akeshet/New-Machine-Drawings/matlab simulations/Slower Design -- Wujie/Readme.txt

The main file with slower simulation is Revised_New_zeeman_design.m
