akeshet/New-Machine-Drawings/matlab simulations/magnetic trap design/README.txt

New magnetic trap design for Bec2 is in New_magtrap_design.m.
