akeshet/New-Machine-Drawings/matlab simulations/magnetic trap design/html/feschbach_coils_01.png

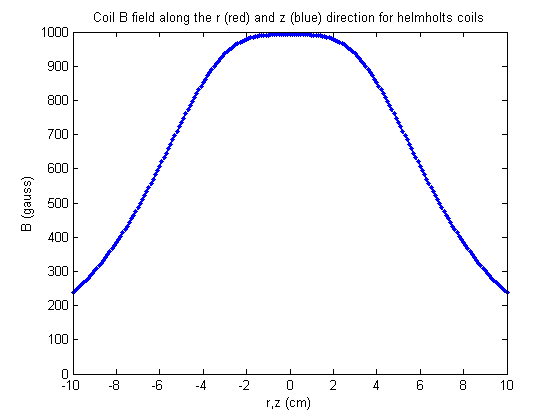
matlab simulations/magnetic trap design/html/feschbach_coils_01.png
