akeshet/New-Machine-Drawings/matlab simulations/magnetic trap design/Magtrap.jpg

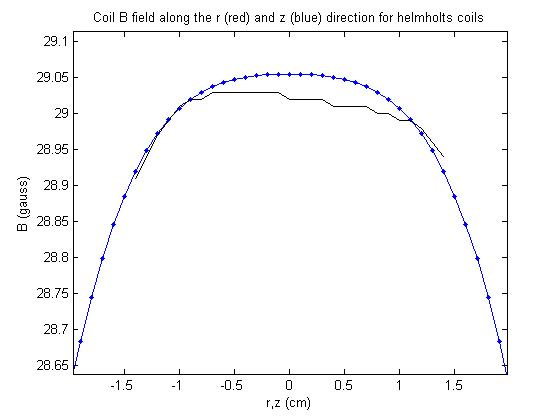
matlab simulations/magnetic trap design/Magtrap.jpg
