akeshet/New-Machine-Drawings/Oven Part Quote Request/custom cup.JPG

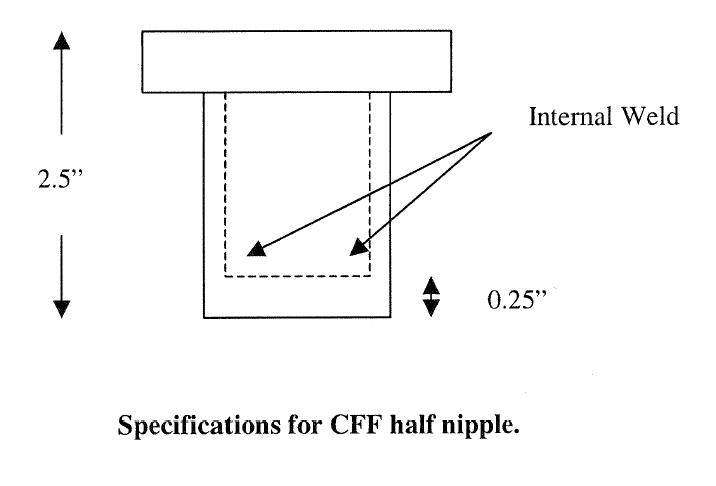
Oven Part Quote Request/custom cup.JPG
