akeshet/New-Machine-Drawings/Oven Part Quote Request/custom flange.JPG

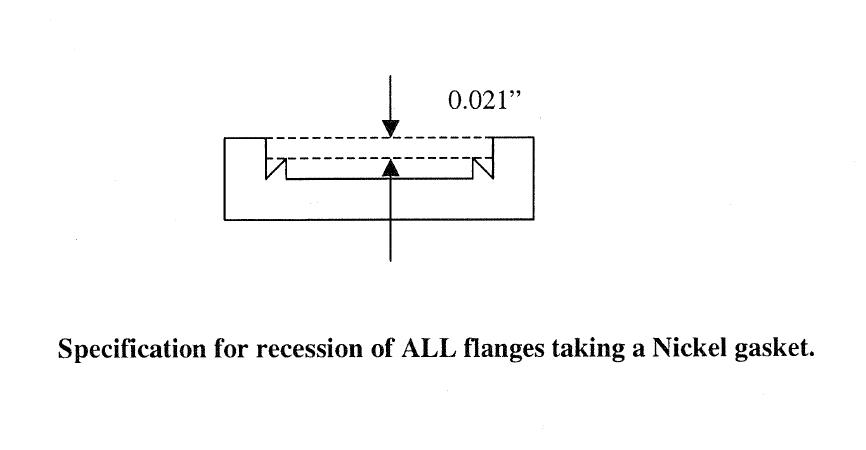
Oven Part Quote Request/custom flange.JPG
