akeshet/New-Machine-Drawings/required vacuum parts inventory.xlsx

Oven Required Inventory
Quantity | Part | Quantity found
2 | 2.75 half-nipple custom knive
1 | 2.75 tee custom knife
2 | 2.75 doublesided blank custom knife (to be machined)
2 | 2.75 standard length nipple
2 | UHV 24p gauges
1 | custom 4.5 to 2.75 6way cross
1 | 2.75 to 4.5 reducer conical
1 | 2.75 to 4.5 reducer conical custom knife
2 | 4.5 elbow
2 | 4.5 to 6 zerolength reducer
2 | 75L/s ion pumps
2 | 4.5 tee
2 | 2.75 to 4.5 zerolength reducer
1 | 4.5 double miniflange feedthrough
1 | gate valve
1 | 2.75 sixway cube
2 | 4.5 uncoated windows
1 | magnetic rotary feedthrough
1 | minlength 2.75 nipple
2 | 2.75 difftube holding double sided flanges
2 | custom difftube assys
2 | 2.75 uncoated windows
1 | all metal 45 degree angle valve 2.75in
1 | right-angle 2.75 valve
1 | 2.75 tubro pump
1 | 4.5 to miniflange slower vacuum tube
Main chamber required inventory
1 | miniflange bellows
1 | UHV 24p gauge
1 | minlength nipple
1 | turbopump
1 | inline angle valve all metal
1 | varian starcell pump
1 | mdc 8 to 6 reducer
1 | 8 to 2.75 zerlength
1 | 2.75 standard or minlength nipple for TiSub standoff?
1 | TiSub pump cartridge
