akeshet/New-Machine-Drawings/Na table enclosure/Na enclosure materials.xlsx

Line # | Part # | Quantity | Internal reference | Description | Cut to Length (inches) | Additional machining operations
1 | 1515 | 2 | Upper long | Extrusion | 122.06 | 7040 sides A and C, both ends. 7257 side B at 6, 18, 30, 42, and 54 inches from left end and right end (10 places total)
2 | 1515 | 4 | Upper short | Extrusion | 60.19 | 7040 sides A and C, both ends.
3 | 1515 | 4 | Corner post | Extrusion | 52
4 | 1515 | 2 | Midpost | Extrusion | 50.5 | 7040 sides A and C, one end only.
5 | 1515 | 4 | Lower long | Extrusion | 60.28 | 7040 sides A and C, both ends.
6 | 1010 | 8 | support bar | Extrusion | 57.88
7 | 1010 | 32 | Door vert | Extrusion | 46.5 | 7061 both ends. 7051 Access holes, style C, in S, both ends
8 | 1010 | 16 | Door wide | Extrusion | 13.5 | 7061 both ends
9 | 1010 | 16 | Door narrow | Extrusion | 12.38 | 7061 both ends
10 | 2610 | 8 | Panel wide | Panel |  | 7155 Cut to size 14 x 45 inches
11 | 2610 | 8 | Panel narrow | Panel |  | 7155 Cut to size 12.88 x 45 inches
12 | 3383 | 64 |  | Single tab end fastener
13 | 3098 | 24 |  | Double anchor fastener
14 | 2059 | 8 |  | Door hanger
15 | 2067 | 8 |  | Door glide
16 | 2103 | 16 |  | Inter-series hinge
17 | 2066 | 16 |  | Within-series hinge
18 | 2079 | 24 |  | Offset door handle
19 | 4515 | 16 |  | Interseries joining plate
20 | 3321 | 32 |  | 10 series nut
21 | 3320 | 32 |  | 15 series nut
22 | 2116 | 170 feet |  | Rubber panel gasket
