akeshet/New-Machine-Drawings/8020 enclosure rev2/enclosure rev2 parts list.xlsx

Line # | Part # | Quantity | Internal reference | Description | Length (inches) | Additional machining operations
1 | 1515 | 2 | Upper long | Extrusion | 97.875 | 7010 to length. 7040 sides A and C, both ends. 7257 side A at 6" and 32" from Left End and 6" and 32" from Right End
2 | 1515 | 5 | Upper short | Extrusion | 60.875 | 7010 to length. 7040 sides A and C, both ends. 7257 side A at 6" and 24" from Left End and 6" and 24" from Right End
3 | 2899 | 20 |  | Wiring duct
4 | 2555 | 10 |  | 45 degree support
5 | 1515 | 4 | custom support | Extrusion | 20 | 7010 to length. 7080 Miter cut and counterbore both ends, A=20. Custom cut applied to both ends, see attached drawing B.
6 | 1515 | 4 | corner post | Extrusion | 60 | 7010 to length.
7 | 1515 | 2 | midpost | Extrusion | 58.5 | 7010 to length. 7040 sides A and C, one end only.
8 | 1010 | 8 | guidebar | Extrusion | 45.79 | 7010 to length
9 | 1010 | 32 | door vertical | Extrusion | 54.5 | 7010 to length. 7061 both ends. 7051 Access holes, style C, in S, both ends
10 | 1010 | 16 | door wide | Extrusion | 10.48 | 7010 to length. 7061 both ends.
11 | 1010 | 16 | door narrow | Extrusion | 9.36 | 7010 to length. 7061 both ends.
12 | 2610 | 8 | panel wide | Panel |  | 7155 Cut to size 8.98 x 53 inches | I made a size error
13 | 2610 | 8 | panel narrow | Panel |  | 7155 Cut to size 7.86 x 53 inches
14 | 1515 | 4 | lower long | Extrusion | 48.19 | 7010 cut to length. 7040 sides A and C, both ends.
Replacement order for panels
1 | 2610 | 8 | panel wide | Panel |  | 7155 Cut to size 10.98 x 53 inches
2 | 2610 | 8 | panel narrow | Panel |  | 7155 Cut to size 9.86 x 53 inches
