akeshet/New-Machine-Drawings/approximate sketches/bimba stage asm.SLDASM

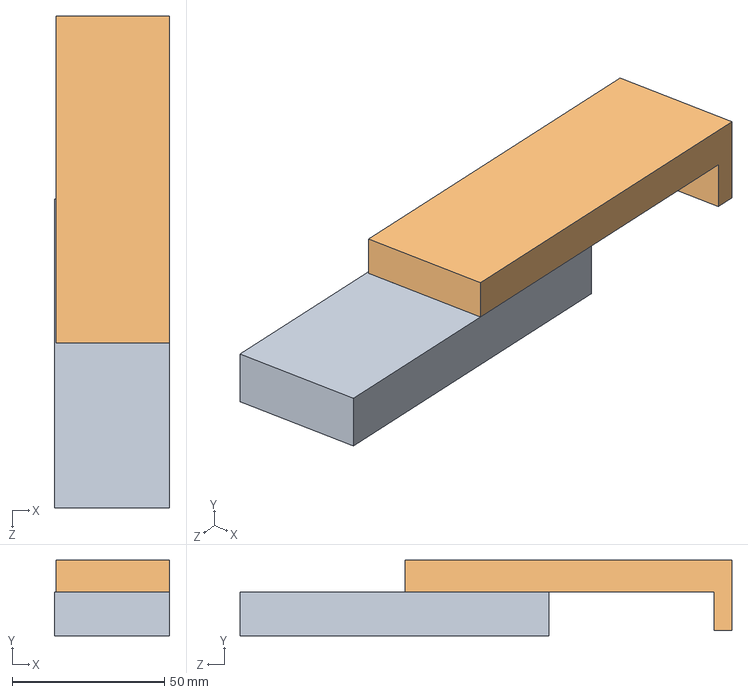
[picture p5: CAD file, 2011-03-22]
approximate sketches/bimba stage asm.SLDASM
37.8 x 24.9 x 161.7 mm
bimba base
bimba stage
