akeshet/New-Machine-Drawings/Fermi1/minilength_nipple.SLDASM

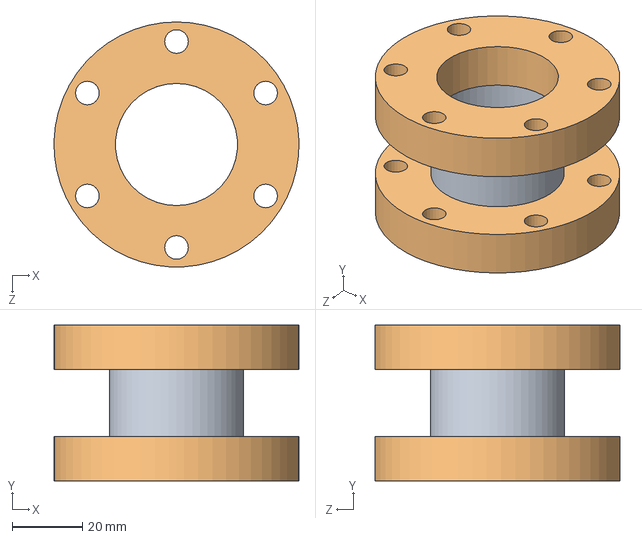
[picture p6: CAD file, 2011-03-22]
Fermi1/minilength_nipple.SLDASM
69.8 x 44.5 x 69.8 mm
minilength_nipple_tube
2.75in_CF_flange x 2
