akeshet/New-Machine-Drawings/studies/before angled pump body/main_chamber.SLDPRT

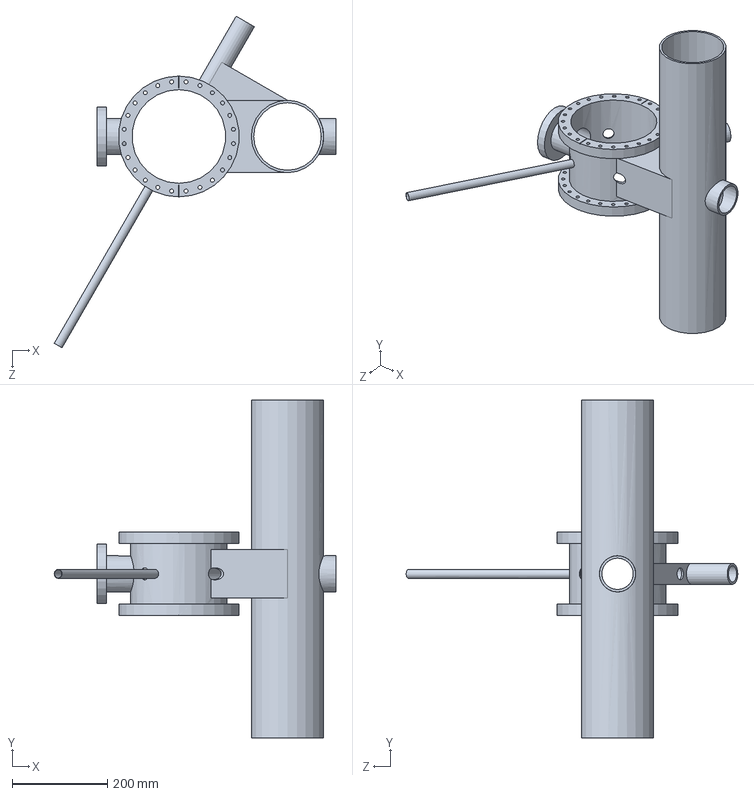
[picture p7: CAD file, 2011-03-22]
studies/before angled pump body/main_chamber.SLDPRT
592.4 x 711.2 x 697.8 mm
