akeshet/New-Machine-Drawings/studies/multiport_study/multiport_study.SLDASM

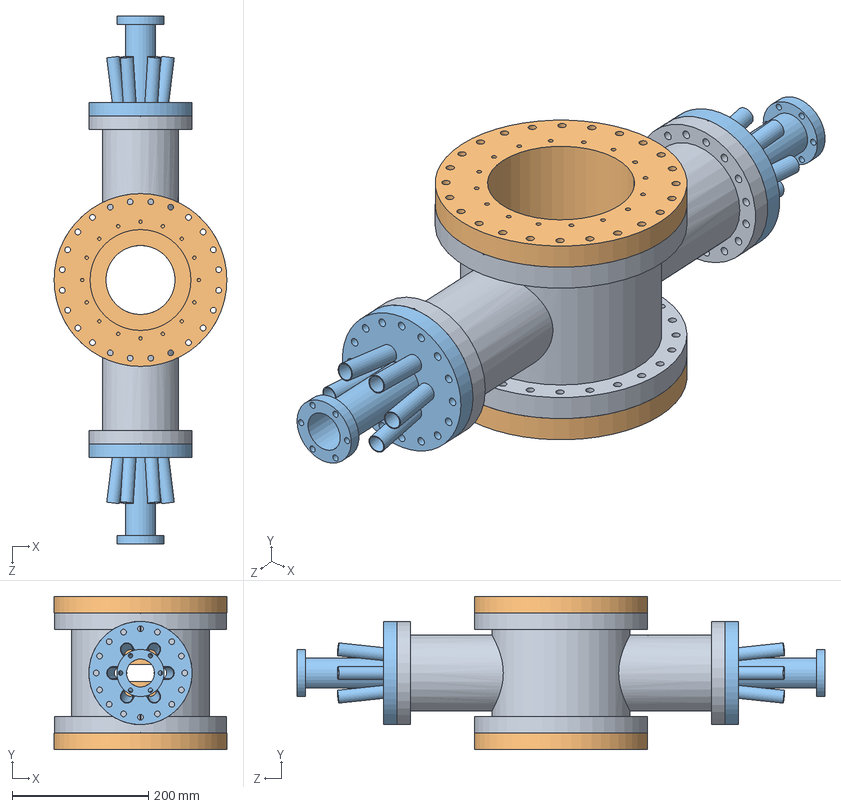
[picture p8: CAD file, 2011-03-22]
studies/multiport_study/multiport_study.SLDASM
254.0 x 225.6 x 776.2 mm
main_chamber
fermi1 bucket nofeedthrough x 2
custom multiport window x 2
