akeshet/New-Machine-Drawings/top imaging stack.SLDASM

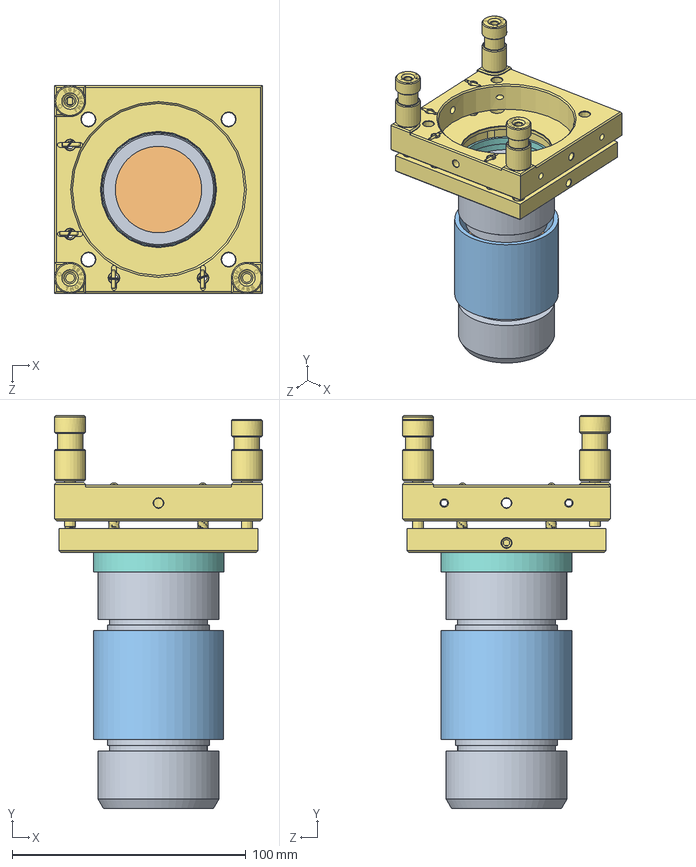
[picture p9: CAD file, 2012-07-12]
top imaging stack.SLDASM
89.0 x 168.2 x 89.0 mm
special optics lens footprint x 2
top imaging dichroic
top imaging custom length tube
thorlabs sm2a6 customized for top lens assy
sm2 retaining ring
thorlabs ae0505d08f piezo x 3
KC2
sm2l03
