akeshet/New-Machine-Drawings/8020 enclosure rev2/enclosure rev2.SLDASM

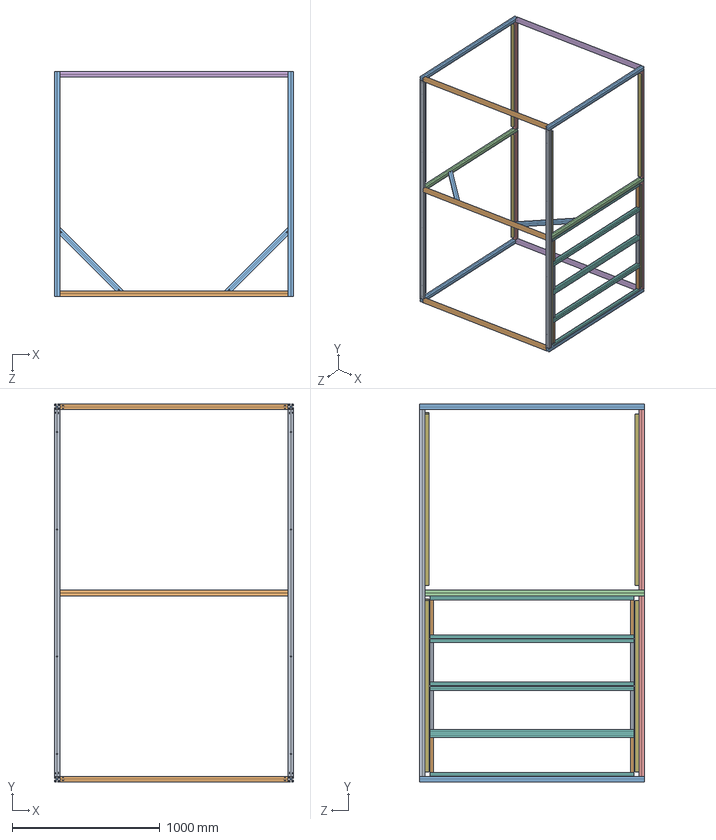
[picture p10: CAD file, 2012-07-12]
8020 enclosure rev2/enclosure rev2.SLDASM
1622.4 x 2562.2 x 1524.0 mm
upper long x 2
upper short x 3
corner post x 4
mid post x 2
lower long x 4
lower short x 2
guidebar x 8
door vertical x 8
door wide x 4
door narrow x 4
45 degree support beam x 2
