akeshet/New-Machine-Drawings/Na table enclosure/Na wide door.SLDASM

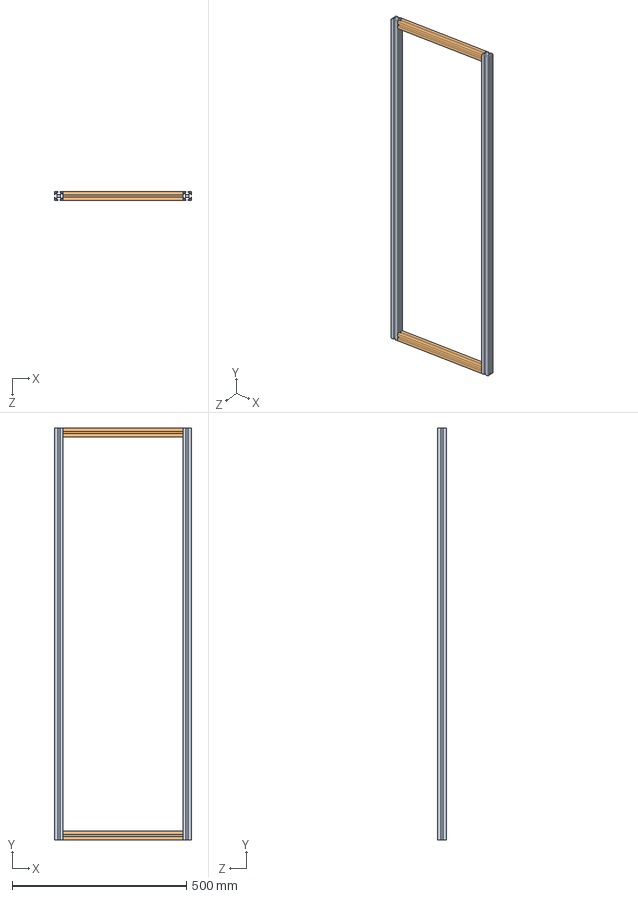
[picture p11: CAD file, 2011-12-12]
Na table enclosure/Na wide door.SLDASM
393.7 x 1181.1 x 25.4 mm
Na door vert x 2
Na wide door horiz x 2
