akeshet/New-Machine-Drawings/studies/multiport_study/main_chamber.SLDPRT

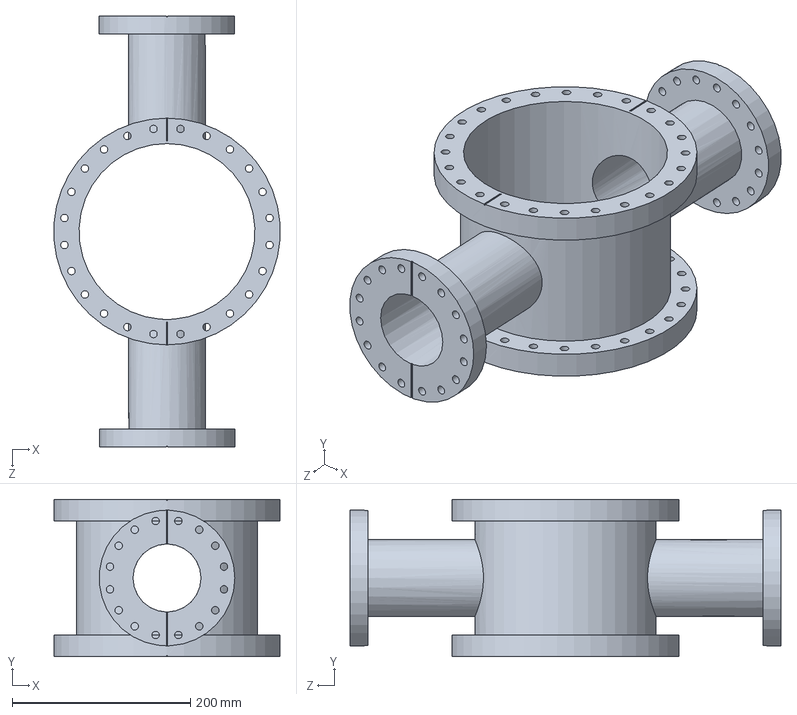
[picture p12: CAD file, 2011-03-22]
studies/multiport_study/main_chamber.SLDPRT
253.3 x 176.3 x 482.6 mm
