akeshet/New-Machine-Drawings/swagelok/return manifold staggered.SLDASM

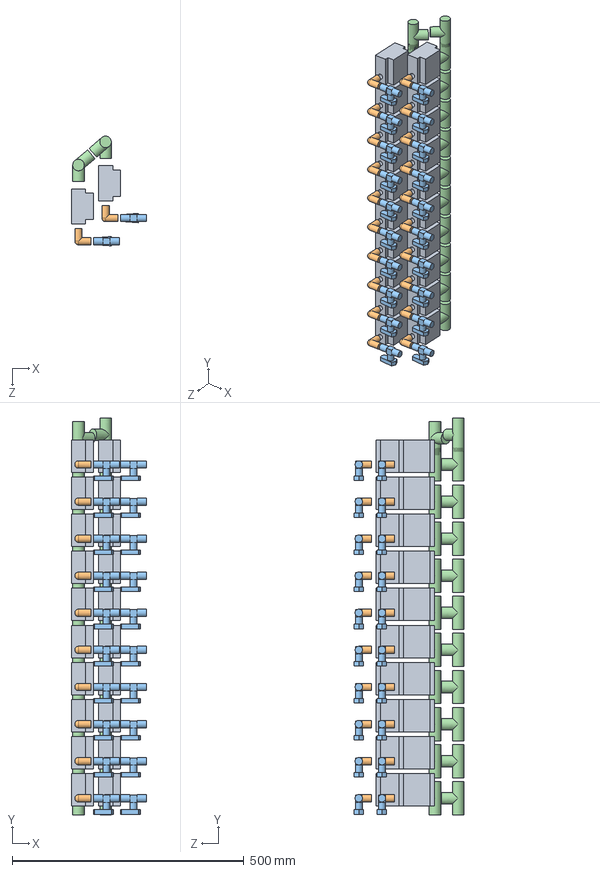
[picture p13: CAD file, 2012-07-12]
swagelok/return manifold staggered.SLDASM
162.6 x 856.3 x 237.1 mm
proteus flow meter x 20
swagelok 400-9 elbow x 20
swagelok 42S4 valve x 20
swagelok 810-3 union x 22
