akeshet/New-Machine-Drawings/studies/2 inch window, close coils/central_vacuum_system.SLDASM

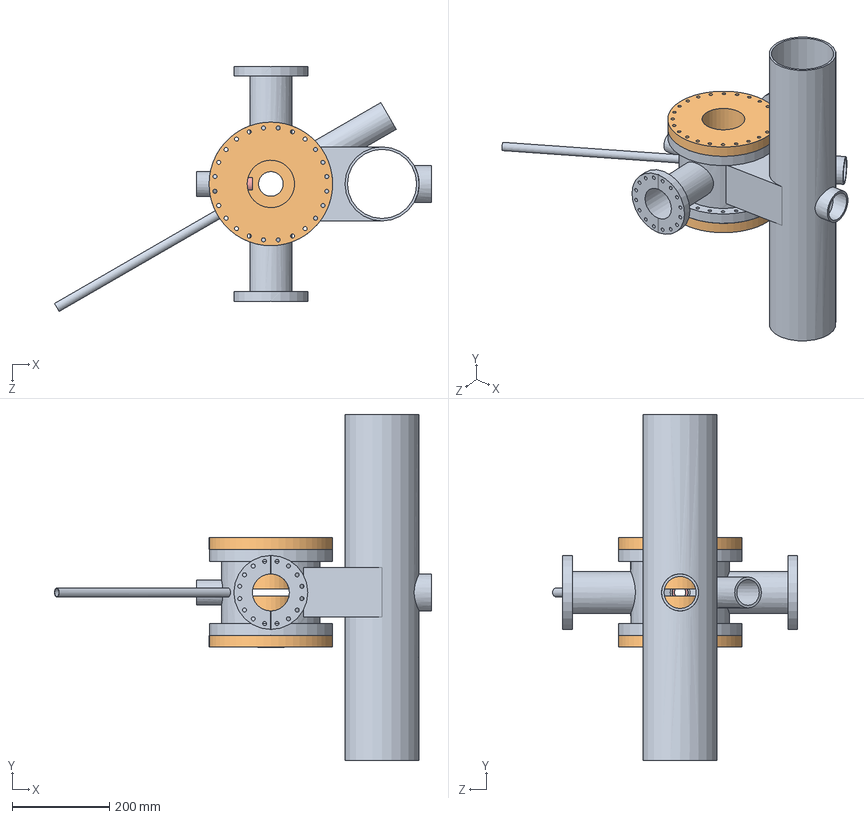
[picture p14: CAD file, 2011-03-22]
studies/2 inch window, close coils/central_vacuum_system.SLDASM
774.9 x 711.2 x 503.5 mm
main_chamber
Top Bucket x 2
2 inch lens tube
top coil
mititoyu objective M Plan NIR 5X
