akeshet/New-Machine-Drawings/swagelok/valved flow meter return subunit.SLDASM

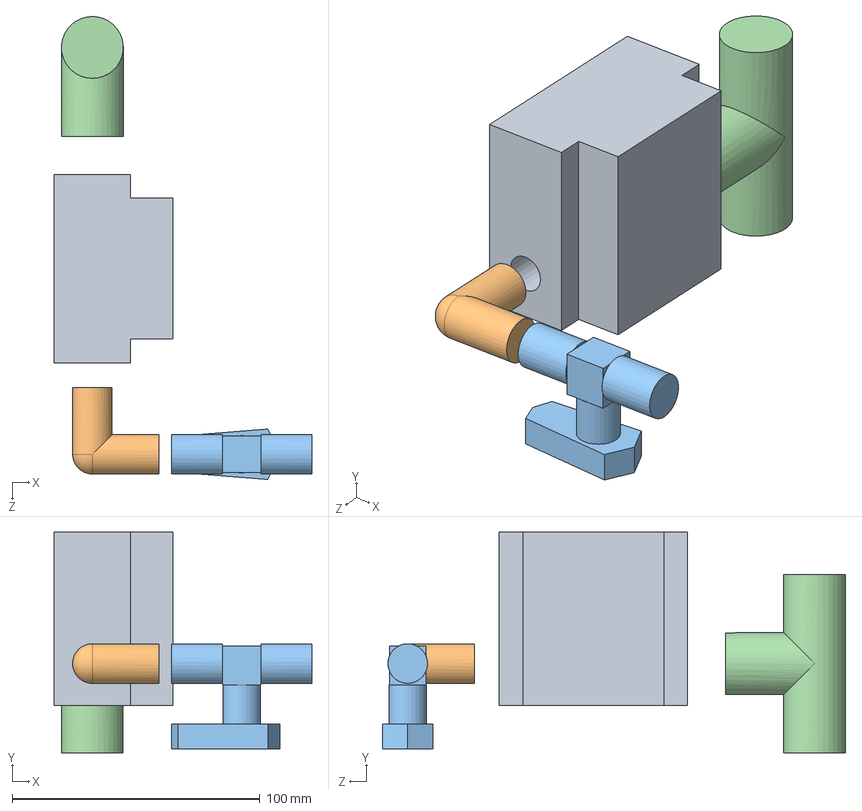
[picture p15: CAD file, 2012-07-12]
swagelok/valved flow meter return subunit.SLDASM
104.2 x 89.2 x 187.1 mm
proteus flow meter
swagelok 400-9 elbow
swagelok 42S4 valve
swagelok 810-3 union
