akeshet/New-Machine-Drawings/Na table enclosure/Na narrow door.SLDASM

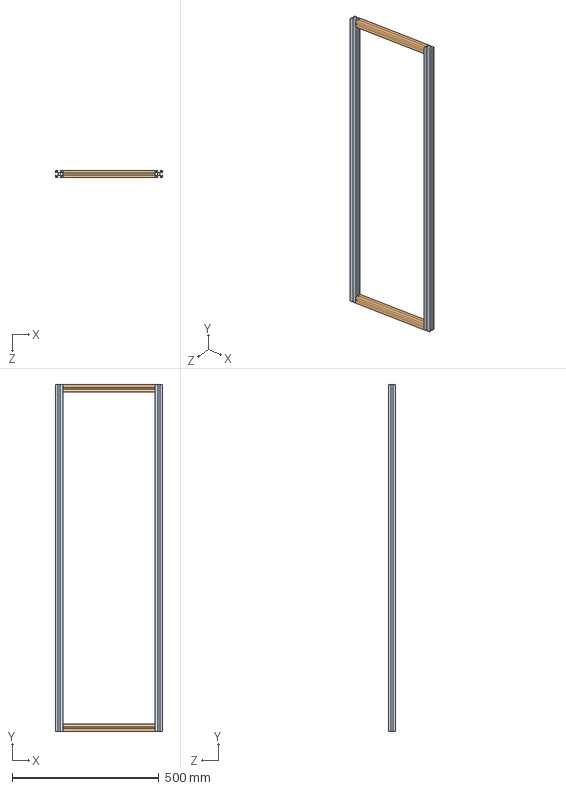
[picture p16: CAD file, 2011-12-12]
Na table enclosure/Na narrow door.SLDASM
365.3 x 1181.1 x 25.4 mm
Na door vert x 2
Na narrow door horiz x 2
