akeshet/New-Machine-Drawings/swagelok/manifold single valve reducing t subunit.SLDASM

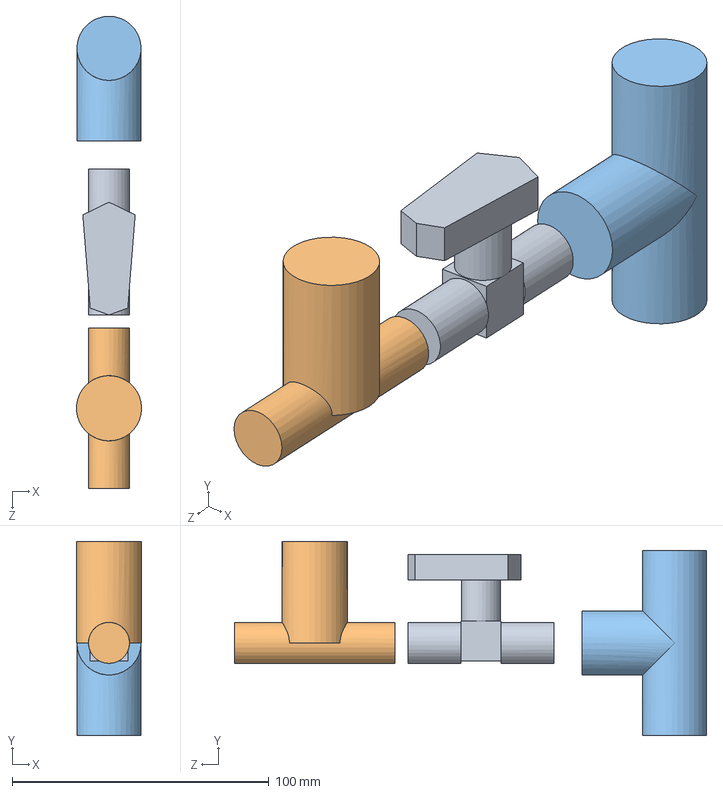
[picture p17: CAD file, 2012-07-12]
swagelok/manifold single valve reducing t subunit.SLDASM
25.4 x 75.6 x 184.0 mm
swagelok 42S4 valve
swagelok b-4tf-90 filter
swagelok 810-3 union
