akeshet/New-Machine-Drawings/8020 enclosure rev2/narrow door.SLDASM

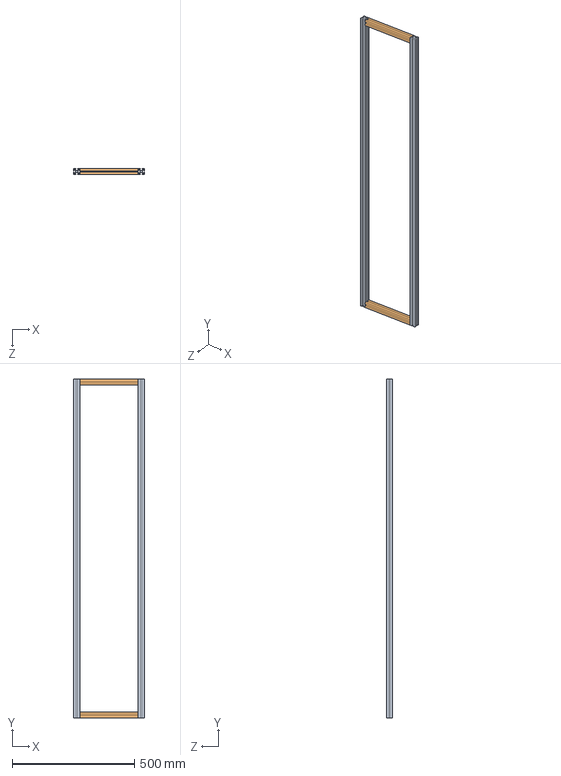
[picture p18: CAD file, 2012-07-12]
8020 enclosure rev2/narrow door.SLDASM
288.7 x 1384.3 x 25.4 mm
door vertical x 2
door narrow x 2
