akeshet/New-Machine-Drawings/swagelok/supply manifold.SLDASM

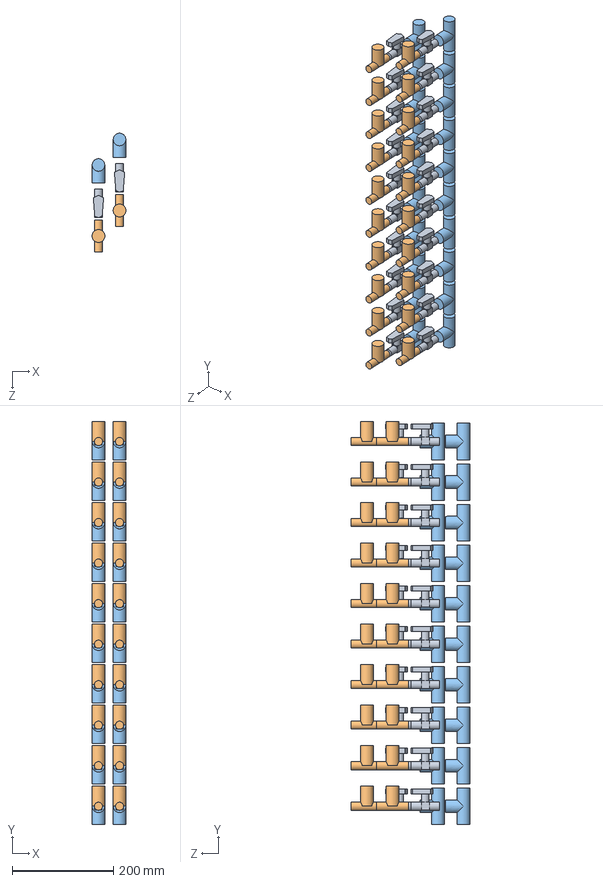
[picture p19: CAD file, 2012-07-12]
swagelok/supply manifold.SLDASM
67.0 x 795.6 x 234.4 mm
swagelok 42S4 valve x 20
swagelok b-4tf-90 filter x 20
swagelok 810-3 union x 20
