akeshet/New-Machine-Drawings/second dp tube stage.SLDASM

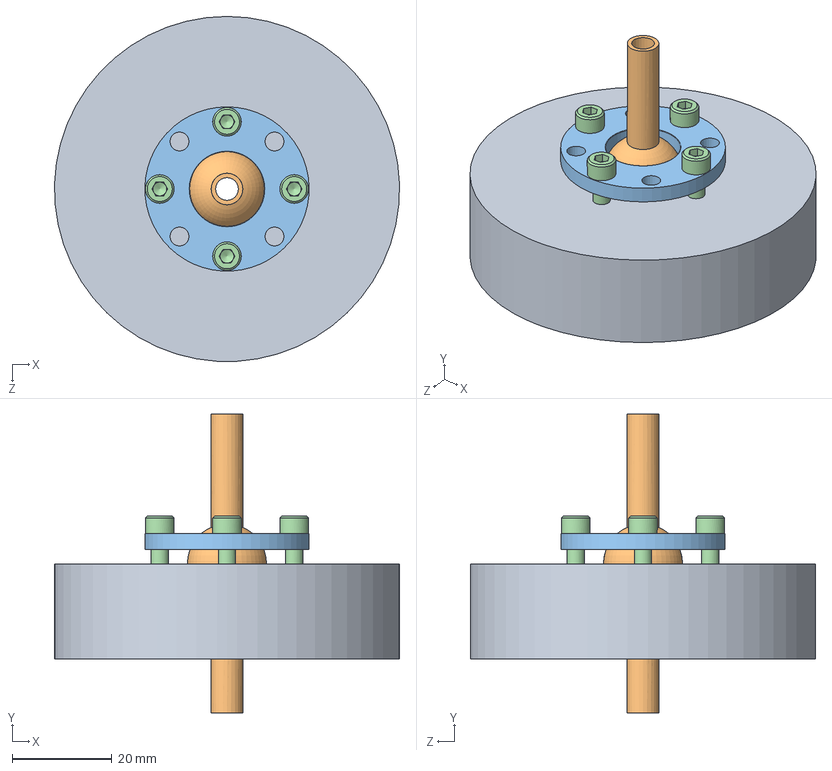
[picture p20: CAD file, 2012-07-12]
second dp tube stage.SLDASM
69.3 x 60.0 x 69.3 mm
movable dp tube holder
second dp tube
movable dp retainer
Socket Head Cap Screw_AI x 4
