akeshet/New-Machine-Drawings/8020 enclosure rev2/wide door.SLDASM

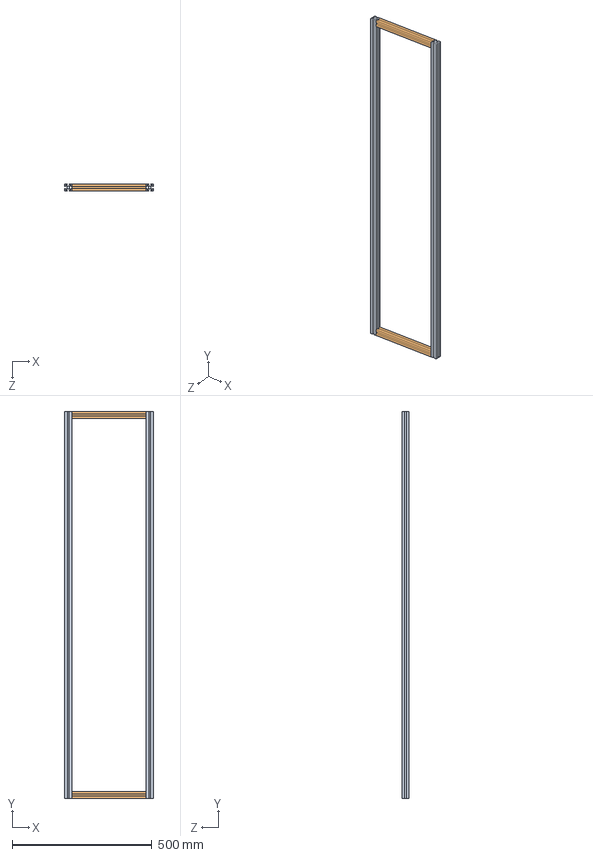
[picture p21: CAD file, 2012-07-12]
8020 enclosure rev2/wide door.SLDASM
317.1 x 1384.3 x 25.4 mm
door vertical x 2
door wide x 2
