akeshet/New-Machine-Drawings/shutter assembly.SLDASM

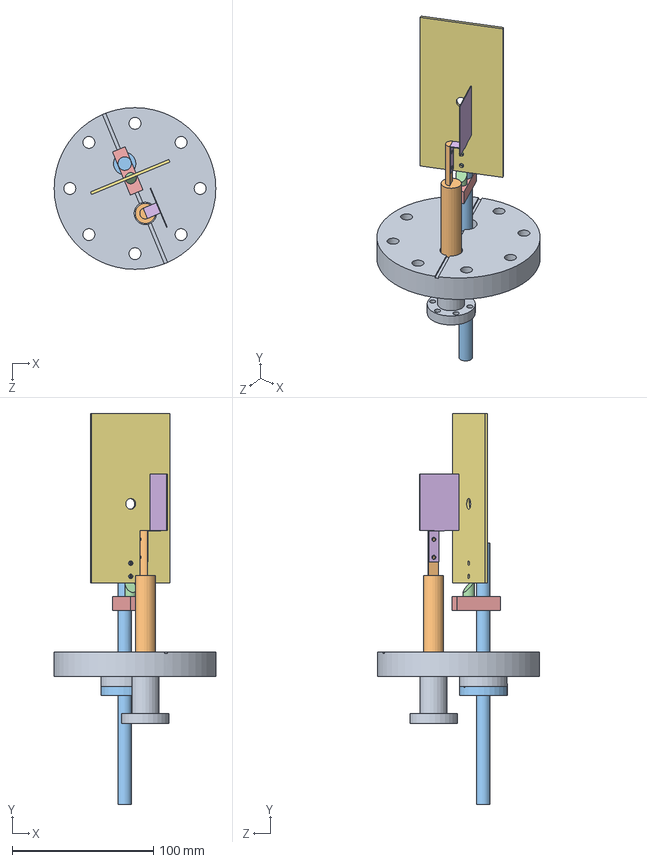
[picture p22: CAD file, 2012-07-12]
shutter assembly.SLDASM
114.3 x 276.4 x 114.3 mm
4.5 double mini feedthrough
shutter shaft
collimation rod
mdc flag holder
mdc rod clamp
Flag
Collimation Plate
