akeshet/New-Machine-Drawings/swagelok/20io water manifold.SLDASM

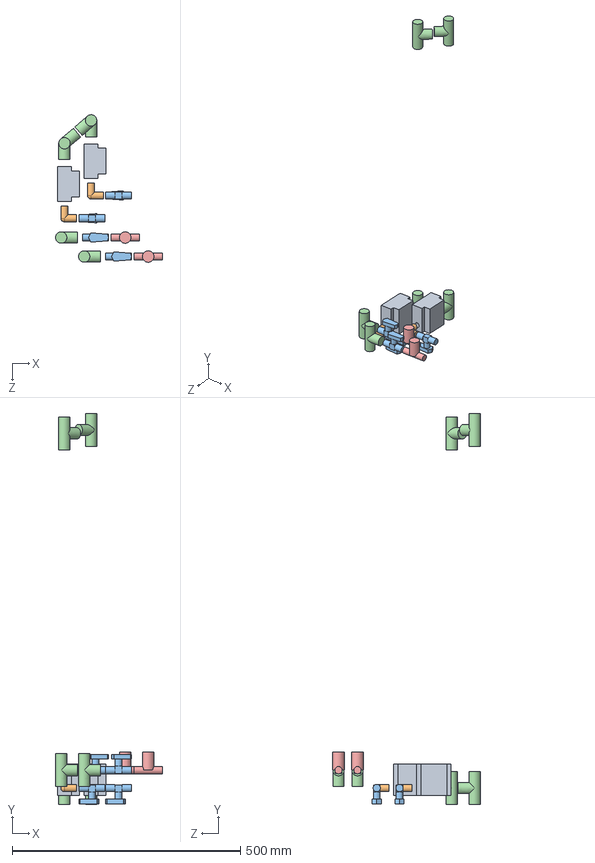
[picture p23: CAD file, 2011-08-22]
swagelok/20io water manifold.SLDASM
234.4 x 856.3 x 323.3 mm
proteus flow meter x 2
swagelok 400-9 elbow x 2
swagelok 42S4 valve x 4
swagelok 810-3 union x 6
swagelok b-4tf-90 filter x 2
