akeshet/New-Machine-Drawings/movable dp tube stage.SLDASM

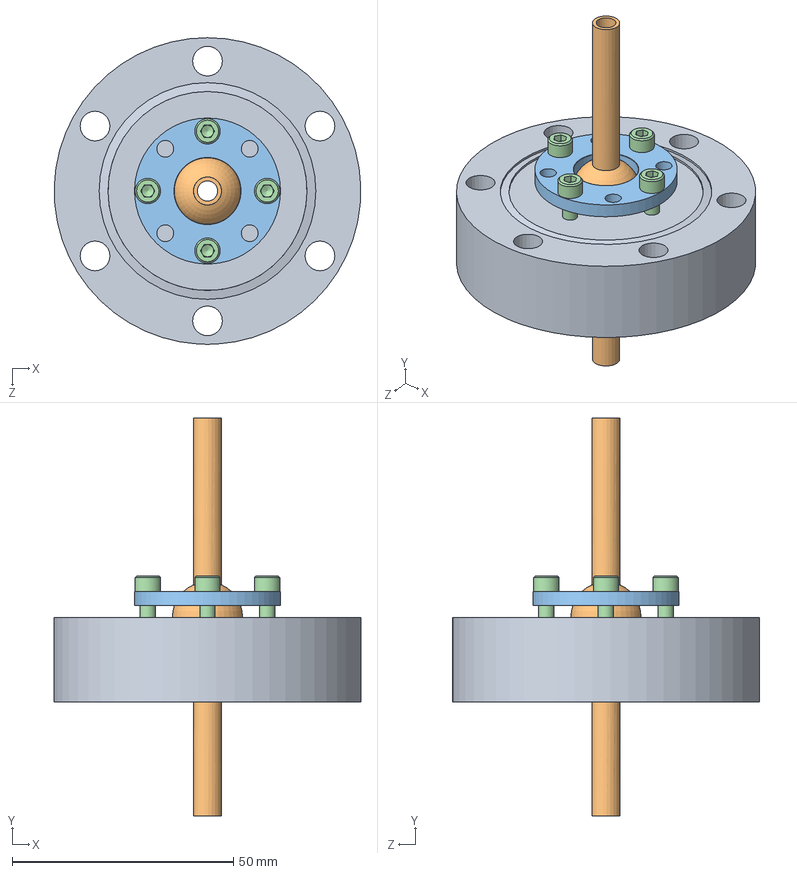
[picture p24: CAD file, 2012-07-12]
movable dp tube stage.SLDASM
69.3 x 90.0 x 69.3 mm
movable dp tube holder
movable dp tube
movable dp retainer
Socket Head Cap Screw_AI x 4
