akeshet/New-Machine-Drawings/Na table enclosure/Na enclosure.SLDASM

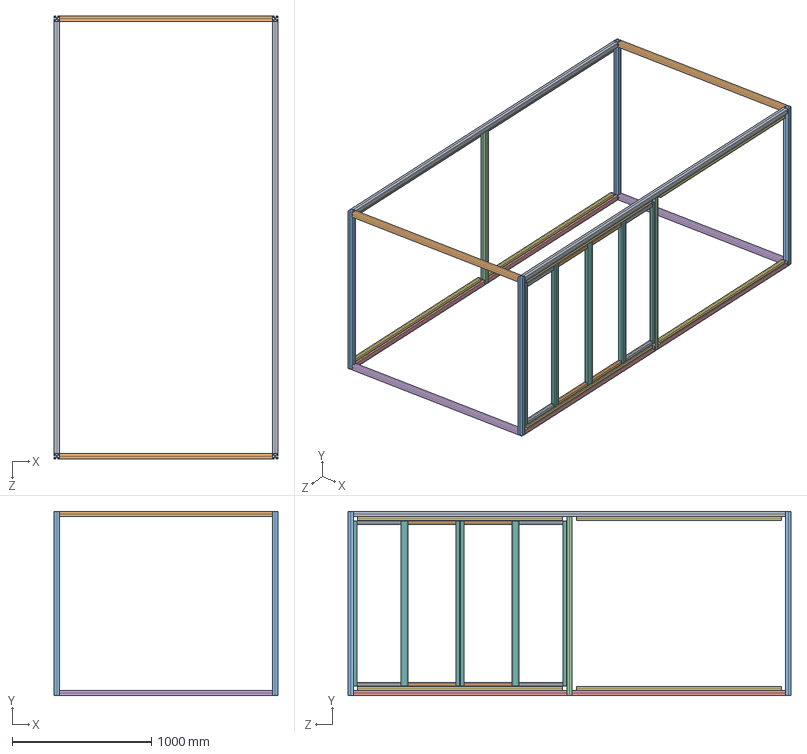
[picture p25: CAD file, 2011-12-12]
Na table enclosure/Na enclosure.SLDASM
1605.0 x 1320.8 x 3176.6 mm
Na upper long x 2
Na upper short x 2
Na corner post x 4
Na midpost x 2
Na lower side x 4
Na lower end x 2
Na support bar x 8
Na door vert x 8
Na narrow door horiz x 4
Na wide door horiz x 4
