akeshet/New-Machine-Drawings/studies/2 inch window, close coils/main_chamber.SLDPRT

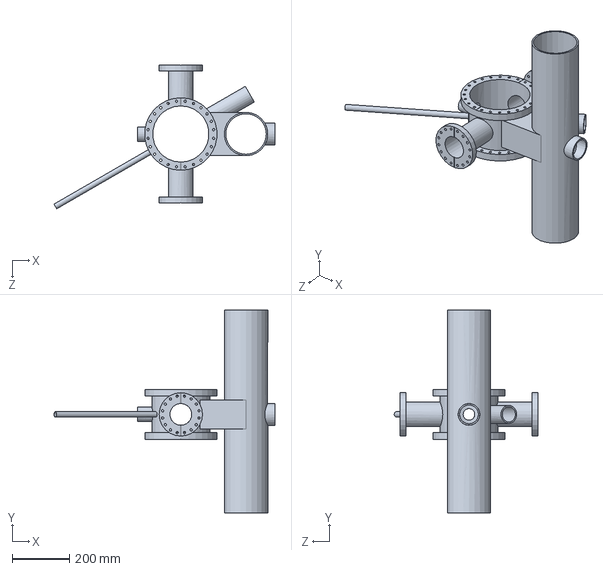
[picture p26: CAD file, 2011-03-22]
studies/2 inch window, close coils/main_chamber.SLDPRT
774.9 x 711.2 x 503.5 mm
