akeshet/New-Machine-Drawings/studies/before angled pump body/central_vacuum_system.SLDASM

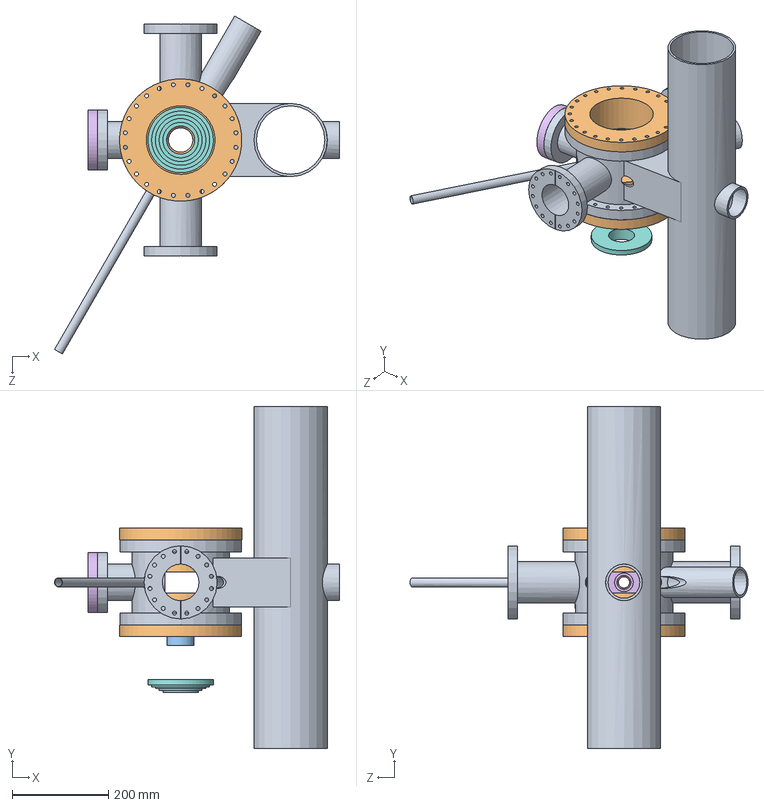
[picture p27: CAD file, 2011-03-22]
studies/before angled pump body/central_vacuum_system.SLDASM
592.4 x 711.2 x 702.5 mm
main_chamber
Top Bucket x 2
2 inch lens tube
top coil
mititoyu objective M Plan NIR 5X
side bucket
coil
top coil alternate design 1 x 2
