akeshet/New-Machine-Drawings/swagelok/return manifold.SLDASM

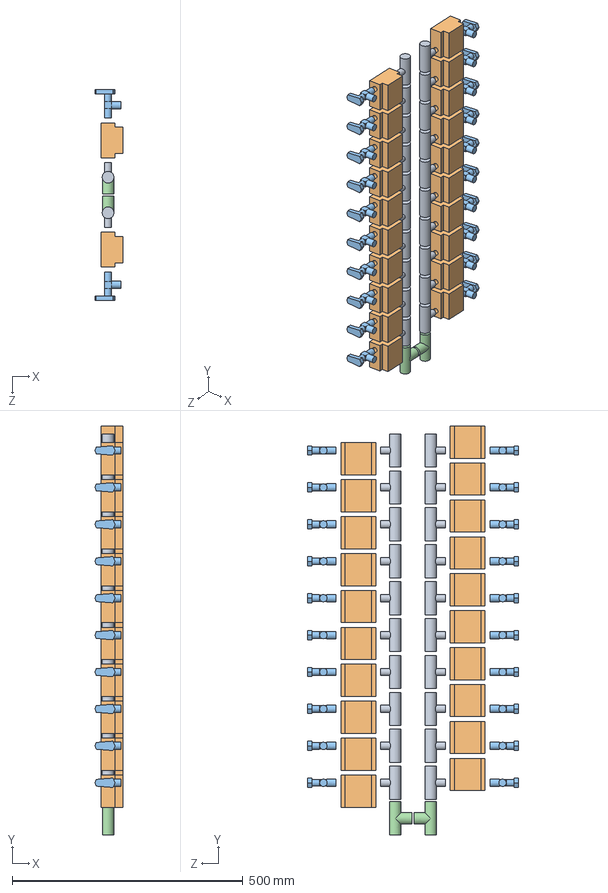
[picture p28: CAD file, 2011-05-13]
swagelok/return manifold.SLDASM
60.9 x 886.3 x 457.3 mm
swagelok 810-3-8-3 reducing union t x 20
proteus flow meter x 20
swagelok 42S4-a valve x 20
swagelok 810-3 union x 2
