akeshet/New-Machine-Drawings/studies/before angled pump body/top bucket assem.SLDASM

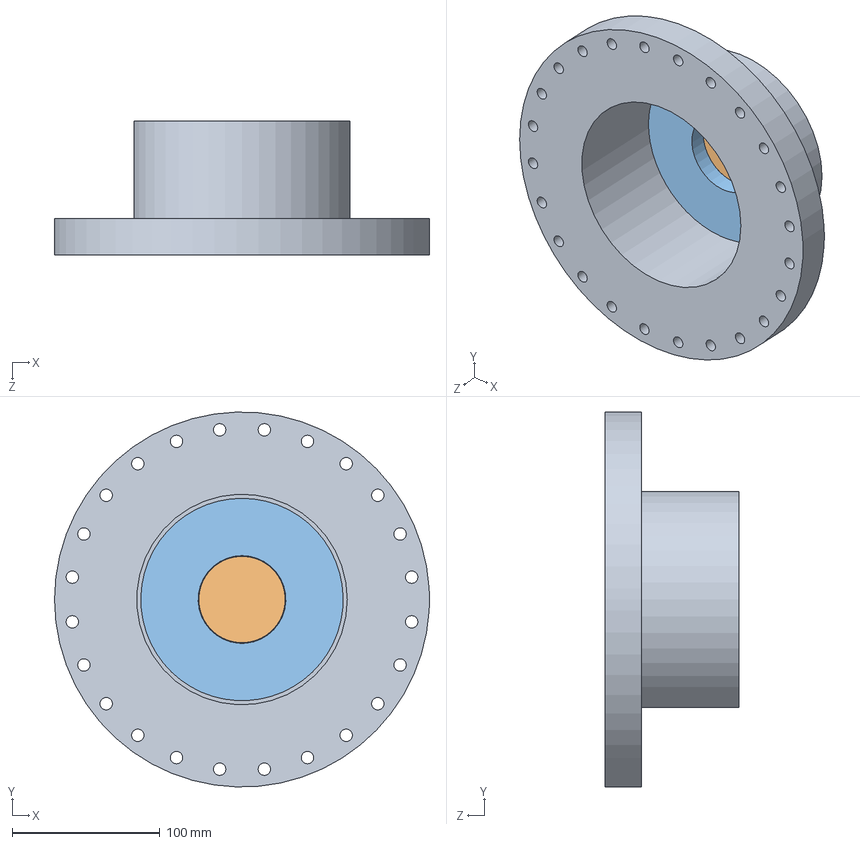
[picture p29: CAD file, 2011-03-22]
studies/before angled pump body/top bucket assem.SLDASM
254.0 x 253.9 x 90.6 mm
Top Bucket
top window
top coil
