akeshet/New-Machine-Drawings/swagelok/manifold dual valve breakout subunit.SLDASM

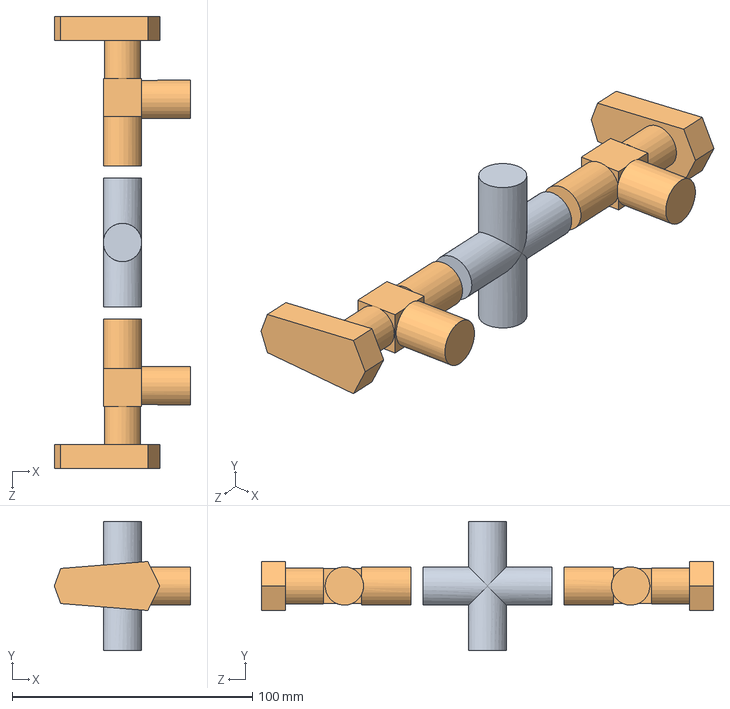
[picture p30: CAD file, 2011-05-13]
swagelok/manifold dual valve breakout subunit.SLDASM
56.8 x 53.8 x 188.1 mm
swagelok 400-4 union cross
swagelok 42S4-a valve x 2
