akeshet/New-Machine-Drawings/swagelok/20 output union cross valved manifold.SLDASM

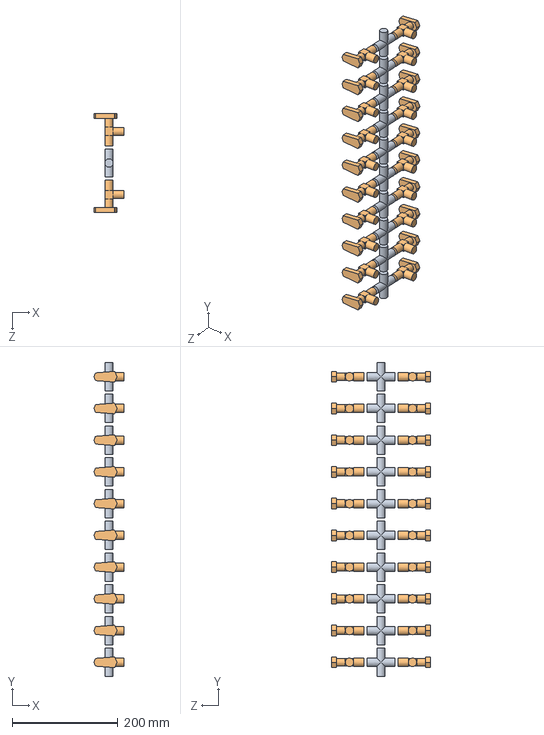
[picture p31: CAD file, 2011-05-13]
swagelok/20 output union cross valved manifold.SLDASM
56.8 x 593.8 x 188.1 mm
swagelok 400-4 union cross x 10
swagelok 42S4-a valve x 20
