akeshet/New-Machine-Drawings/Fermi1/2.75in_tee.SLDASM

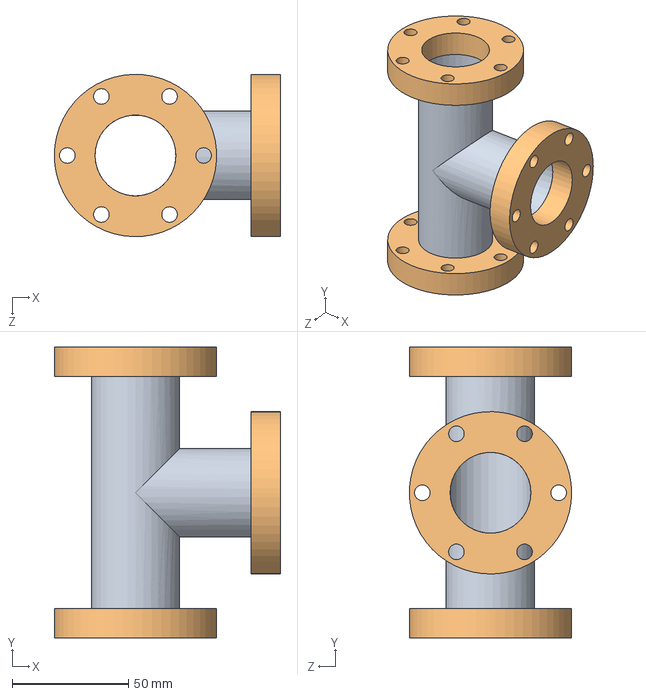
[picture p32: CAD file, 2011-03-22]
Fermi1/2.75in_tee.SLDASM
97.4 x 125.2 x 69.8 mm
2.75in_tee_tube
2.75in_CF_flange x 3
