akeshet/New-Machine-Drawings/Fermi1/gatevalve.SLDASM

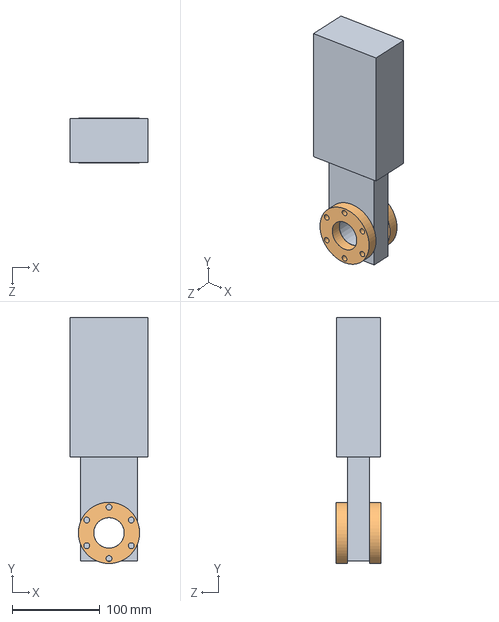
[picture p33: CAD file, 2011-03-22]
Fermi1/gatevalve.SLDASM
88.9 x 280.5 x 50.8 mm
gatevalve_body
2.75in_CF_flange x 2
