akeshet/New-Machine-Drawings/Fermi1/2.75-4.5in_reducer.SLDASM

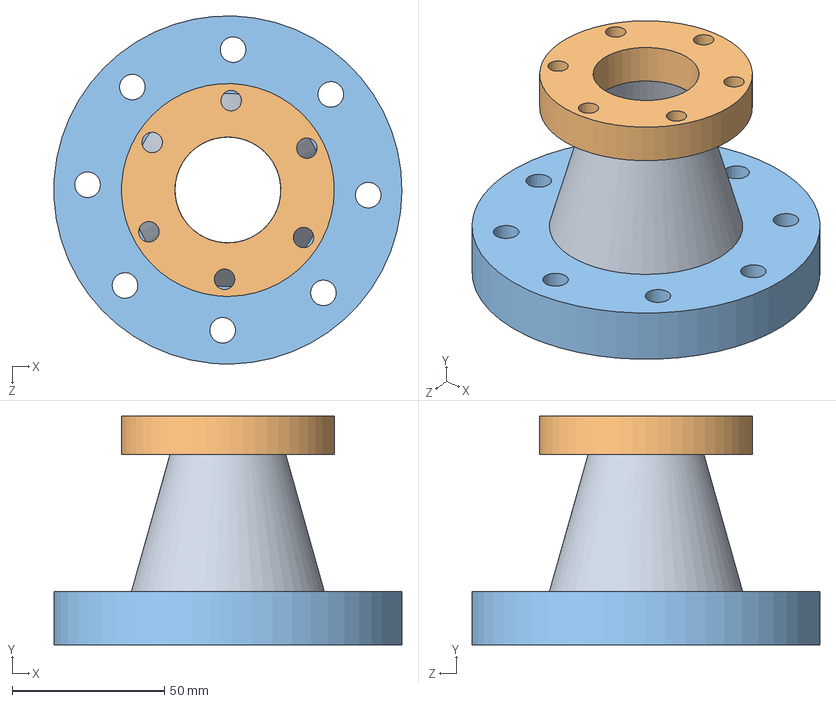
[picture p34: CAD file, 2011-03-22]
Fermi1/2.75-4.5in_reducer.SLDASM
114.2 x 75.2 x 114.2 mm
2.75-4.5in_reducer_tube
2.75in_CF_flange
4.5in_CF_flange
