akeshet/New-Machine-Drawings/main_chamber.SLDPRT

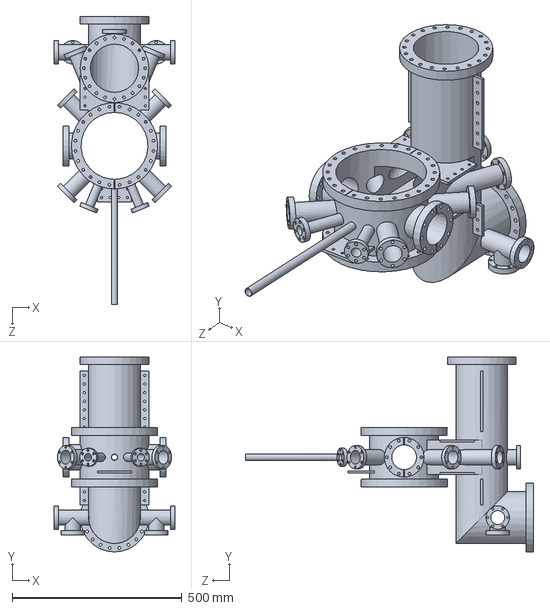
[picture p35: CAD file, 2011-08-22]
main_chamber.SLDPRT
355.6 x 574.2 x 848.4 mm
