akeshet/New-Machine-Drawings/Fermi1/2.75in_sixway.SLDASM

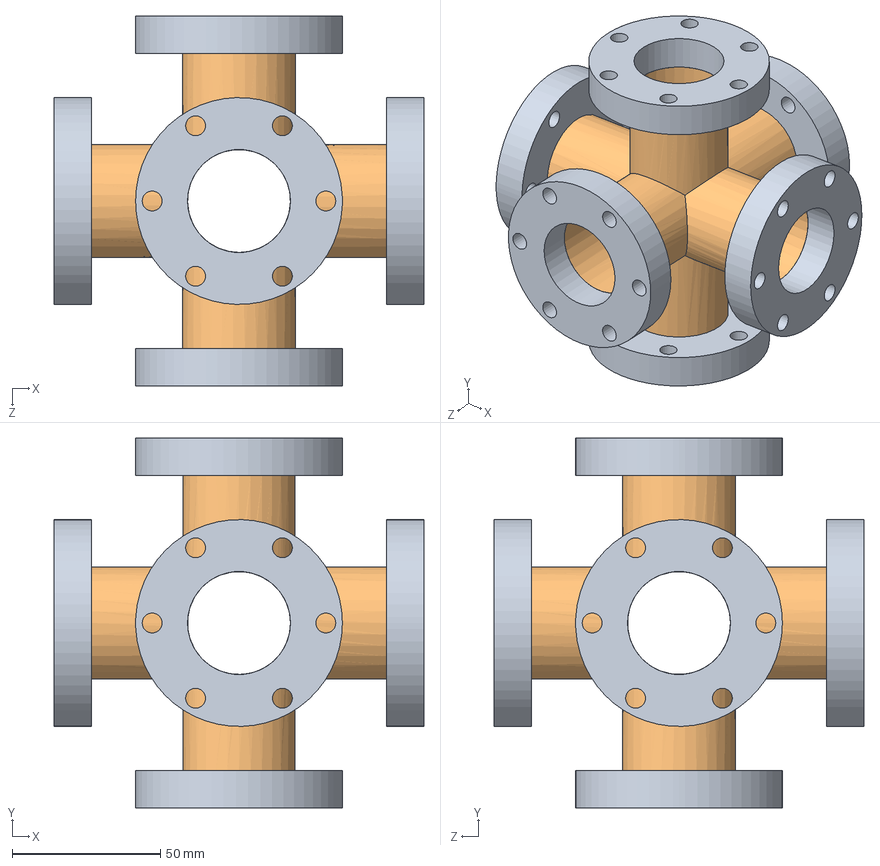
[picture p36: CAD file, 2011-03-22]
Fermi1/2.75in_sixway.SLDASM
125.0 x 125.0 x 125.0 mm
2.75in_CF_flange x 6
2.75in_sixway_tube
