akeshet/New-Machine-Drawings/Fermi1/custom_sixway.SLDASM

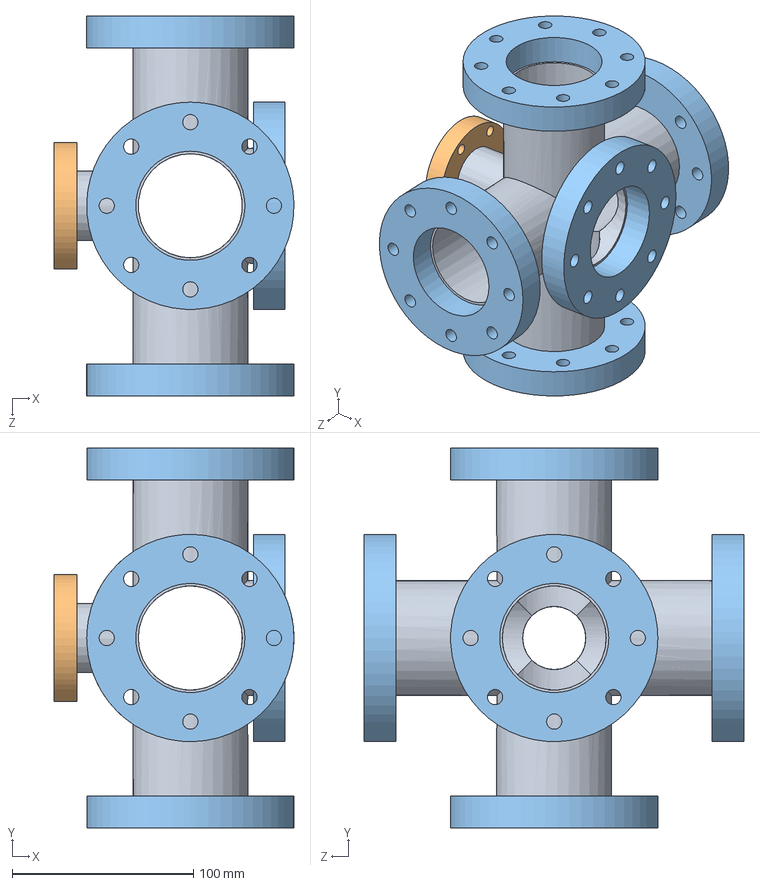
[picture p37: CAD file, 2011-03-22]
Fermi1/custom_sixway.SLDASM
132.3 x 209.3 x 209.6 mm
sixway_tube
2.75in_CF_flange
4.5in_CF_flange x 5
