akeshet/New-Machine-Drawings/Fermi1/main chamber_081908.SLDPRT

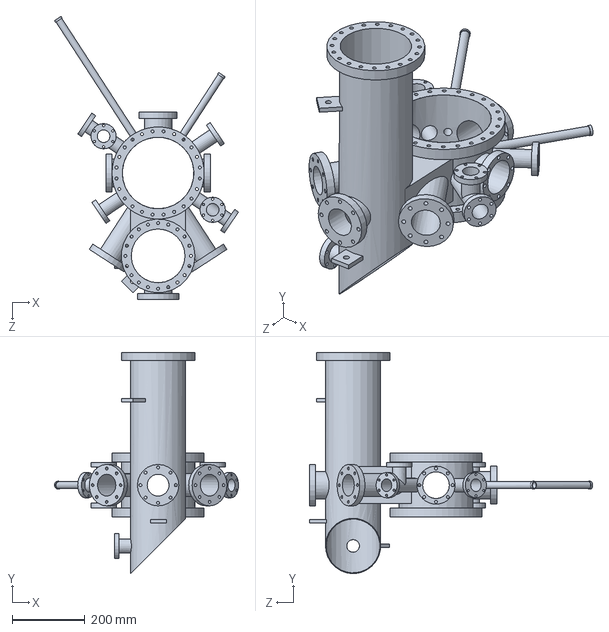
[picture p38: CAD file, 2011-03-22]
Fermi1/main chamber_081908.SLDPRT
507.4 x 609.4 x 781.2 mm
