akeshet/New-Machine-Drawings/Fermi1/trapping chamber whole.SLDASM

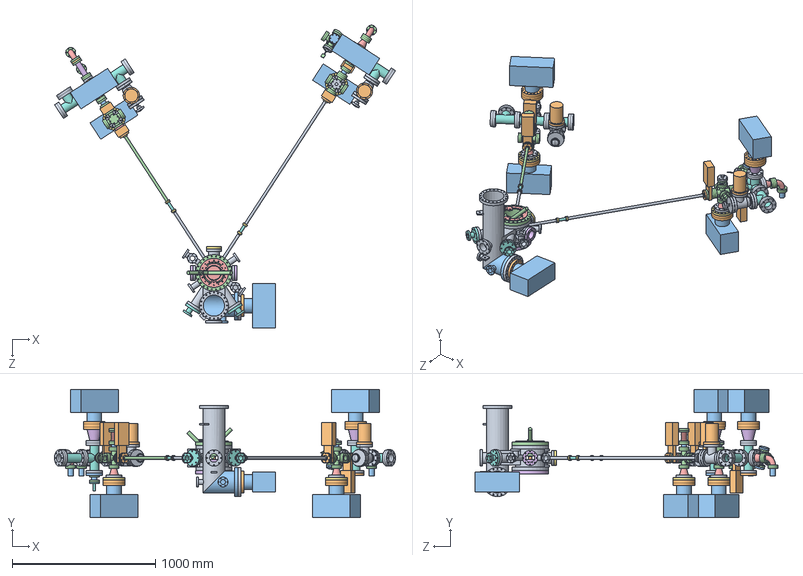
[picture p39: CAD file, 2011-03-22]
Fermi1/trapping chamber whole.SLDASM
2377.6 x 894.0 x 2110.6 mm
main chamber_081908
mot
ion pump tube
laser beam x 2
coil x 2
small bucket_2.3 x 2
small bucket
offset adapter x 2
6-8in_zerolenth_reducer
6in_CF_flange x 11
ion pump x 5
Large Bucket x 2
bucketwindow x 2
Large Bucket_no feedthrough
mini_flange x 10
bellow_tube x 2
slower_tube_long
min-2.75in_zerolenth_reducer x 2
2.75in_halfnipple_tube x 3
2.75in_CF_flange x 62
2.75in_elbow_tube x 2
2.75in_tee_tube
nozzle1
sixway_tube x 2
4.5in_CF_flange x 28
gatevalve_body x 4
minilength_nipple_tube x 5
2.75in_sixway_tube x 3
2.75-4.5in_reducer_tube x 3
4.5-6in_reducer_tube x 2
4.5-6in_zerolenth_reducer x 2
4.5in_tee_tube x 3
2.5in_gatevalve x 2
4.5in_turbopump x 2
2.75-4.5in_zerolenth_reducer x 3
oven_shutter x 2
fixed differential pumping tube
cold cup
coldcupmount
coldcupmountplate
nozzle flange
nozzle copper tube
nozzle face plate
adjustable differential pumping tube
2.75in_bellow_tube
cold cup face plate
honeycomb
2.75in_CF_feedthrough
ion_gauge x 2
4.5in_CF_flange_blank
2.75in_CF_flange_blank x 2
slower_tube_short
coilmountplate
lug
