akeshet/New-Machine-Drawings/Fermi1/oven_siglespecies.SLDASM

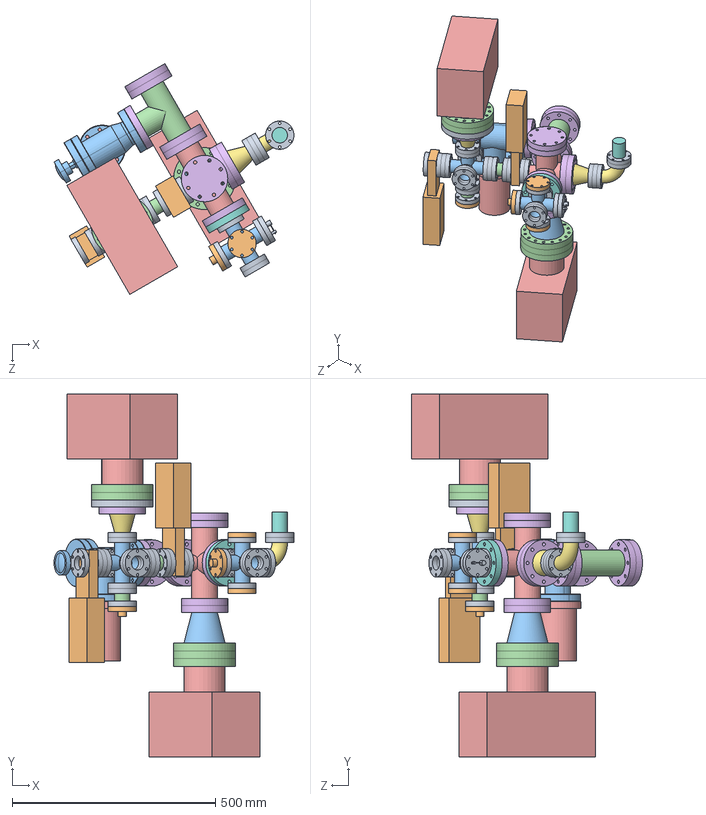
[picture p40: CAD file, 2011-03-22]
Fermi1/oven_siglespecies.SLDASM
590.8 x 894.0 x 568.5 mm
2.75in_CF_flange x 32
gatevalve_body x 2
2.75in_sixway_tube x 2
minilength_nipple_tube x 2
sixway_tube
4.5in_CF_flange x 12
2.75-4.5in_reducer_tube x 2
2.75-4.5in_zerolenth_reducer
4.5-6in_zerolenth_reducer
ion_gauge x 2
4.5-6in_reducer_tube
6in_CF_flange x 5
ion pump x 2
4.5in_CF_flange_blank
2.75in_elbow_tube
2.75in_halfnipple_tube
oven_shutter
2.75in_CF_flange_blank x 2
2.5in_gatevalve
4.5in_tee_tube
4.5in_turbopump
