akeshet/New-Machine-Drawings/Fermi1/2.75in_elbow.SLDASM

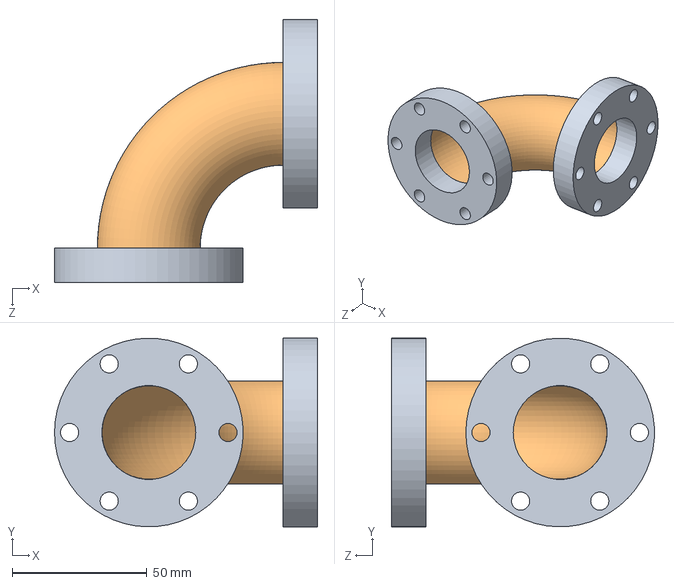
[picture p41: CAD file, 2011-03-22]
Fermi1/2.75in_elbow.SLDASM
97.4 x 69.8 x 97.4 mm
2.75in_CF_flange x 2
2.75in_elbow_tube
