akeshet/New-Machine-Drawings/Fermi1/oven_doublespecies.SLDASM

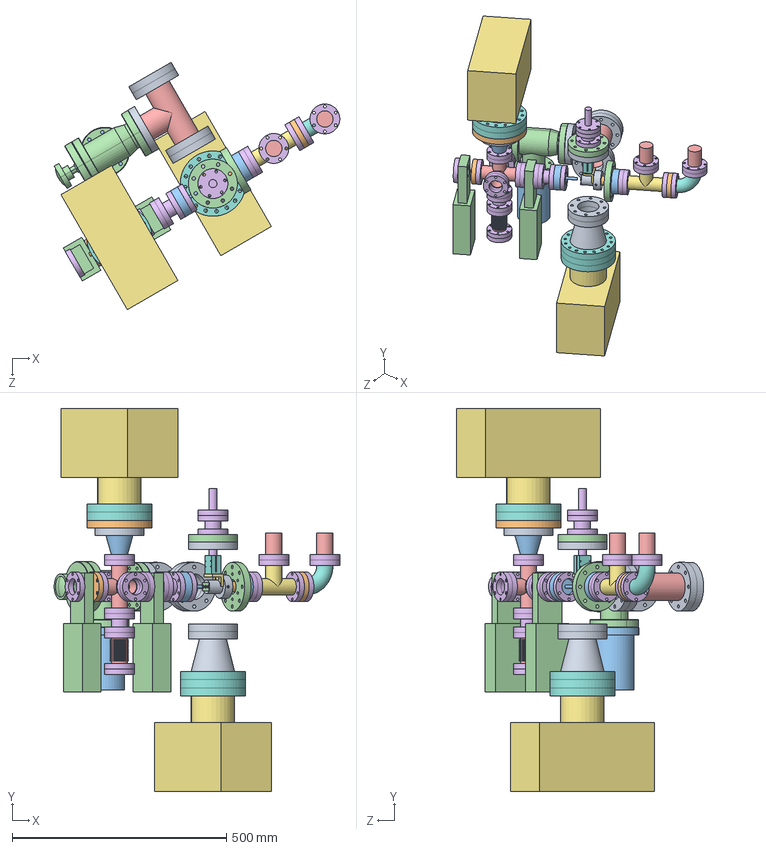
[picture p42: CAD file, 2011-03-22]
Fermi1/oven_doublespecies.SLDASM
666.8 x 894.0 x 577.3 mm
nozzle face plate
nozzle copper tube
nozzle flange
2.75-4.5in_zerolenth_reducer x 2
2.75in_halfnipple_tube x 2
2.75in_CF_flange x 29
2.75in_tee_tube
2.75in_elbow_tube
4.5in_CF_flange x 9
nozzle1
2.75-4.5in_reducer_tube
gatevalve_body x 2
2.75in_sixway_tube
minilength_nipple_tube x 3
ion pump x 2
6in_CF_flange x 5
4.5-6in_reducer_tube
4.5-6in_zerolenth_reducer
4.5in_turbopump
2.5in_gatevalve
4.5in_tee_tube
oven_shutter
coldcupmountplate
coldcupmount
cold cup
fixed differential pumping tube
adjustable differential pumping tube
cold cup face plate
2.75in_bellow_tube
2.75in_CF_feedthrough
honeycomb
