akeshet/New-Machine-Drawings/Fermi1/large bucket.SLDASM

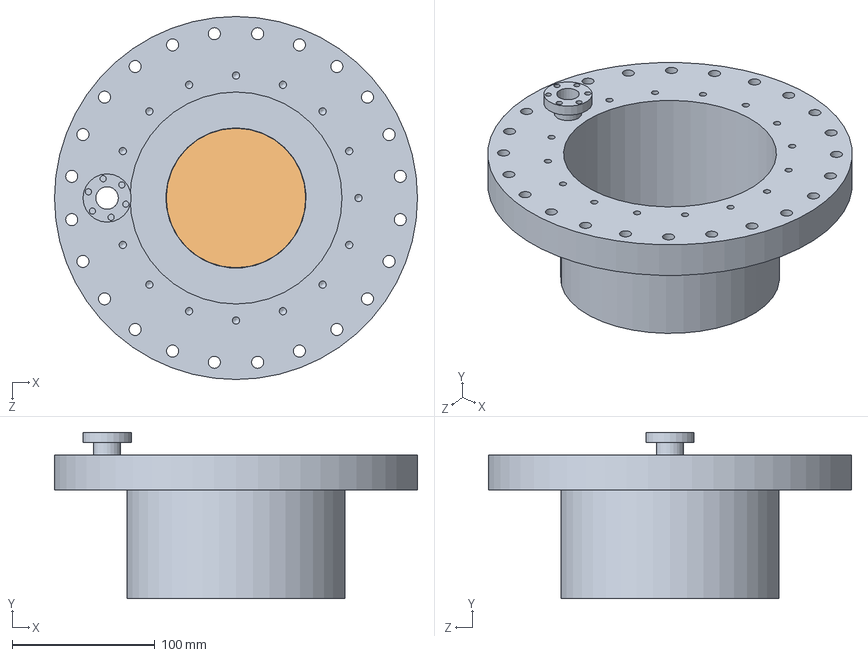
[picture p43: CAD file, 2011-03-22]
Fermi1/large bucket.SLDASM
254.0 x 116.5 x 254.0 mm
Large Bucket
bucketwindow
