akeshet/New-Machine-Drawings/canopy design.SLDASM

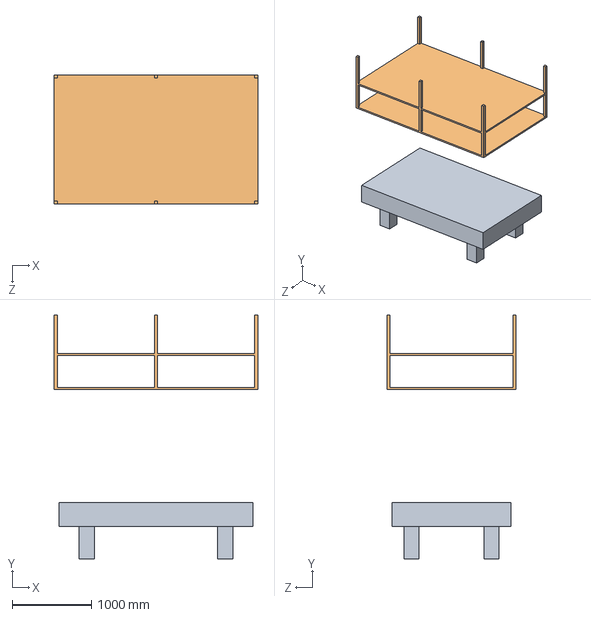
[picture p44: CAD file, 2011-06-23]
canopy design.SLDASM
2565.4 x 3073.4 x 1625.6 mm
table
canopy
