akeshet/New-Machine-Drawings/Fermi1/4.5-6in_reducer.SLDASM

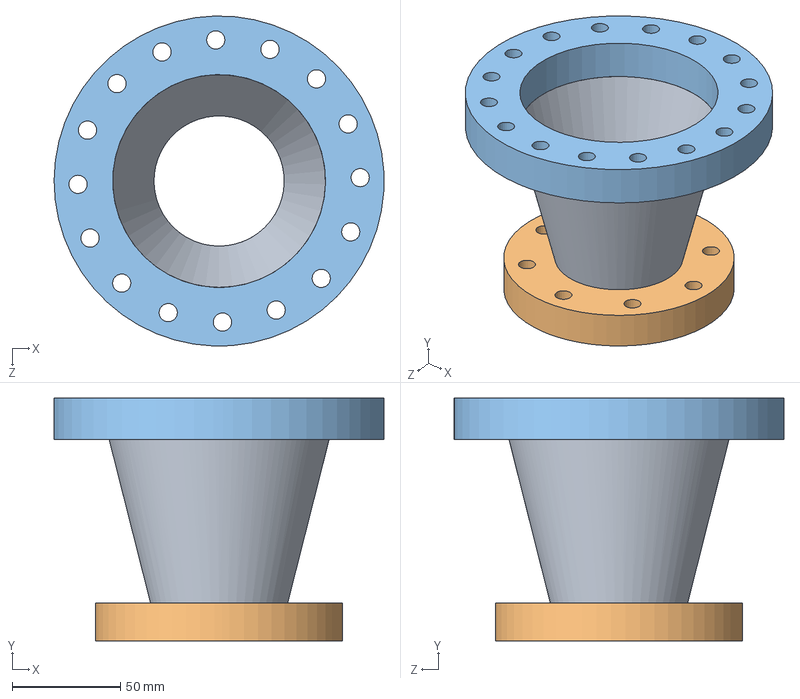
[picture p45: CAD file, 2011-03-22]
Fermi1/4.5-6in_reducer.SLDASM
152.3 x 112.0 x 152.4 mm
4.5-6in_reducer_tube
4.5in_CF_flange
6in_CF_flange
