akeshet/New-Machine-Drawings/slower A current manifold board.SLDASM

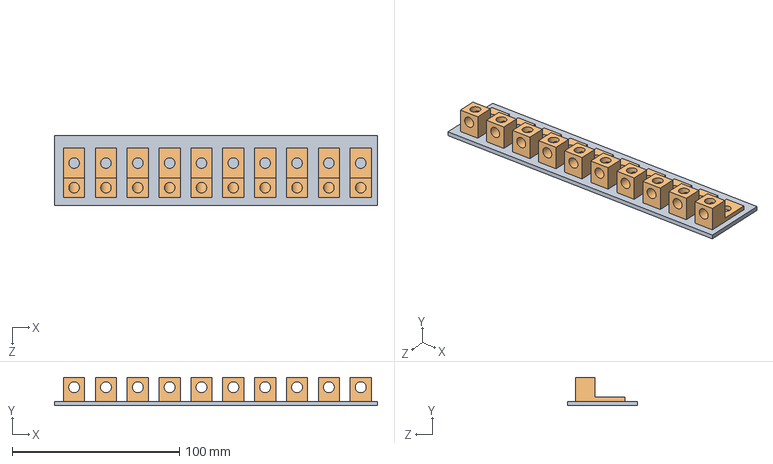
[picture p46: CAD file, 2011-03-22]
slower A current manifold board.SLDASM
193.2 x 16.8 x 41.7 mm
slower A current manifold board
lug 6920K22 x 10
