akeshet/New-Machine-Drawings/Fermi1/4.5in_tee.SLDASM

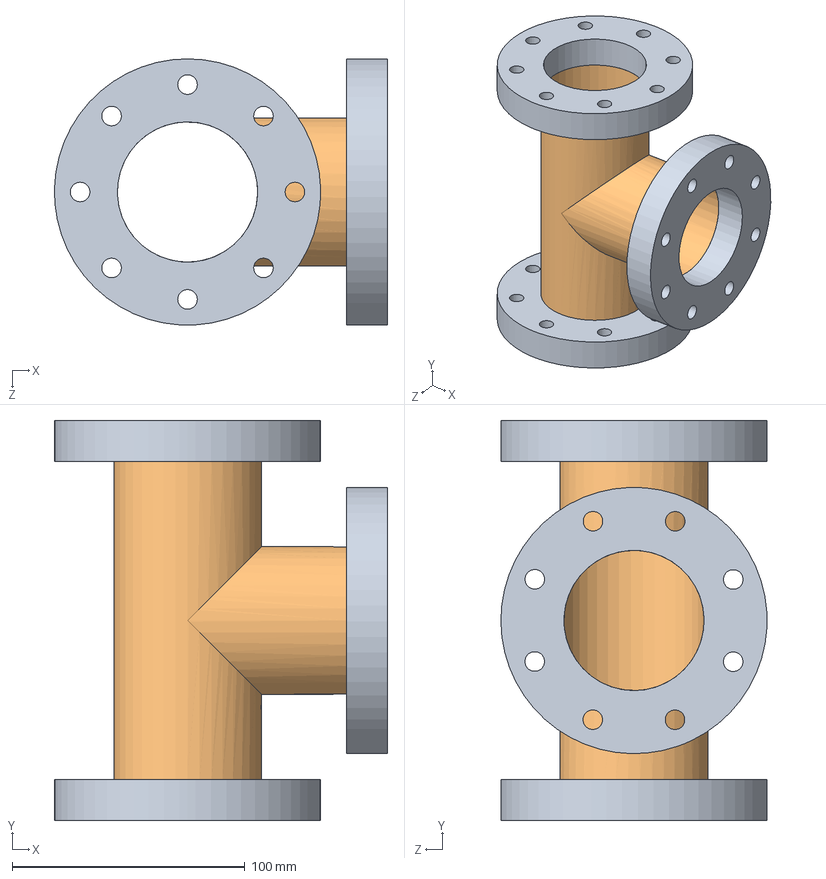
[picture p47: CAD file, 2011-03-22]
Fermi1/4.5in_tee.SLDASM
143.0 x 171.7 x 114.3 mm
4.5in_CF_flange x 3
4.5in_tee_tube
