akeshet/New-Machine-Drawings/Fermi1/2.75in_CF_bellow.SLDASM

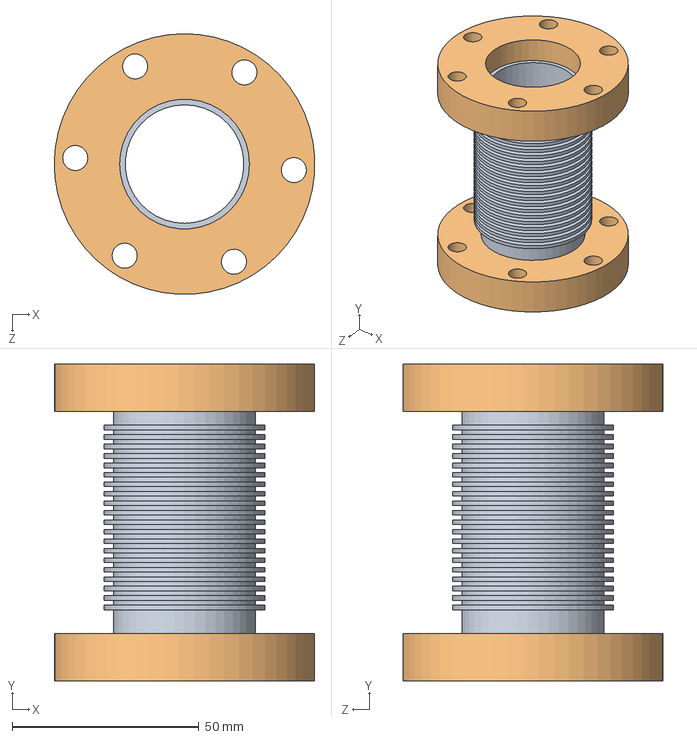
[picture p48: CAD file, 2011-03-22]
Fermi1/2.75in_CF_bellow.SLDASM
69.8 x 85.0 x 69.8 mm
2.75in_bellow_tube
2.75in_CF_flange x 2
