akeshet/New-Machine-Drawings/Fermi1/2.75in_halfnipple.SLDASM

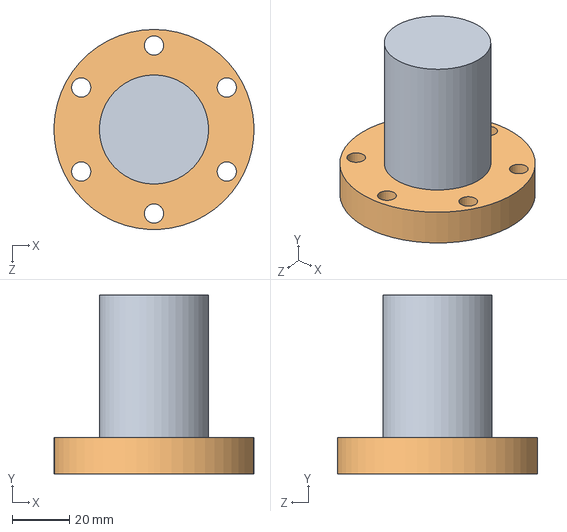
[picture p49: CAD file, 2011-03-22]
Fermi1/2.75in_halfnipple.SLDASM
69.8 x 62.5 x 69.8 mm
2.75in_halfnipple_tube
2.75in_CF_flange
