akeshet/New-Machine-Drawings/improved half miniflange assembled.SLDASM

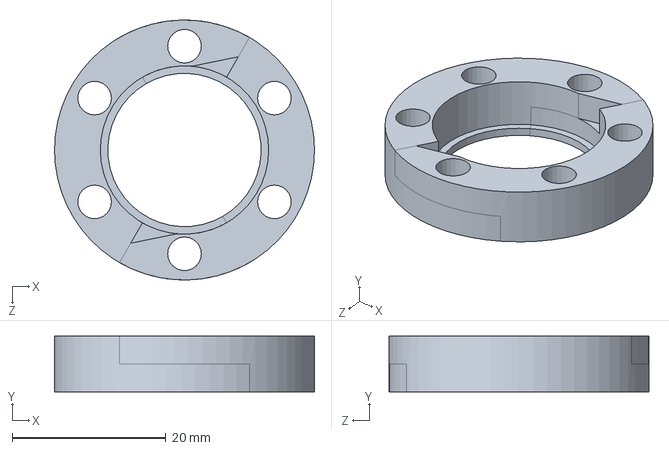
[picture p50: CAD file, 2011-03-22]
improved half miniflange assembled.SLDASM
33.8 x 7.24 x 33.8 mm
improved half miniflange ring x 2
