akeshet/New-Machine-Drawings/alternate half flange interlocking design.SLDASM

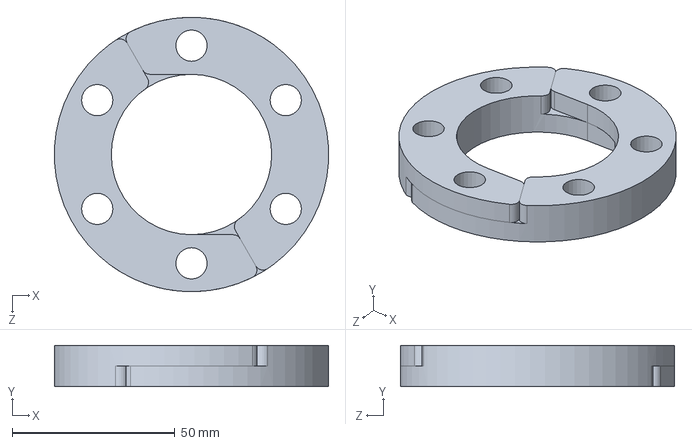
[picture p51: CAD file, 2011-03-22]
alternate half flange interlocking design.SLDASM
84.1 x 12.7 x 84.2 mm
alternate half flange design x 2
