akeshet/New-Machine-Drawings/magtrap current manifold assem.SLDASM

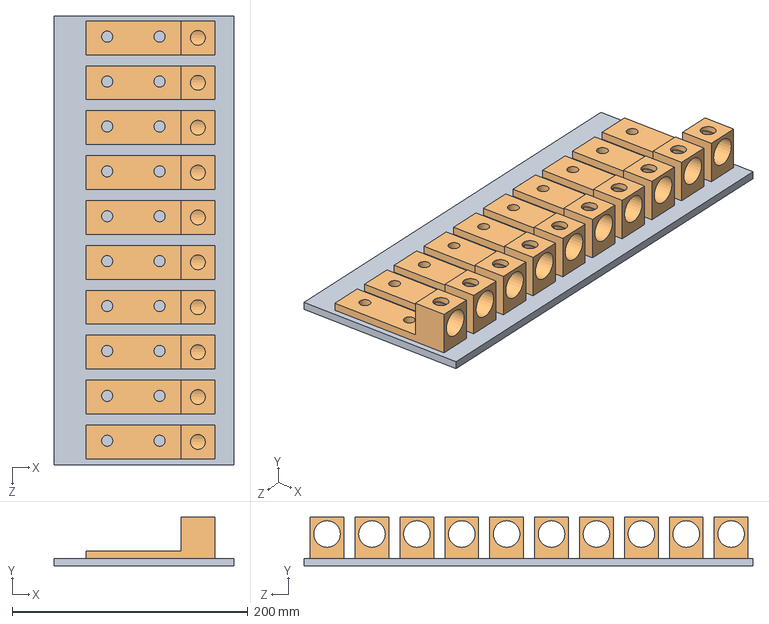
[picture p52: CAD file, 2011-03-22]
magtrap current manifold assem.SLDASM
152.4 x 41.4 x 381.0 mm
magtrap current manifold board
lug 6920K28 x 10
