akeshet/New-Machine-Drawings/slower B and C current manifold.SLDASM

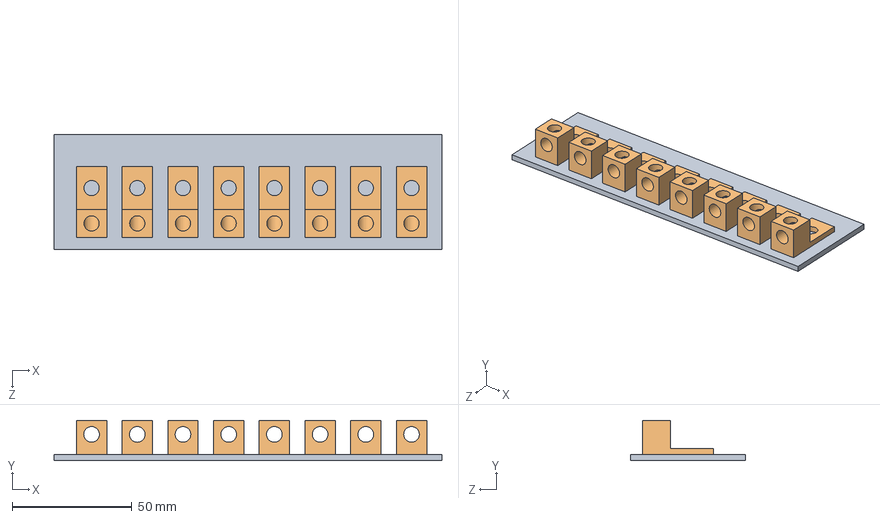
[picture p53: CAD file, 2011-03-22]
slower B and C current manifold.SLDASM
161.7 x 16.8 x 47.7 mm
slower B current manifold board
lug 6920K22 x 8
