akeshet/New-Machine-Drawings/1x5 magtrap current manifold assem.SLDASM

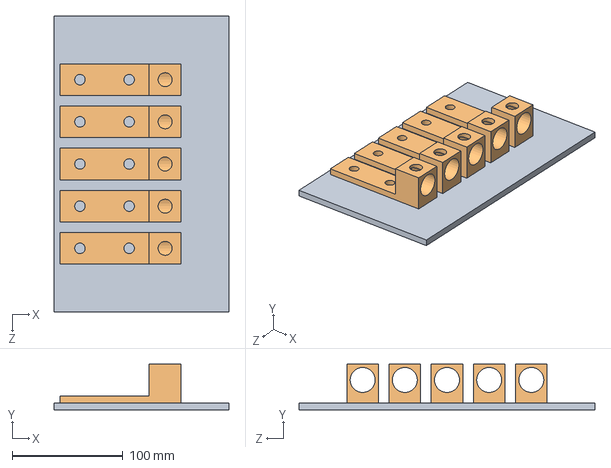
[picture p54: CAD file, 2011-03-22]
1x5 magtrap current manifold assem.SLDASM
157.7 x 41.4 x 267.5 mm
1x5 magtrap current manifold board
lug 6920K28 x 5
