akeshet/New-Machine-Drawings/bifold door.SLDASM

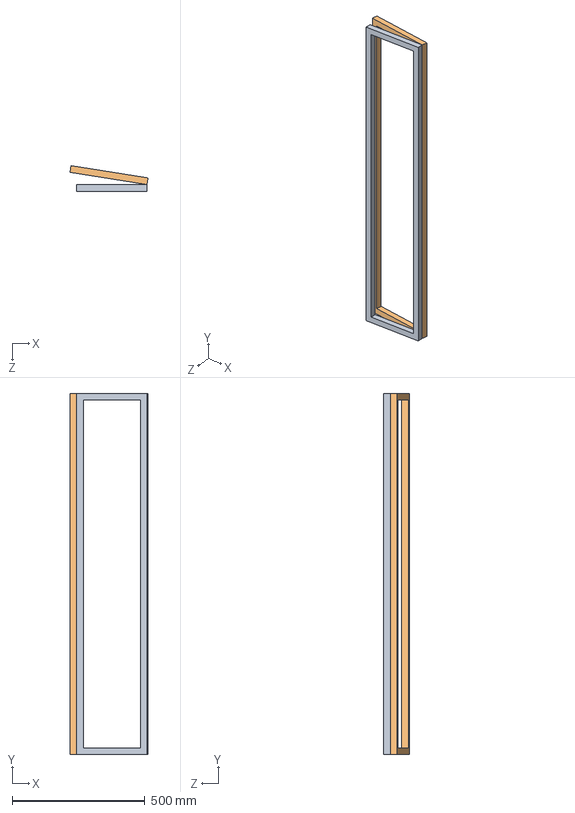
[picture p55: CAD file, 2011-03-22]
bifold door.SLDASM
294.1 x 1358.9 x 96.7 mm
bifold narrow door
bifold wide door
