akeshet/New-Machine-Drawings/slower C current manifold.SLDASM

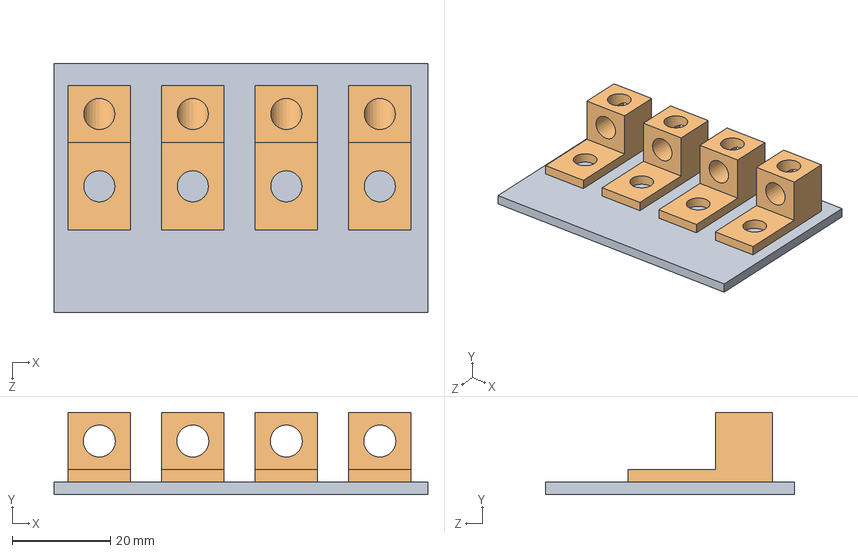
[picture p56: CAD file, 2011-03-22]
slower C current manifold.SLDASM
76.2 x 16.8 x 50.8 mm
slower C current manifold
lug 6920K22 x 4
