akeshet/New-Machine-Drawings/6 holder plate.SLDPRT

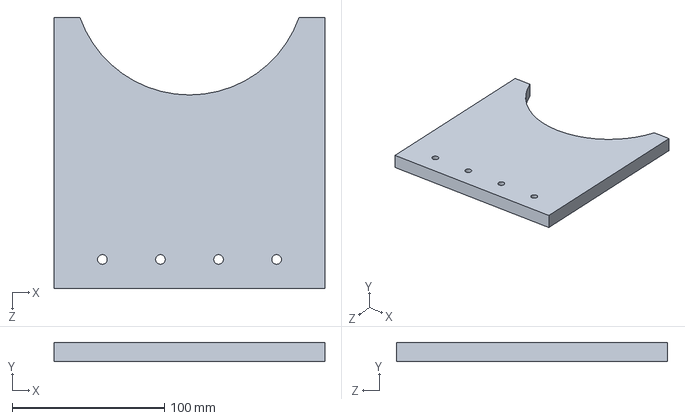
[picture p57: CAD file, 2012-07-12]
6 holder plate.SLDPRT
177.8 x 12.7 x 177.8 mm
