akeshet/New-Machine-Drawings/8020 enclosure rev2/mid post.SLDPRT

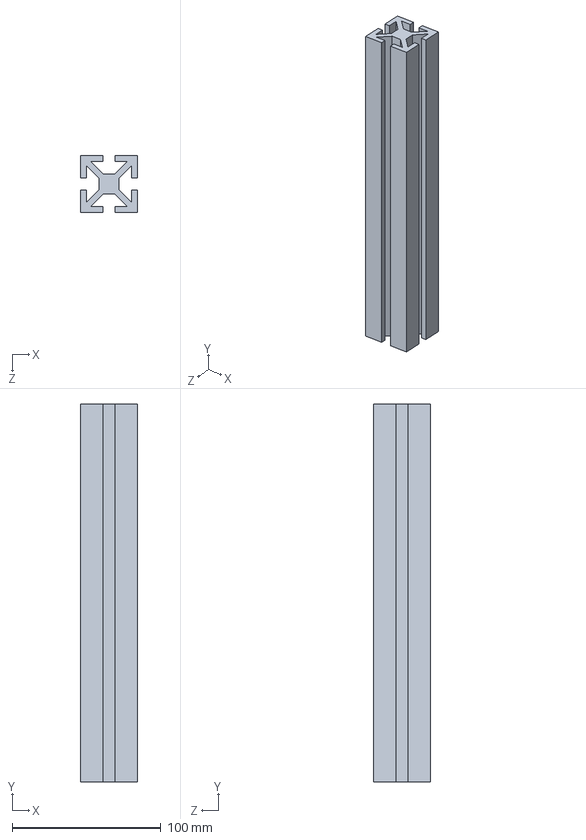
[picture p58: CAD file, 2012-07-12]
8020 enclosure rev2/mid post.SLDPRT
38.1 x 254.0 x 38.1 mm
