akeshet/New-Machine-Drawings/cartoon drawings/coil cartoon.SLDPRT

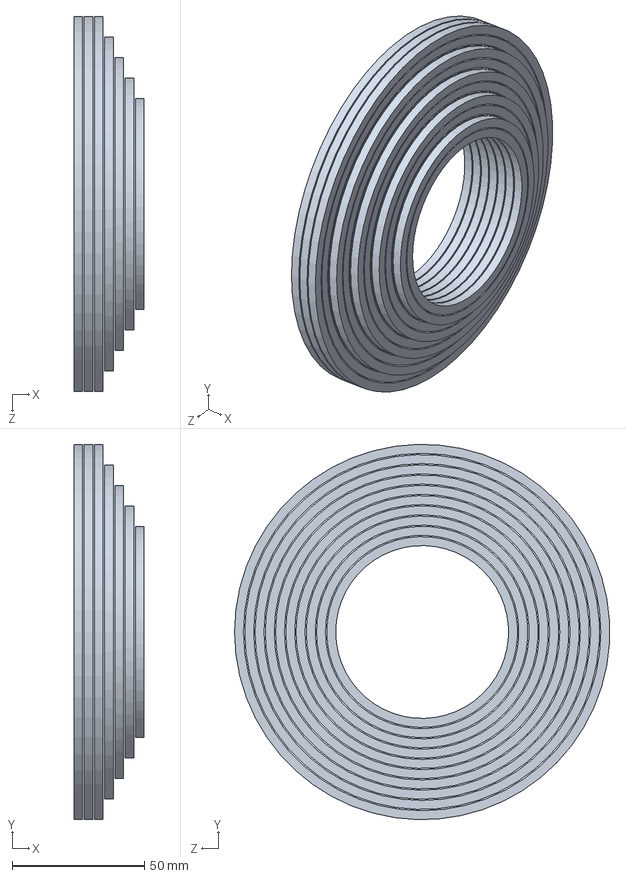
[picture p59: CAD file, 2012-07-12]
cartoon drawings/coil cartoon.SLDPRT
26.7 x 142.0 x 141.9 mm
