akeshet/New-Machine-Drawings/drawings/top breadboard alternate design noholes.DXF

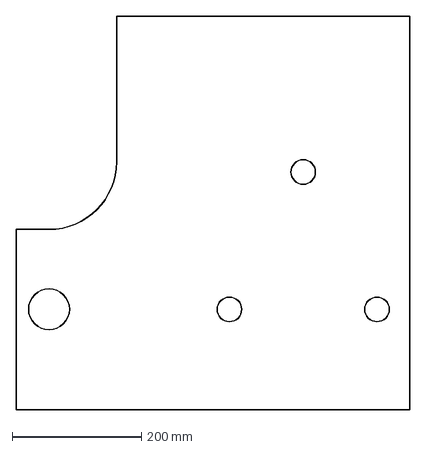
[picture p60: CAD file, 2011-11-02]
drawings/top breadboard alternate design noholes.DXF
609.6 x 609.6 mm
