akeshet/New-Machine-Drawings/electronics boxes/airmaster.SLDPRT

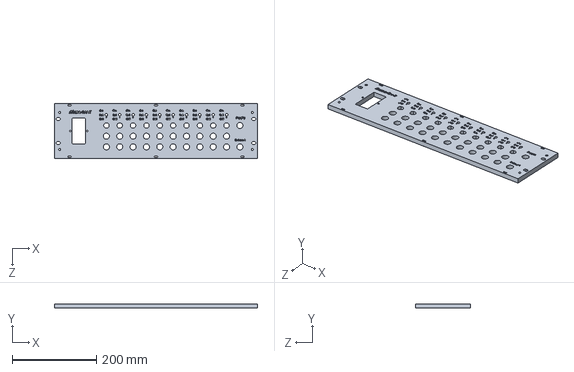
[picture p61: CAD file, 2011-06-06]
electronics boxes/airmaster.SLDPRT
482.6 x 10.0 x 130.0 mm
