akeshet/New-Machine-Drawings/jigs/coil potting jig.SLDPRT

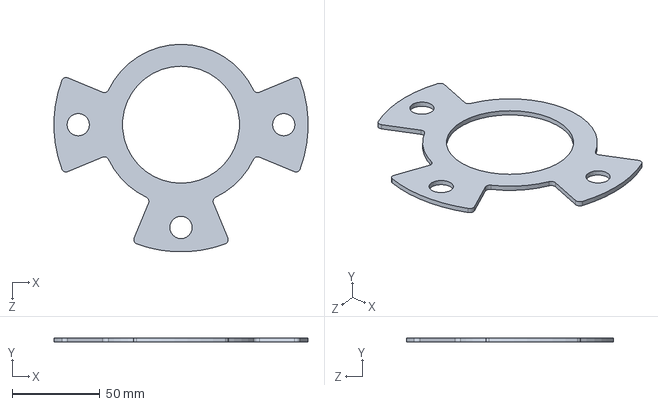
[picture p62: CAD file, 2011-03-22]
jigs/coil potting jig.SLDPRT
144.4 x 2.54 x 117.9 mm
