akeshet/New-Machine-Drawings/misc/window tube inquiry.SLDPRT

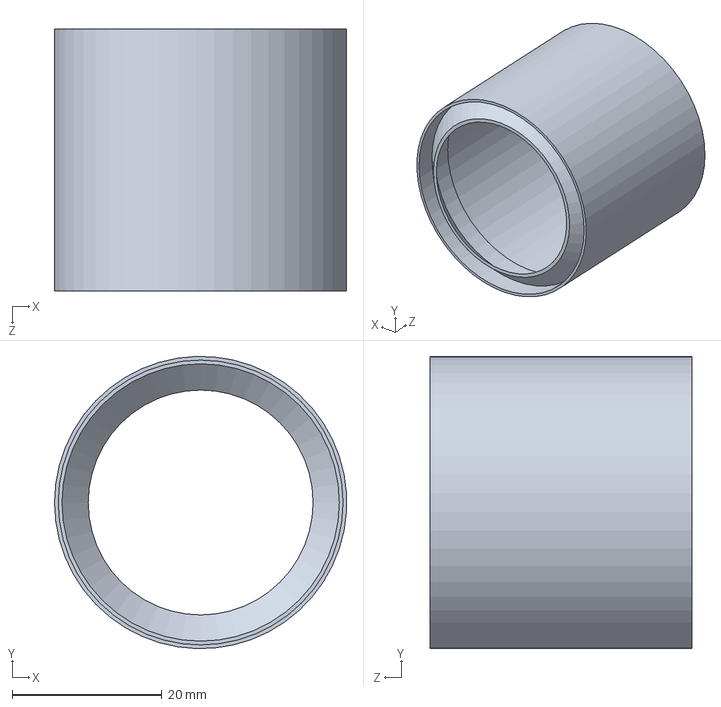
[picture p63: CAD file, 2011-03-22]
misc/window tube inquiry.SLDPRT
39.0 x 39.0 x 35.0 mm
