akeshet/New-Machine-Drawings/oven and slower/increasing field slower coil peyman design.SLDPRT

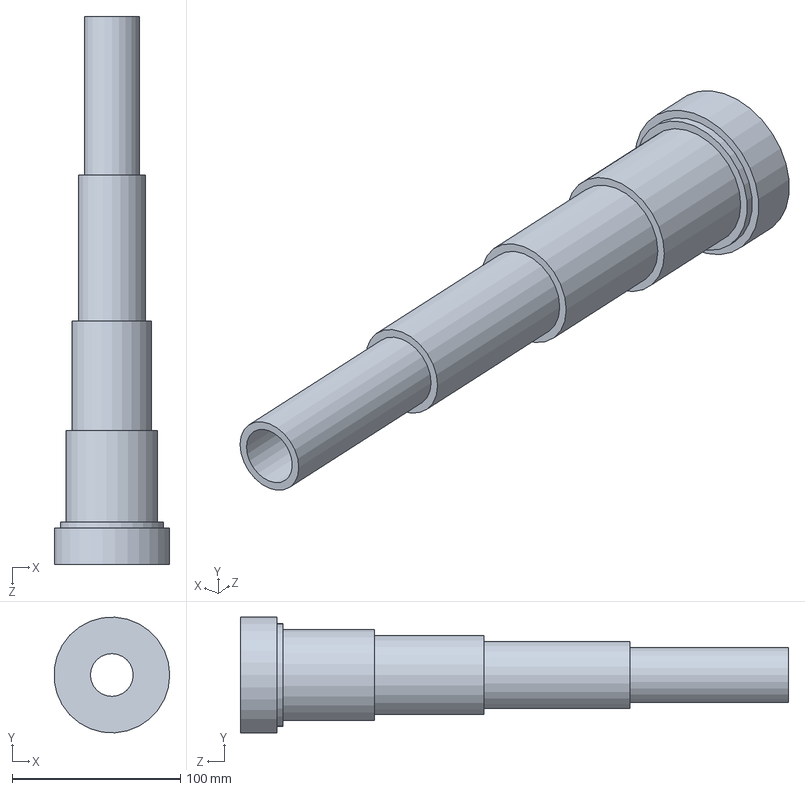
[picture p64: CAD file, 2011-08-22]
oven and slower/increasing field slower coil peyman design.SLDPRT
68.6 x 68.7 x 325.5 mm
