akeshet/New-Machine-Drawings/pumps/45S-4V_KG_SW0001.SLDPRT

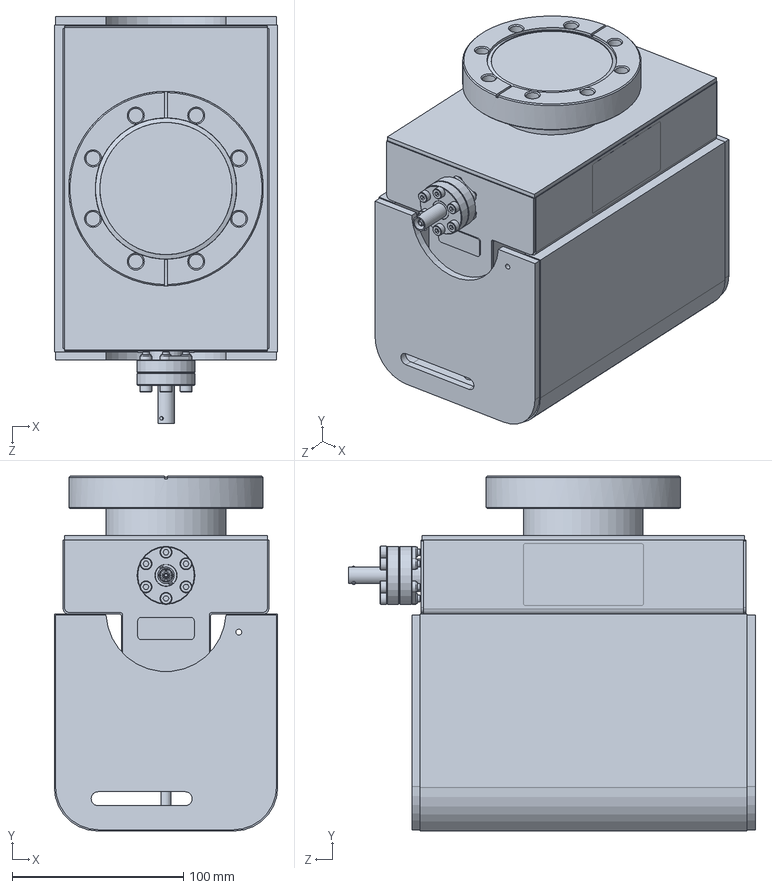
[picture p65: CAD file, 2011-08-22]
pumps/45S-4V_KG_SW0001.SLDPRT
130.4 x 207.2 x 237.6 mm
