akeshet/New-Machine-Drawings/studies/2 inch window, close coils/oven and slower/slower compensation coil peyman design.SLDPRT

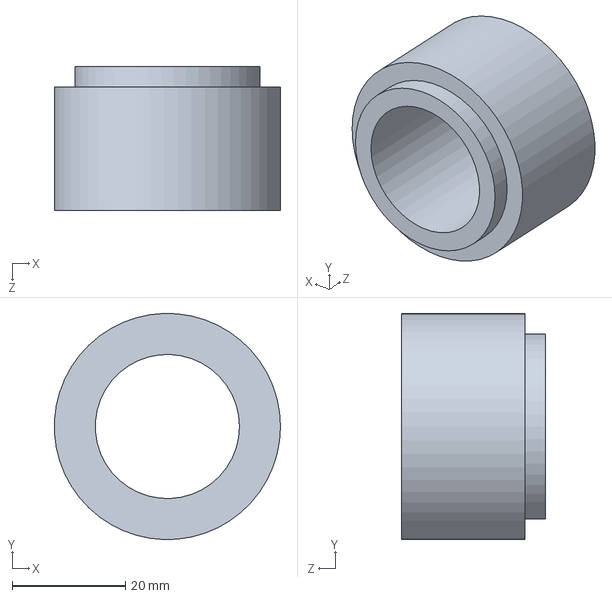
[picture p66: CAD file, 2011-03-22]
studies/2 inch window, close coils/oven and slower/slower compensation coil peyman design.SLDPRT
39.8 x 39.8 x 25.3 mm
