akeshet/New-Machine-Drawings/studies/2 inch window, close coils/templates/flange_feature.SLDPRT

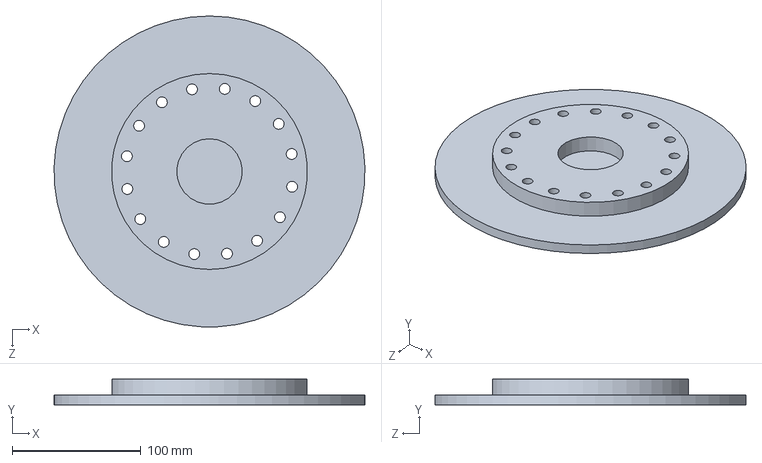
[picture p67: CAD file, 2011-03-22]
studies/2 inch window, close coils/templates/flange_feature.SLDPRT
241.2 x 20.0 x 241.3 mm
