akeshet/New-Machine-Drawings/studies/multiport_study/custom multiport window.SLDPRT

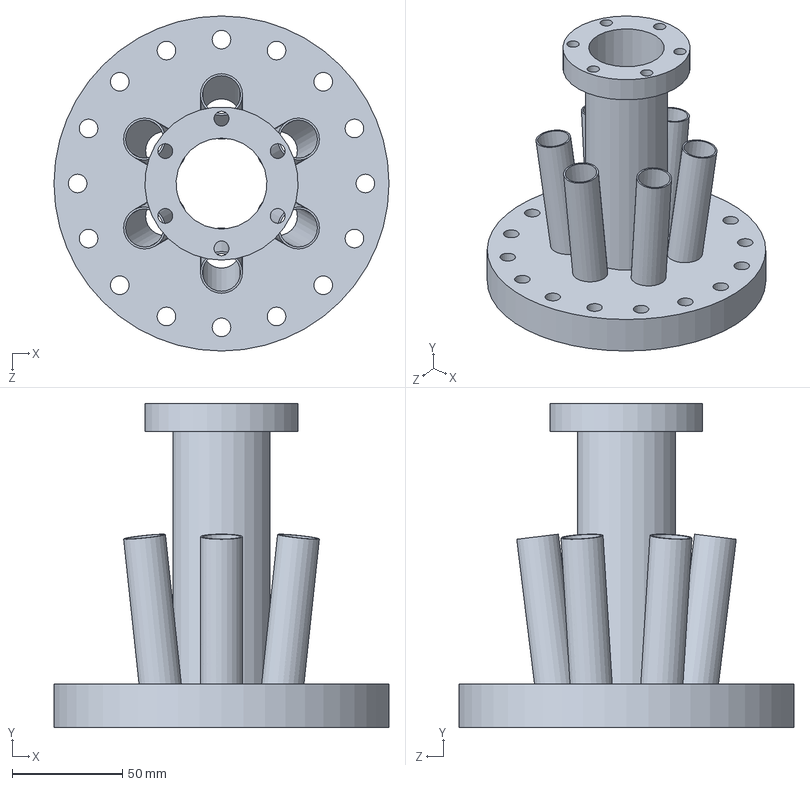
[picture p68: CAD file, 2011-03-22]
studies/multiport_study/custom multiport window.SLDPRT
151.6 x 146.8 x 151.6 mm
