akeshet/New-Machine-Drawings/swagelok/swagelok 42S4 valve.SLDPRT

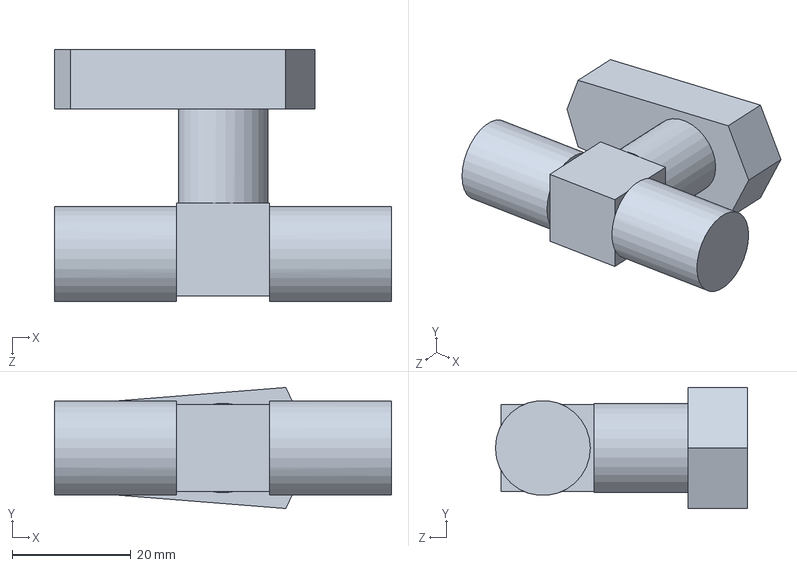
[picture p69: CAD file, 2012-07-12]
swagelok/swagelok 42S4 valve.SLDPRT
56.8 x 20.4 x 42.5 mm
