akeshet/New-Machine-Drawings/8020 enclosure rev2/lower long.SLDPRT

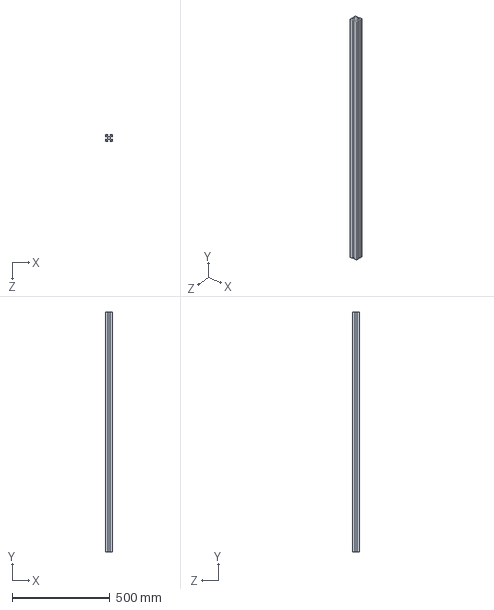
[picture p70: CAD file, 2012-07-12]
8020 enclosure rev2/lower long.SLDPRT
38.1 x 1225.6 x 38.1 mm
