akeshet/New-Machine-Drawings/approximate sketches/bimba stage.SLDPRT

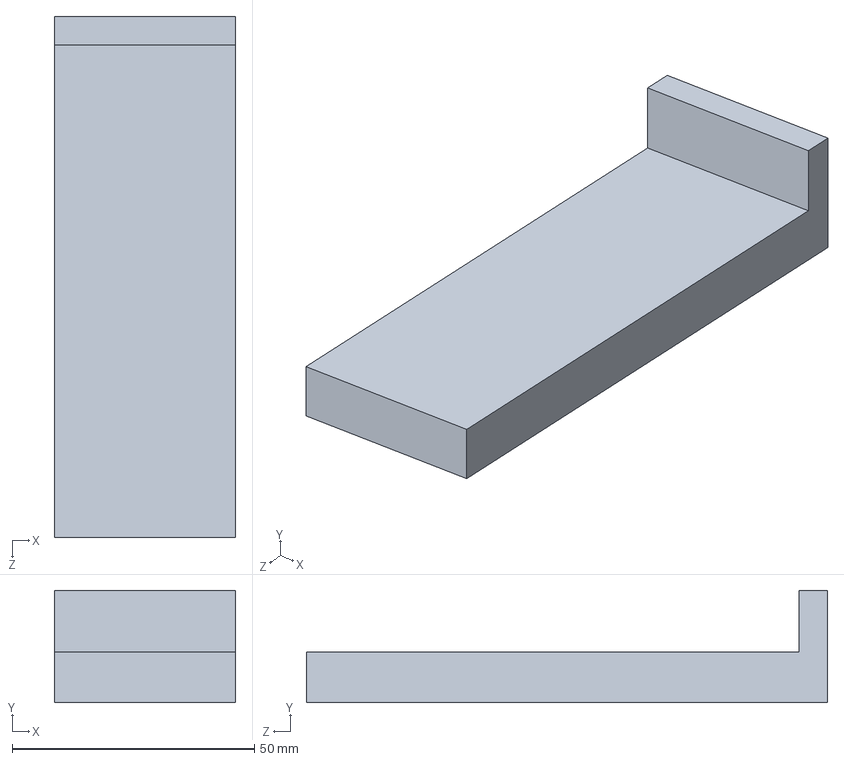
[picture p71: CAD file, 2011-03-22]
approximate sketches/bimba stage.SLDPRT
37.3 x 23.1 x 107.4 mm
