akeshet/New-Machine-Drawings/electronics boxes/relaymaster 499 front panel.SLDPRT

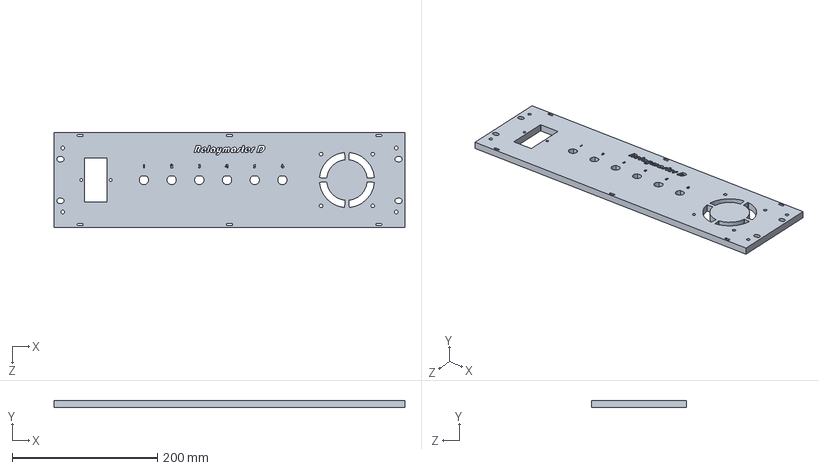
[picture p72: CAD file, 2011-06-06]
electronics boxes/relaymaster 499 front panel.SLDPRT
482.6 x 10.0 x 130.0 mm
