akeshet/New-Machine-Drawings/Fermi1/offset adapter.SLDPRT

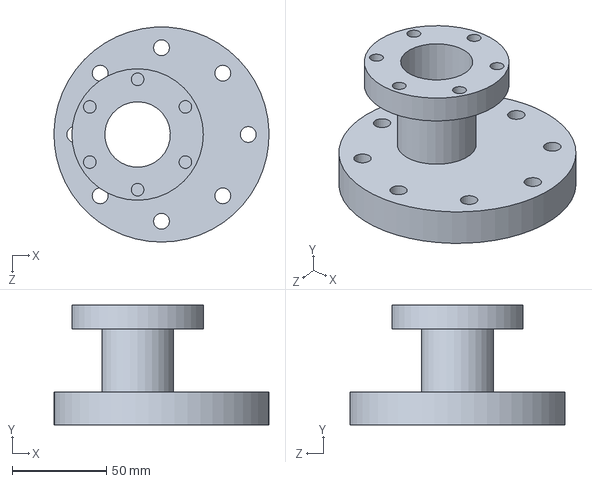
[picture p73: CAD file, 2011-03-22]
Fermi1/offset adapter.SLDPRT
114.2 x 63.5 x 114.3 mm
