akeshet/New-Machine-Drawings/Na table enclosure/Na support bar.SLDPRT

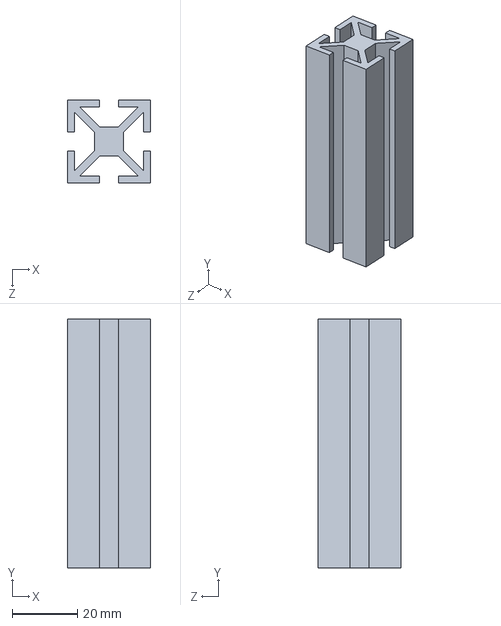
[picture p74: CAD file, 2011-12-12]
Na table enclosure/Na support bar.SLDPRT
25.4 x 76.2 x 25.4 mm
