akeshet/New-Machine-Drawings/pumps/75S-4V-KG_SW0001.SLDPRT

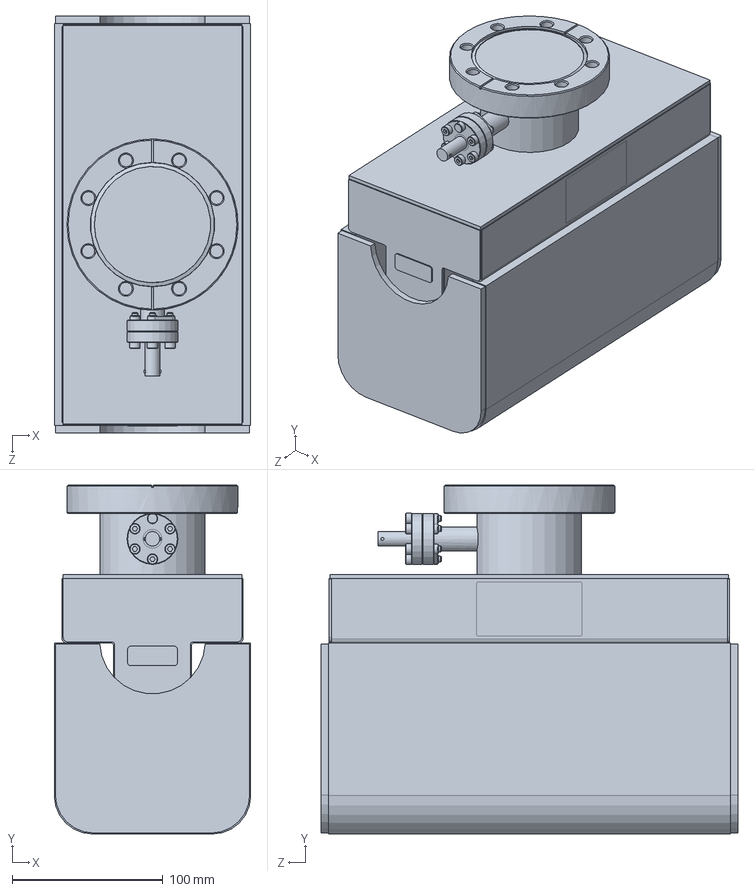
[picture p75: CAD file, 2011-03-22]
pumps/75S-4V-KG_SW0001.SLDPRT
130.4 x 231.7 x 276.8 mm
