akeshet/New-Machine-Drawings/sm2 retaining ring.SLDPRT

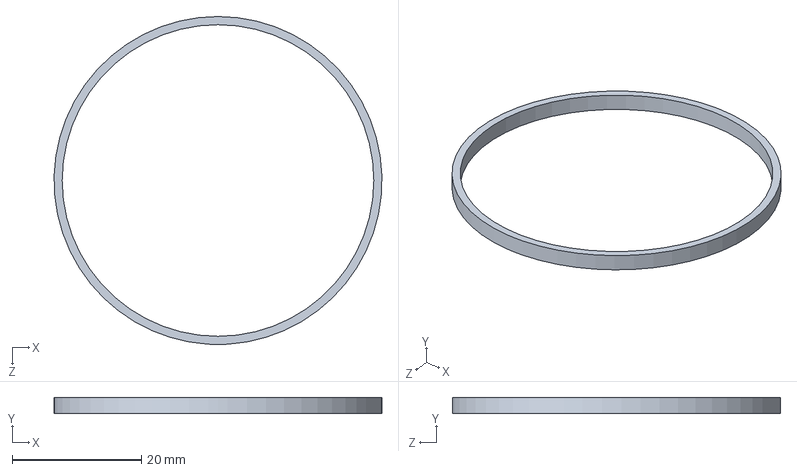
[picture p76: CAD file, 2012-07-12]
sm2 retaining ring.SLDPRT
50.8 x 2.54 x 50.8 mm
