akeshet/New-Machine-Drawings/studies/2 inch window, close coils/2 inch lens tube.SLDPRT

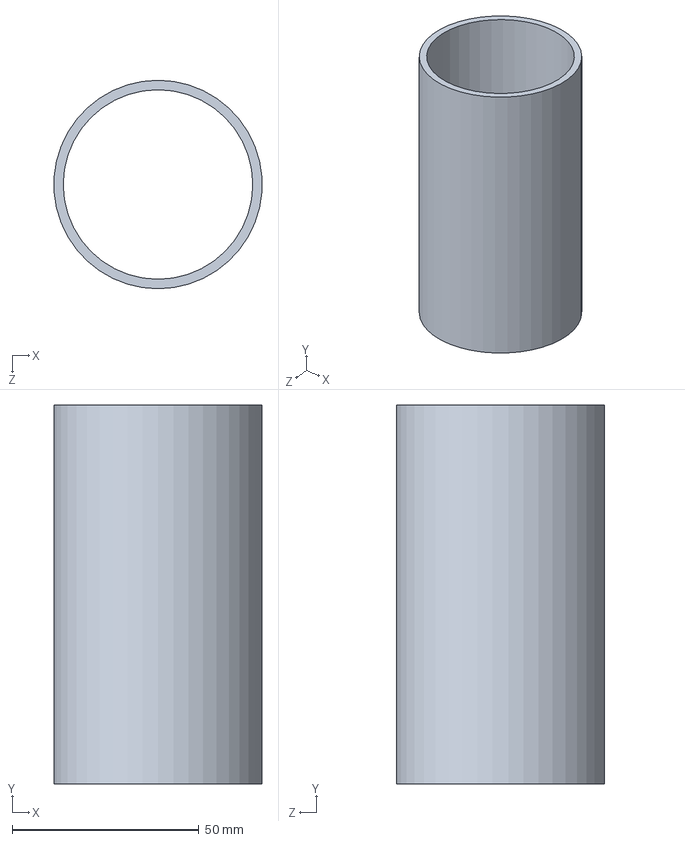
[picture p77: CAD file, 2011-03-22]
studies/2 inch window, close coils/2 inch lens tube.SLDPRT
55.7 x 101.6 x 55.9 mm
