akeshet/New-Machine-Drawings/studies/before angled pump body/oven and slower/decreasing field slower coil peyman design.SLDPRT

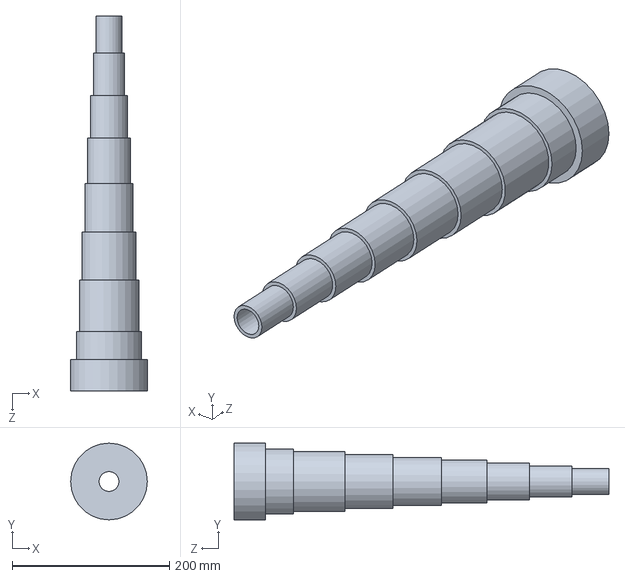
[picture p78: CAD file, 2011-03-22]
studies/before angled pump body/oven and slower/decreasing field slower coil peyman design.SLDPRT
97.7 x 97.7 x 477.4 mm
