akeshet/New-Machine-Drawings/studies/before angled pump body/Top Bucket.sldprt

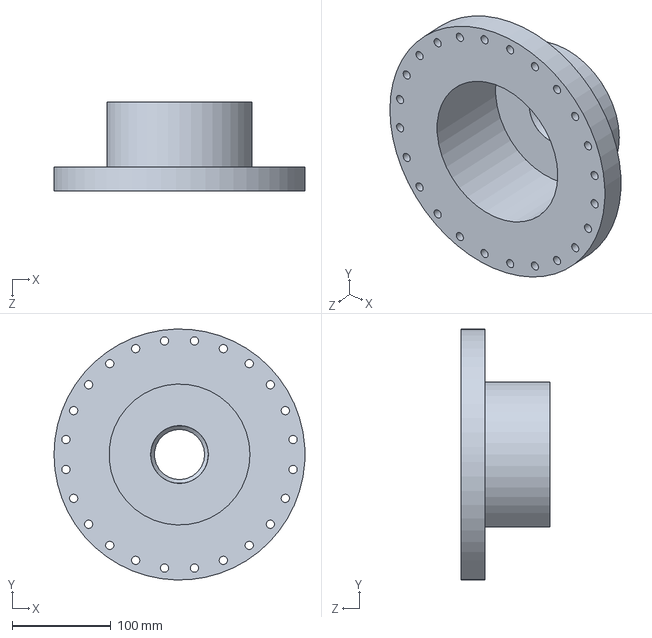
[picture p79: CAD file, 2011-03-22]
studies/before angled pump body/Top Bucket.sldprt
254.0 x 253.9 x 90.6 mm
