akeshet/New-Machine-Drawings/studies/multiport_study/fermi1 bucket nofeedthrough.SLDPRT

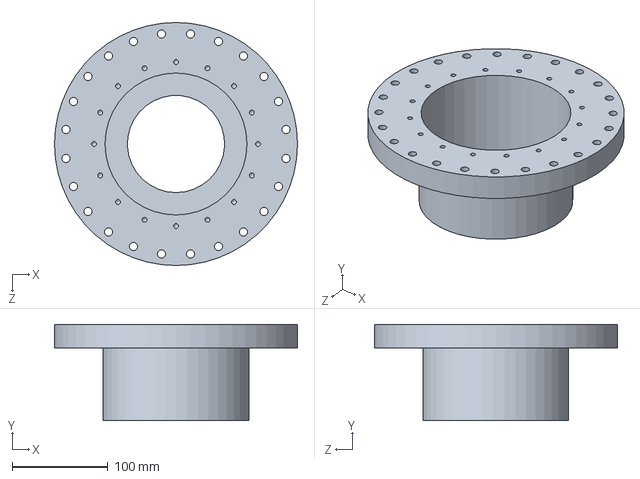
[picture p80: CAD file, 2011-03-22]
studies/multiport_study/fermi1 bucket nofeedthrough.SLDPRT
254.0 x 100.6 x 254.0 mm
