akeshet/New-Machine-Drawings/swagelok/proteus flow meter.SLDPRT

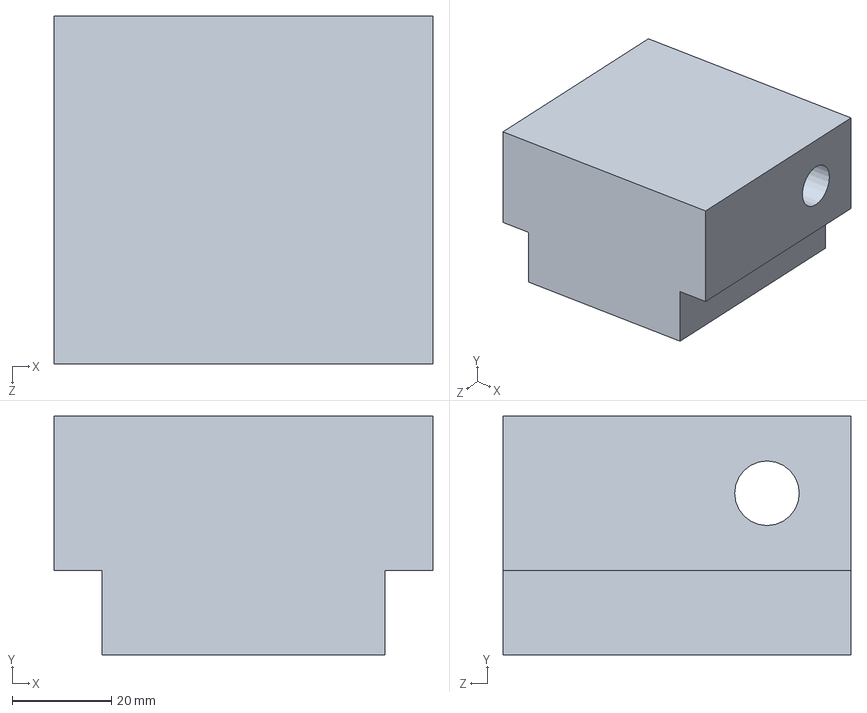
[picture p81: CAD file, 2012-07-12]
swagelok/proteus flow meter.SLDPRT
76.2 x 48.0 x 70.0 mm
