akeshet/New-Machine-Drawings/8020 enclosure rev2/45 degree support beam.SLDPRT

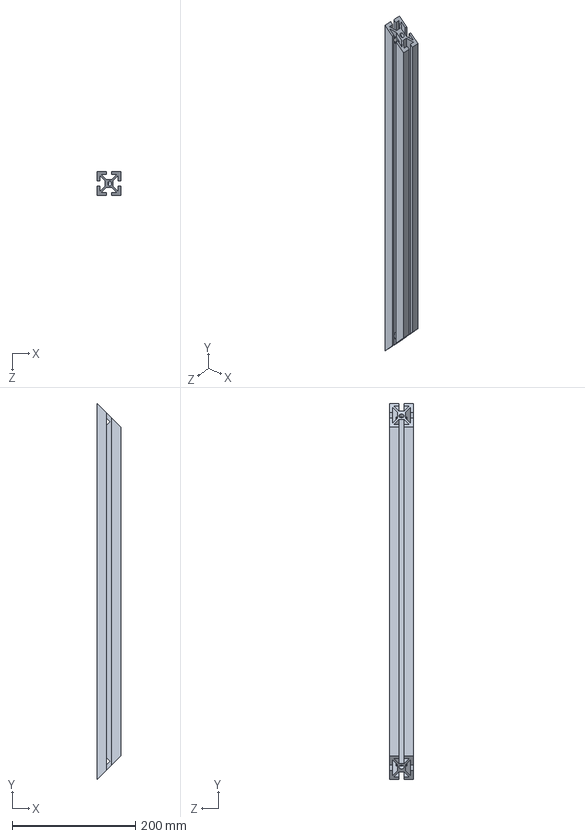
[picture p82: CAD file, 2012-07-12]
8020 enclosure rev2/45 degree support beam.SLDPRT
38.1 x 609.6 x 38.1 mm
