akeshet/New-Machine-Drawings/Fermi1/sixway_tube.SLDPRT

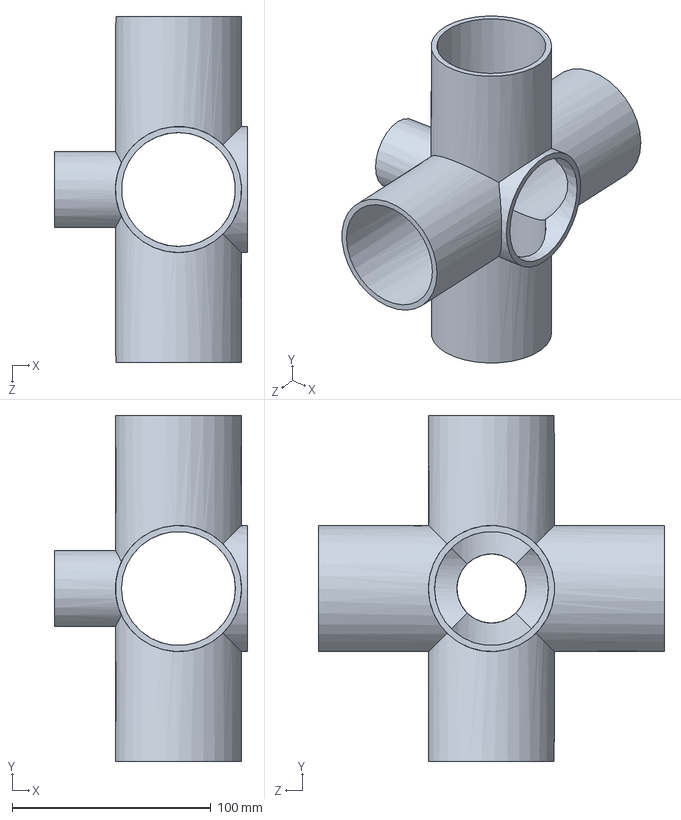
[picture p83: CAD file, 2011-03-22]
Fermi1/sixway_tube.SLDPRT
97.3 x 174.2 x 174.2 mm
