akeshet/New-Machine-Drawings/Na table enclosure/Na midpost.SLDPRT

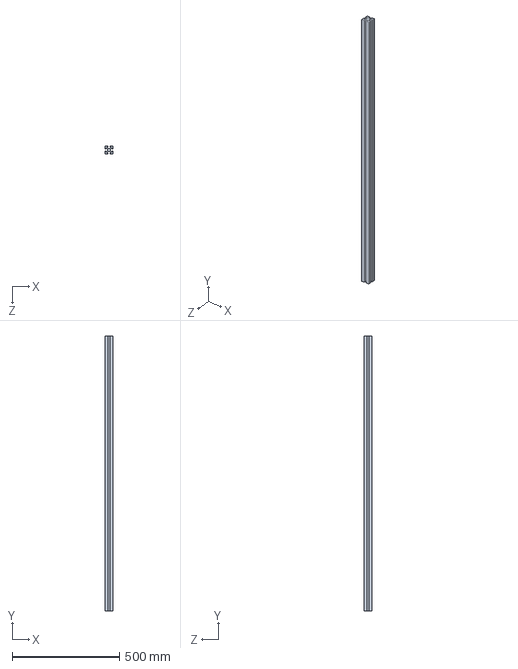
[picture p84: CAD file, 2011-12-12]
Na table enclosure/Na midpost.SLDPRT
38.1 x 1282.7 x 38.1 mm
