akeshet/New-Machine-Drawings/oven and slower/decreasing field slower coil peyman design.SLDPRT

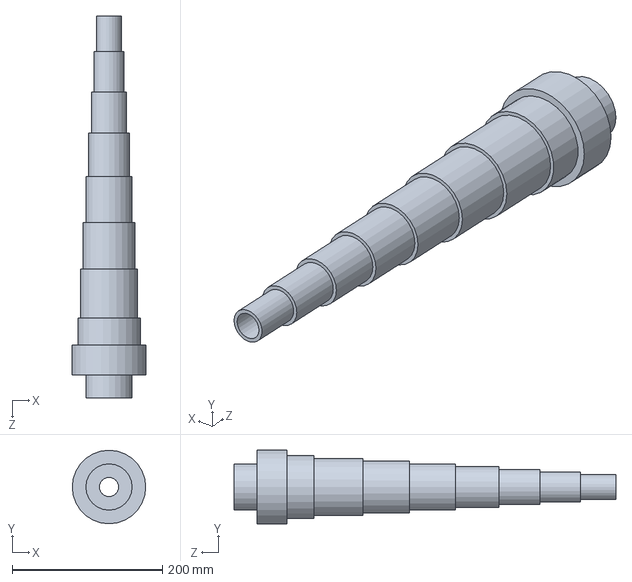
[picture p85: CAD file, 2011-08-22]
oven and slower/decreasing field slower coil peyman design.SLDPRT
97.7 x 97.7 x 507.9 mm
