akeshet/New-Machine-Drawings/swagelok/swagelok 810-3 union.SLDPRT

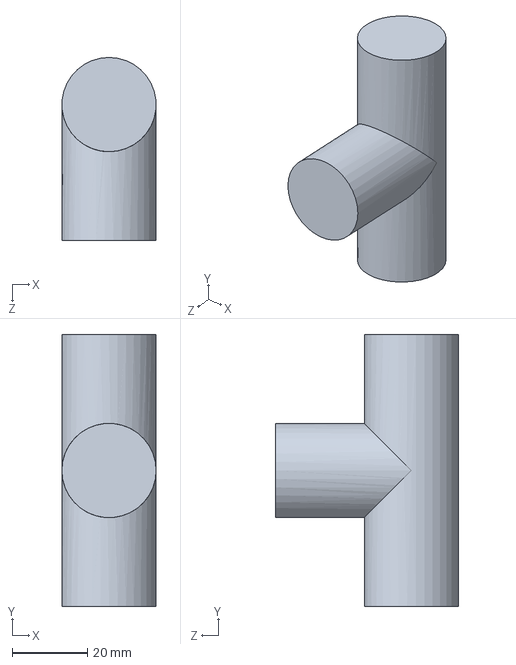
[picture p86: CAD file, 2012-07-12]
swagelok/swagelok 810-3 union.SLDPRT
25.0 x 72.1 x 48.6 mm
