akeshet/New-Machine-Drawings/approximate sketches/bimba base.SLDPRT

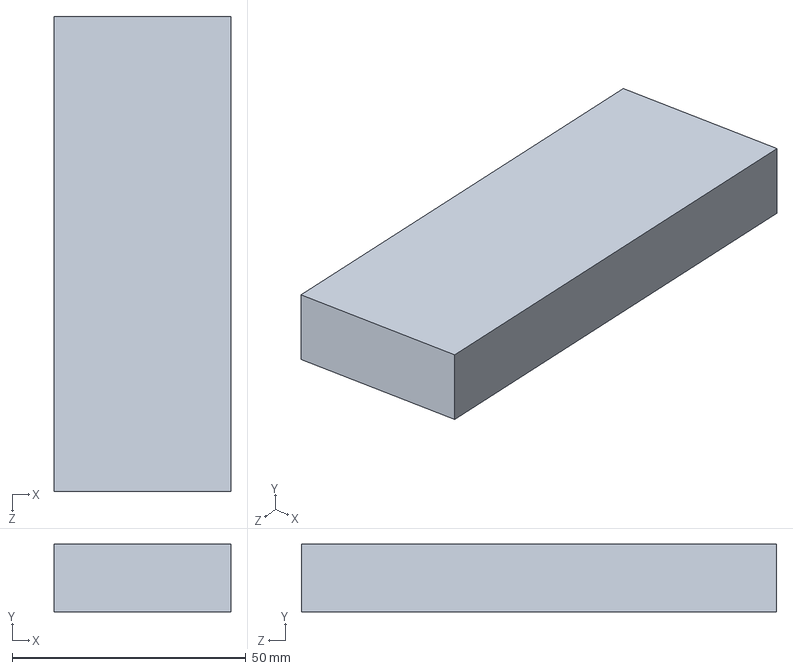
[picture p87: CAD file, 2011-03-22]
approximate sketches/bimba base.SLDPRT
37.8 x 14.5 x 101.6 mm
