akeshet/New-Machine-Drawings/Fermi1/slower_tube_short.SLDPRT

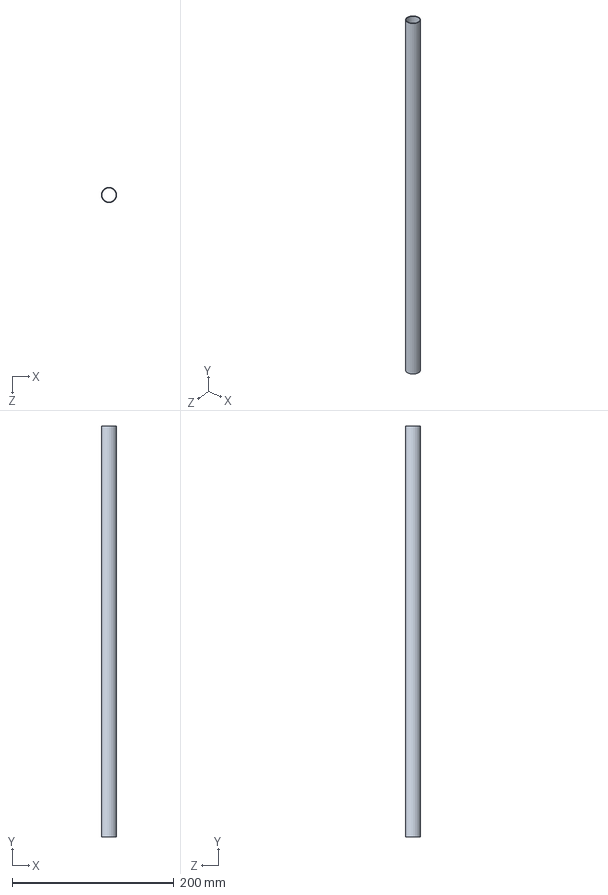
[picture p88: CAD file, 2011-03-22]
Fermi1/slower_tube_short.SLDPRT
19.1 x 508.0 x 19.1 mm
