akeshet/New-Machine-Drawings/studies/2 inch window, close coils/mititoyu objective M Plan NIR 5X.SLDPRT

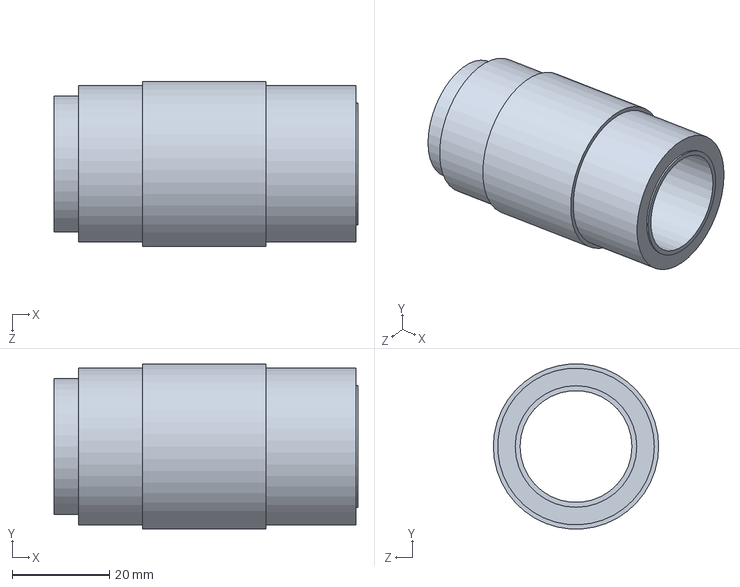
[picture p89: CAD file, 2011-03-22]
studies/2 inch window, close coils/mititoyu objective M Plan NIR 5X.SLDPRT
62.5 x 33.9 x 34.0 mm
