akeshet/New-Machine-Drawings/studies/before angled pump body/lens 378-847.SLDPRT

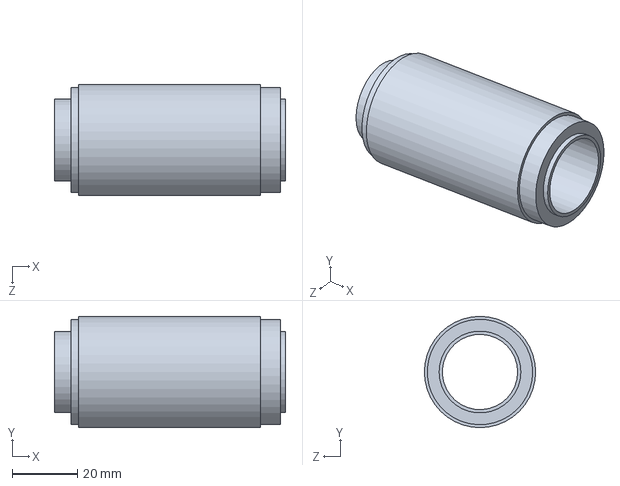
[picture p90: CAD file, 2011-03-22]
studies/before angled pump body/lens 378-847.SLDPRT
70.6 x 34.0 x 34.0 mm
