akeshet/New-Machine-Drawings/top imaging dichroic.SLDPRT

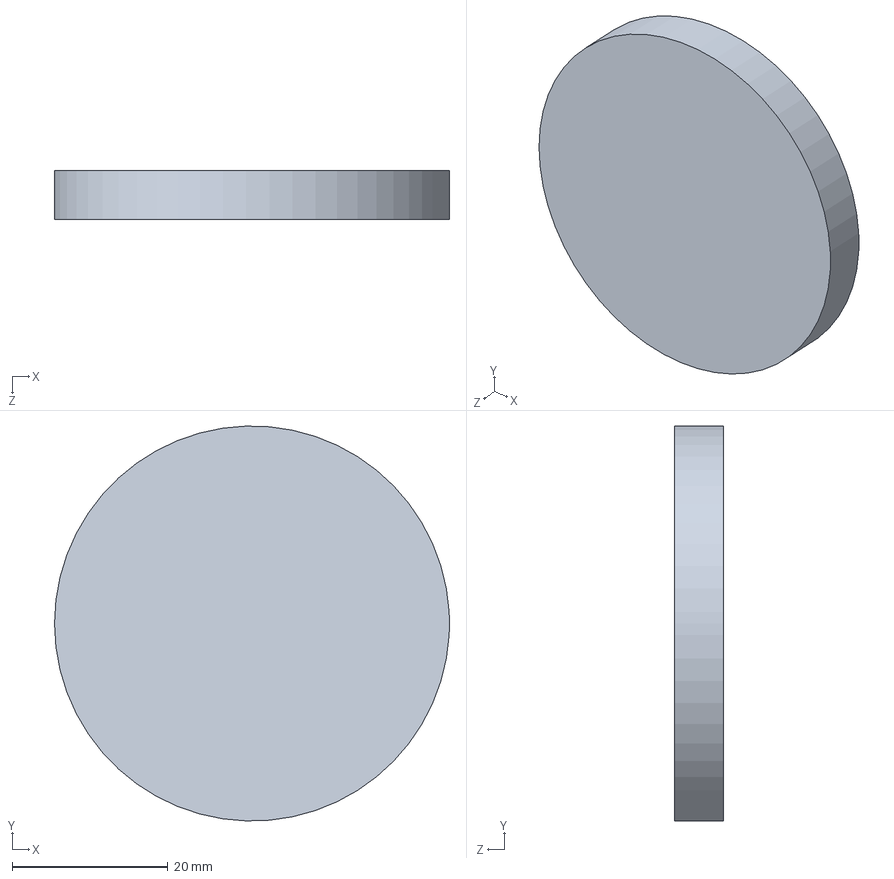
[picture p91: CAD file, 2012-07-12]
top imaging dichroic.SLDPRT
50.8 x 50.8 x 6.35 mm
