akeshet/New-Machine-Drawings/8020 enclosure rev2/corner post.SLDPRT

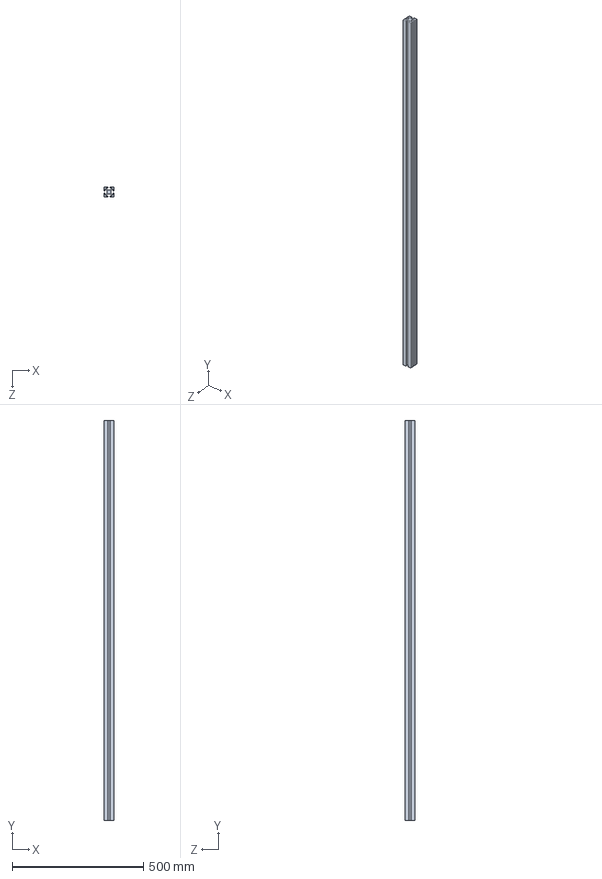
[picture p92: CAD file, 2012-07-12]
8020 enclosure rev2/corner post.SLDPRT
38.1 x 1524.0 x 38.1 mm
