akeshet/New-Machine-Drawings/Fermi1/ion pump.SLDPRT

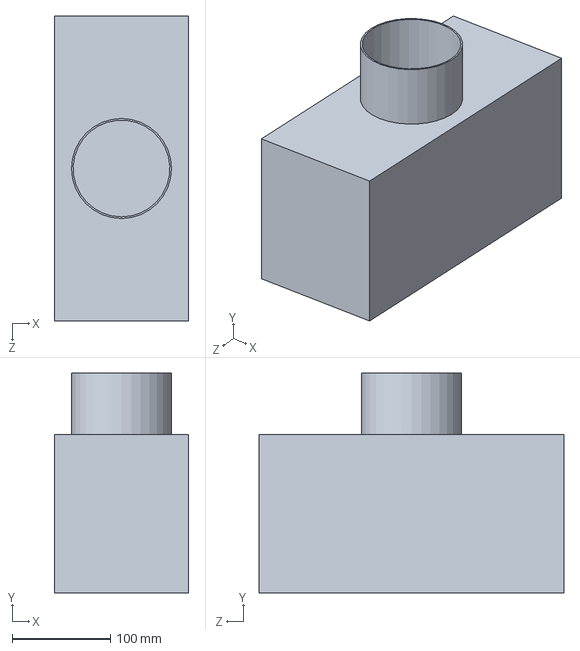
[picture p93: CAD file, 2011-03-22]
Fermi1/ion pump.SLDPRT
136.4 x 223.0 x 309.9 mm
