akeshet/New-Machine-Drawings/Na table enclosure/Na door vert.SLDPRT

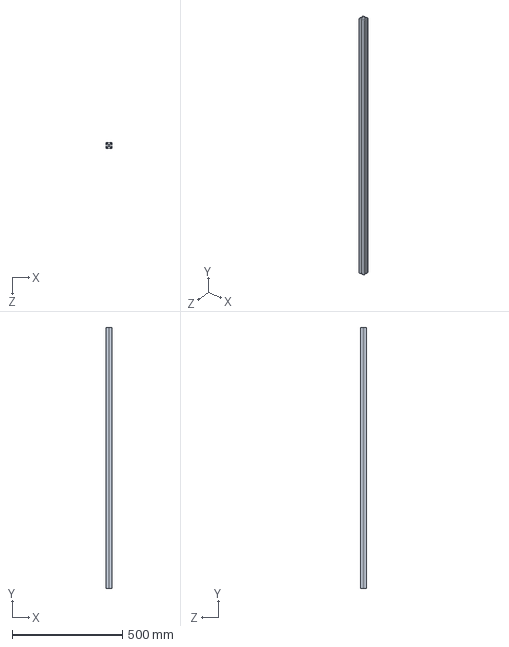
[picture p94: CAD file, 2011-12-12]
Na table enclosure/Na door vert.SLDPRT
25.4 x 1181.1 x 25.4 mm
