akeshet/New-Machine-Drawings/top imaging custom length tube.SLDPRT

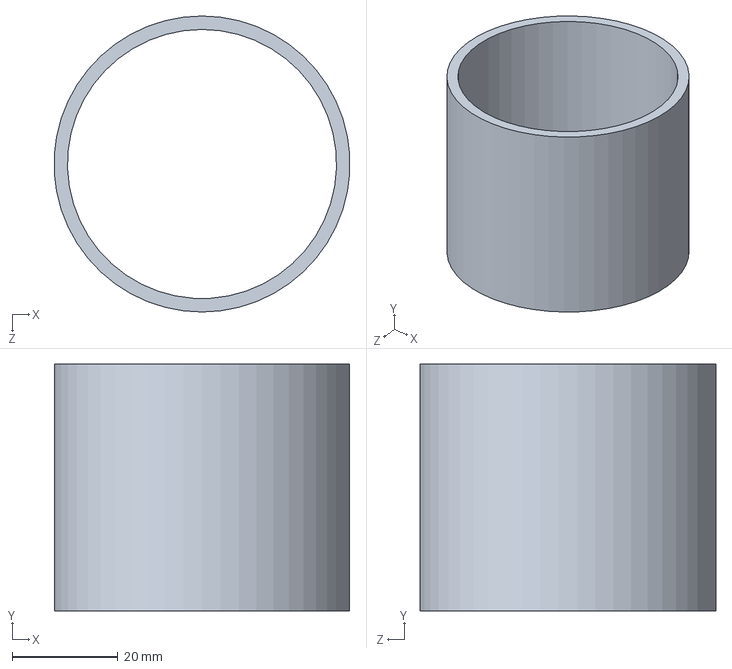
[picture p95: CAD file, 2012-07-12]
top imaging custom length tube.SLDPRT
55.8 x 46.6 x 55.9 mm
