akeshet/New-Machine-Drawings/Fermi1/2.5in_gatevalve.SLDPRT

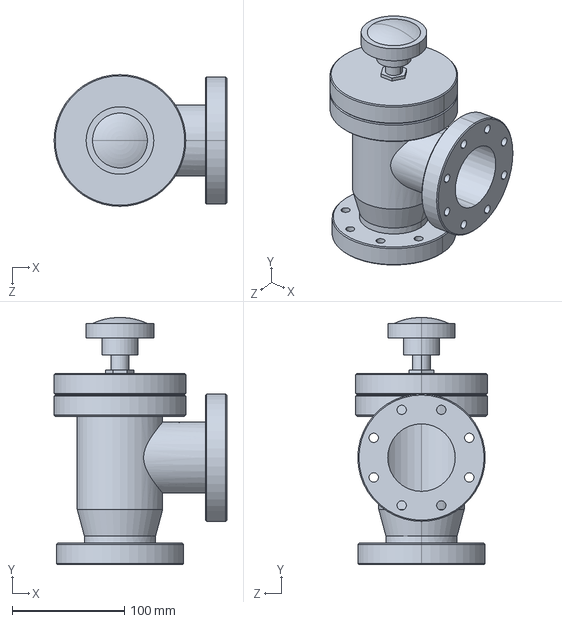
[picture p96: CAD file, 2011-03-22]
Fermi1/2.5in_gatevalve.SLDPRT
153.9 x 220.1 x 117.3 mm
