akeshet/New-Machine-Drawings/special optics lens footprint.SLDPRT

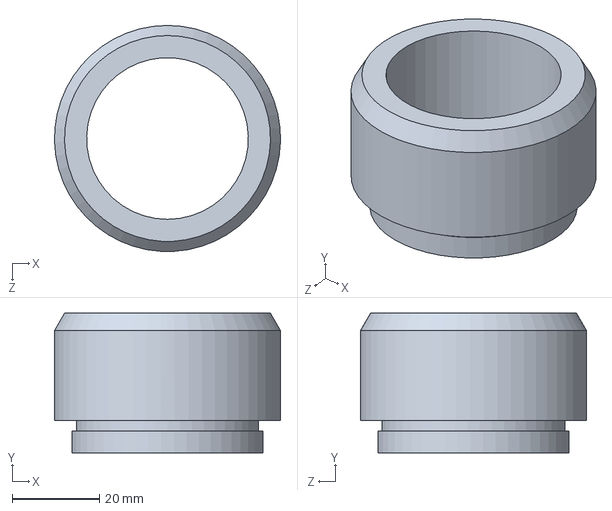
[picture p97: CAD file, 2012-07-12]
special optics lens footprint.SLDPRT
51.7 x 32.0 x 51.8 mm
