akeshet/New-Machine-Drawings/studies/before angled pump body/top window.SLDPRT

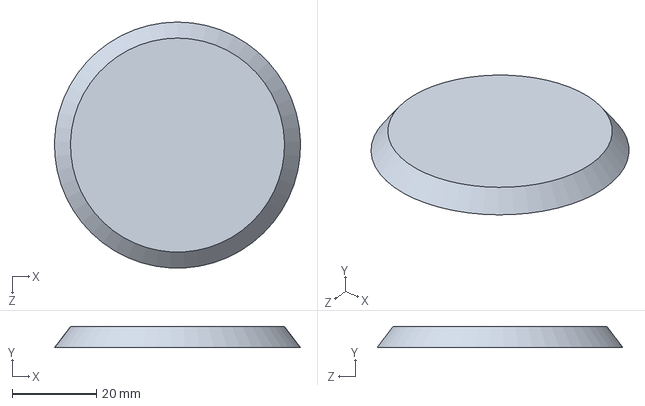
[picture p98: CAD file, 2011-03-22]
studies/before angled pump body/top window.SLDPRT
58.4 x 5.00 x 58.4 mm
