akeshet/New-Machine-Drawings/Fermi1/slower_tube_long.SLDPRT

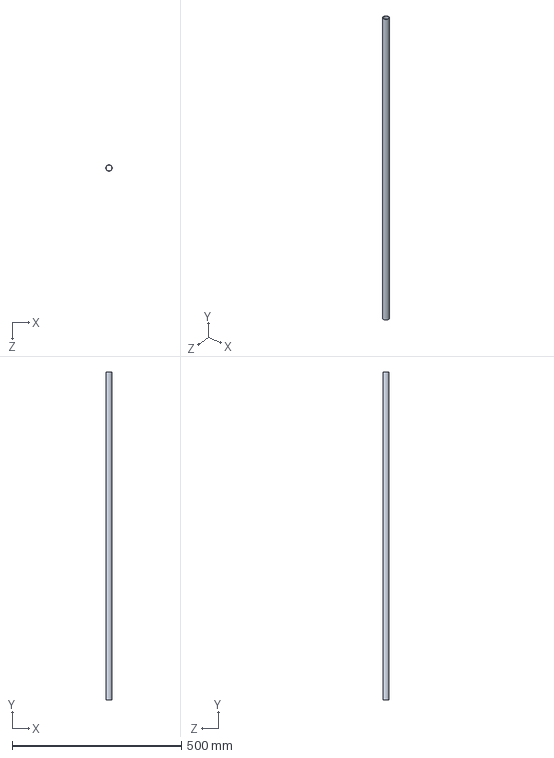
[picture p99: CAD file, 2011-03-22]
Fermi1/slower_tube_long.SLDPRT
19.1 x 970.0 x 19.1 mm
