akeshet/New-Machine-Drawings/Na table enclosure/Na upper long.SLDPRT

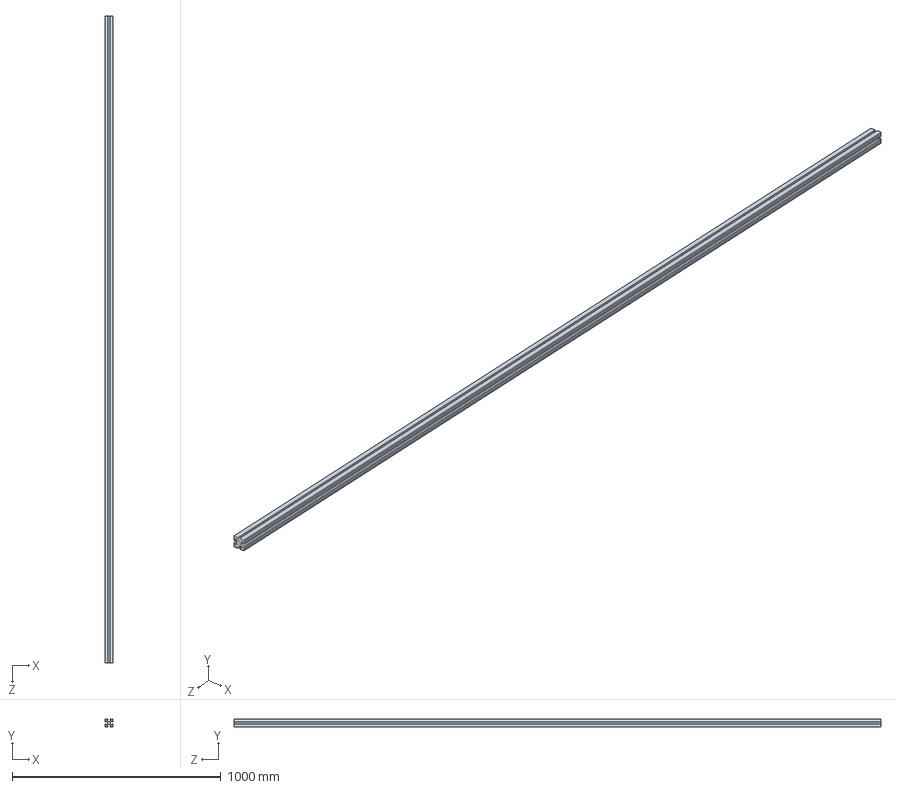
[picture p100: CAD file, 2011-12-12]
Na table enclosure/Na upper long.SLDPRT
38.1 x 38.1 x 3100.4 mm
