akeshet/New-Machine-Drawings/sm2l03.sldprt

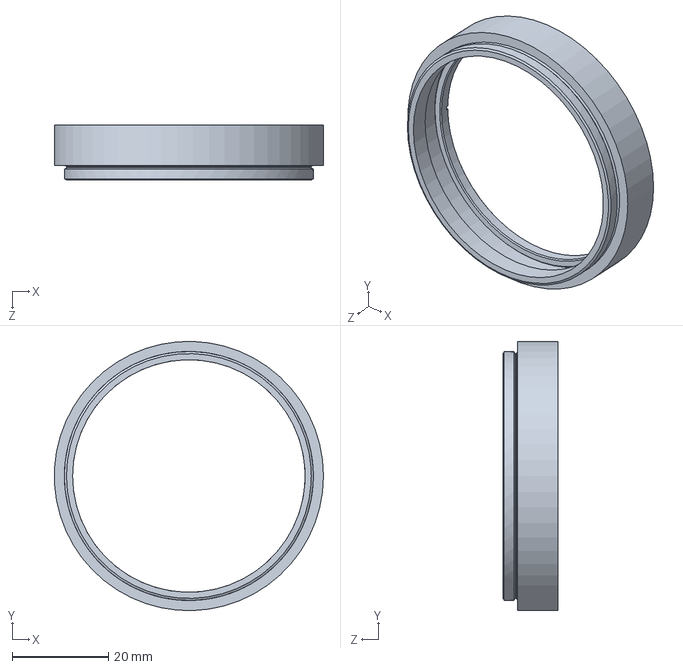
[picture p101: CAD file, 2012-07-12]
sm2l03.sldprt
55.8 x 55.9 x 11.4 mm
