akeshet/New-Machine-Drawings/studies/2 inch window, close coils/fermi1 small bucket_2.3.SLDPRT

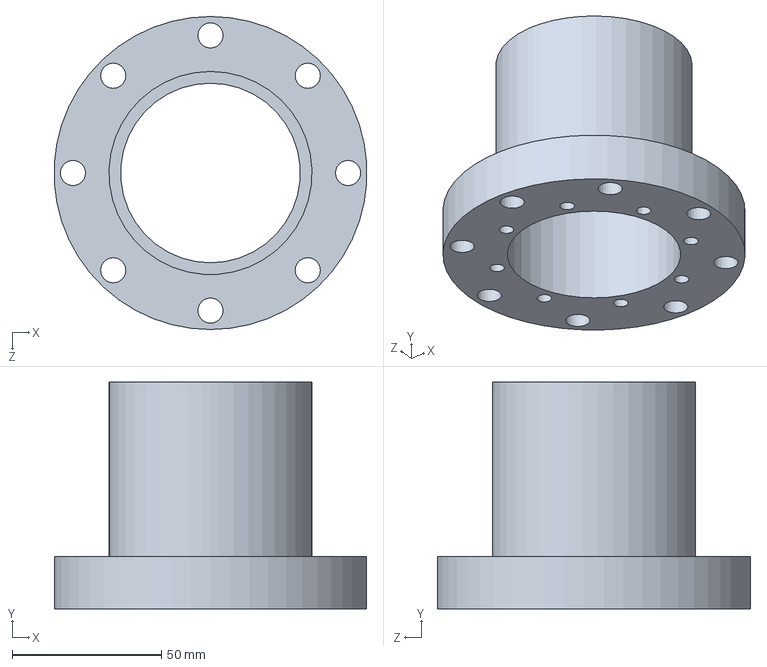
[picture p102: CAD file, 2011-03-22]
studies/2 inch window, close coils/fermi1 small bucket_2.3.SLDPRT
104.7 x 75.9 x 104.9 mm
