akeshet/New-Machine-Drawings/studies/before angled pump body/side bucket.sldprt

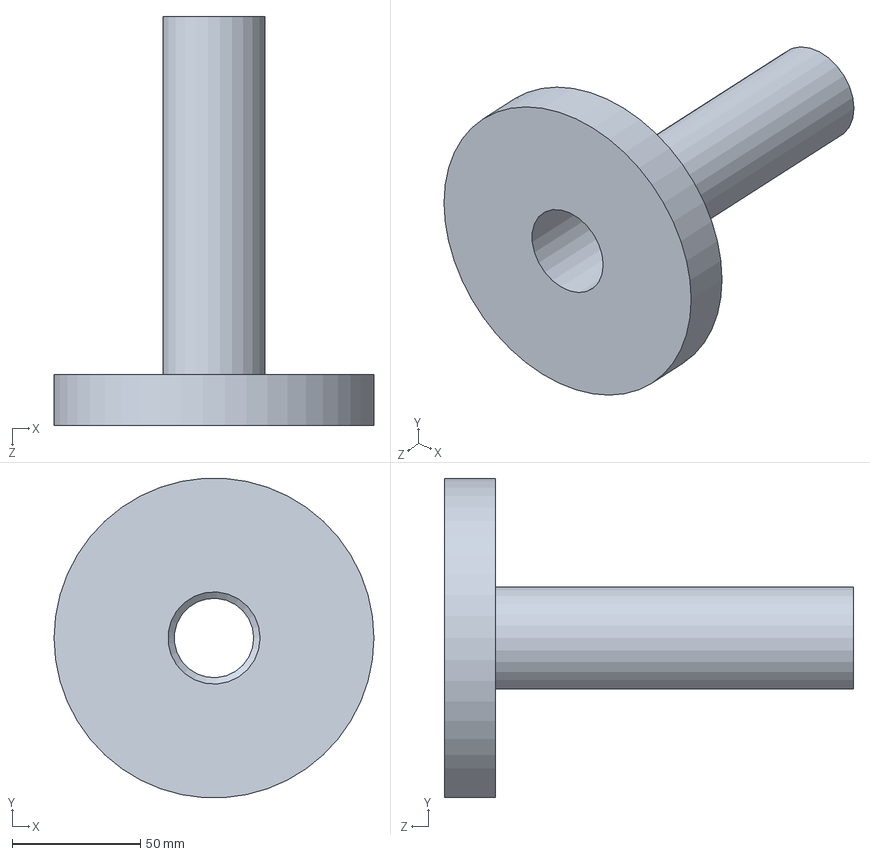
[picture p103: CAD file, 2011-03-22]
studies/before angled pump body/side bucket.sldprt
124.9 x 124.6 x 159.7 mm
