akeshet/New-Machine-Drawings/8020 enclosure rev2/lower short.SLDPRT

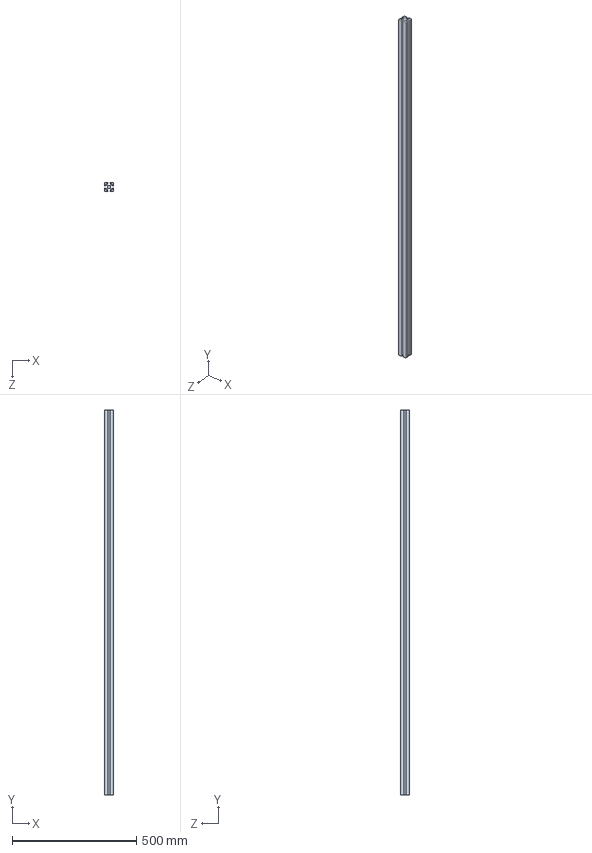
[picture p104: CAD file, 2012-07-12]
8020 enclosure rev2/lower short.SLDPRT
38.1 x 1549.4 x 38.1 mm
