akeshet/New-Machine-Drawings/Fermi1/4.5in_CF_flange.SLDPRT

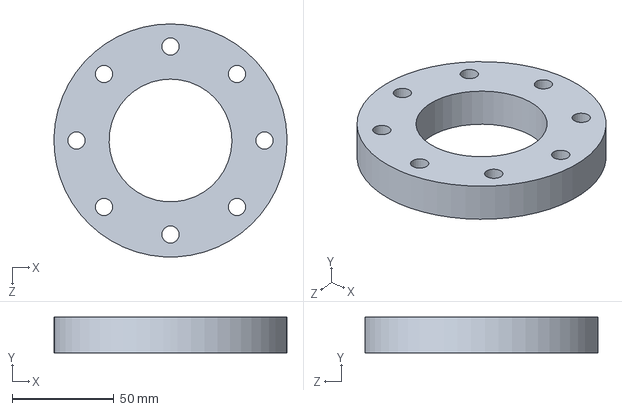
[picture p105: CAD file, 2011-03-22]
Fermi1/4.5in_CF_flange.SLDPRT
114.2 x 17.5 x 114.3 mm
