akeshet/New-Machine-Drawings/Na table enclosure/Na narrow door horiz.SLDPRT

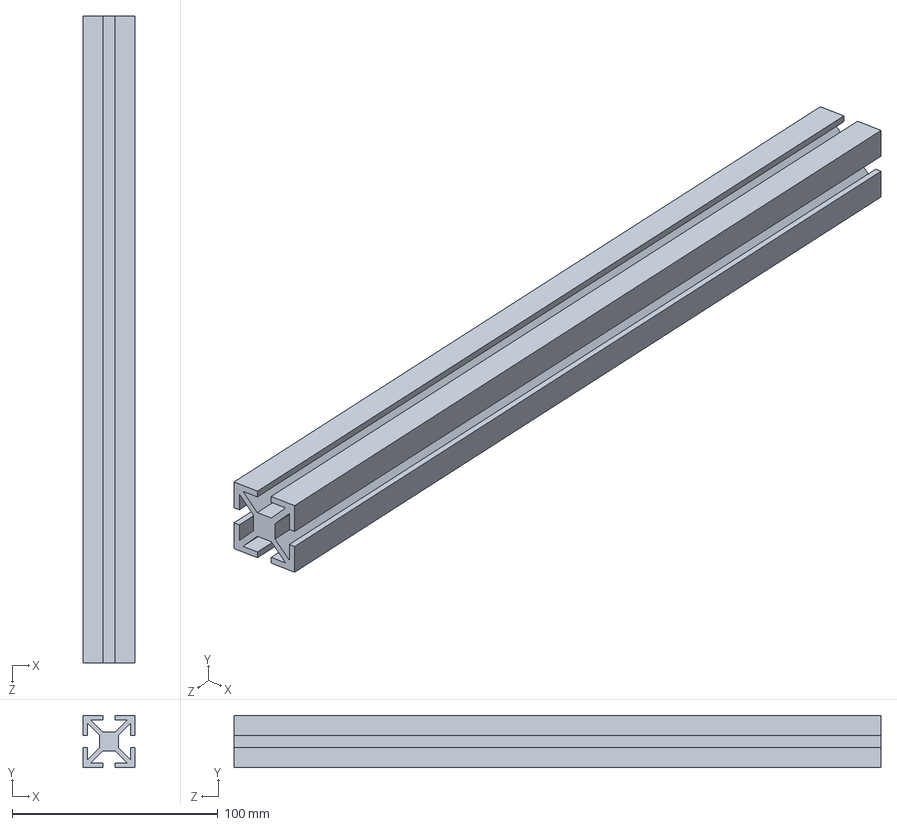
[picture p106: CAD file, 2011-12-12]
Na table enclosure/Na narrow door horiz.SLDPRT
25.4 x 25.4 x 314.5 mm
