akeshet/New-Machine-Drawings/studies/2 inch window, close coils/top coil.SLDPRT

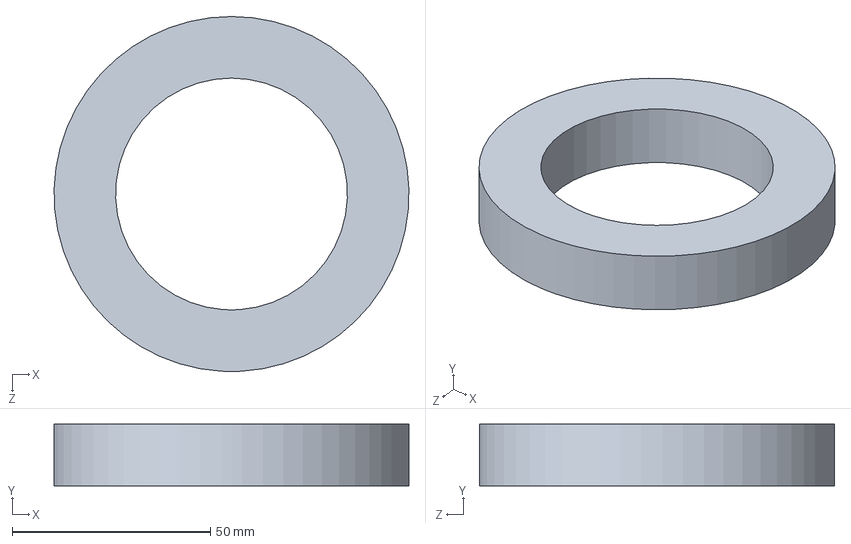
[picture p107: CAD file, 2011-03-22]
studies/2 inch window, close coils/top coil.SLDPRT
89.4 x 15.5 x 89.5 mm
