akeshet/New-Machine-Drawings/studies/before angled pump body/fermi1 small bucket.SLDPRT

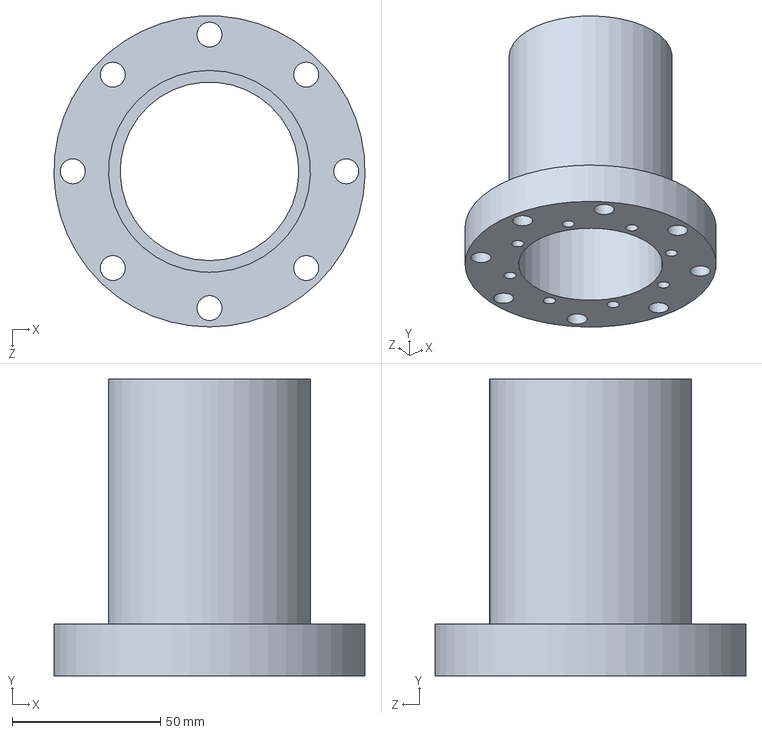
[picture p108: CAD file, 2011-03-22]
studies/before angled pump body/fermi1 small bucket.SLDPRT
104.8 x 100.1 x 104.8 mm
