akeshet/New-Machine-Drawings/swagelok/swagelok 400-9 elbow.SLDPRT

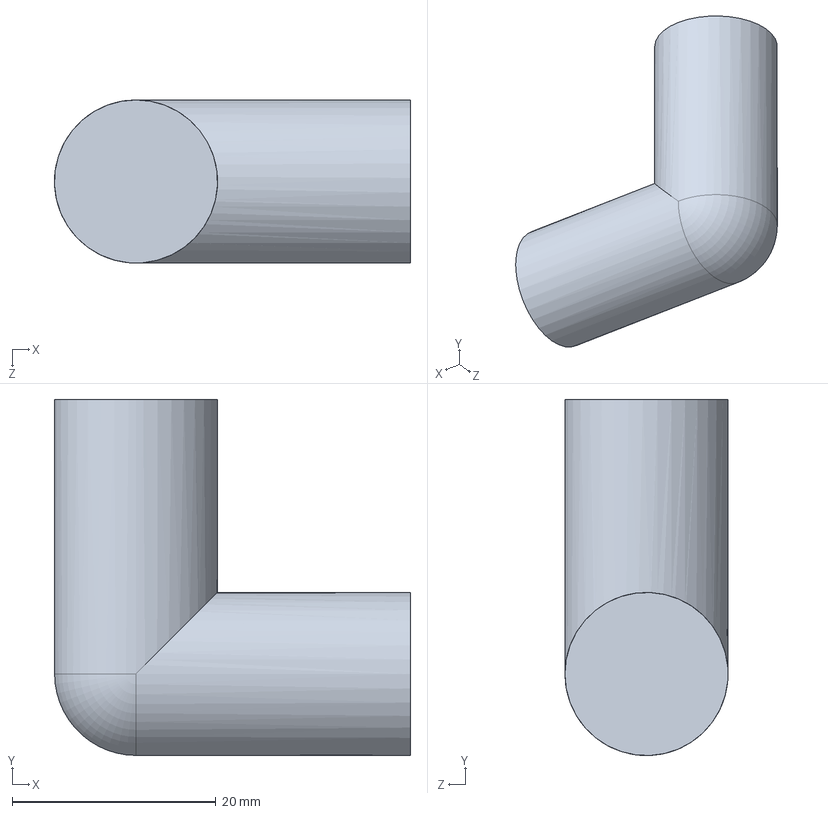
[picture p109: CAD file, 2012-07-12]
swagelok/swagelok 400-9 elbow.SLDPRT
34.9 x 34.9 x 16.0 mm
