akeshet/New-Machine-Drawings/8020 enclosure rev2/shorter 45 degree piece.SLDPRT

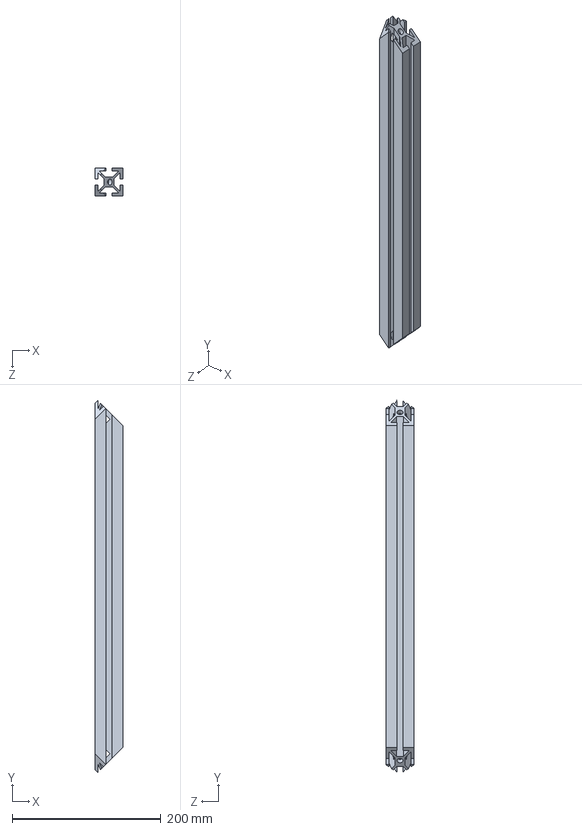
[picture p110: CAD file, 2012-07-12]
8020 enclosure rev2/shorter 45 degree piece.SLDPRT
38.1 x 499.6 x 38.1 mm
