akeshet/New-Machine-Drawings/Fermi1/2.75in_CF_flange_blank.SLDPRT

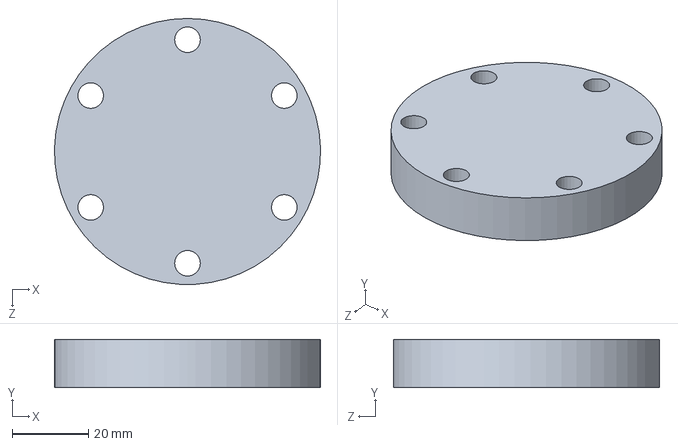
[picture p111: CAD file, 2011-03-22]
Fermi1/2.75in_CF_flange_blank.SLDPRT
69.8 x 12.7 x 69.8 mm
