akeshet/New-Machine-Drawings/studies/2 inch window, close coils/mdc standard multiport window.SLDPRT

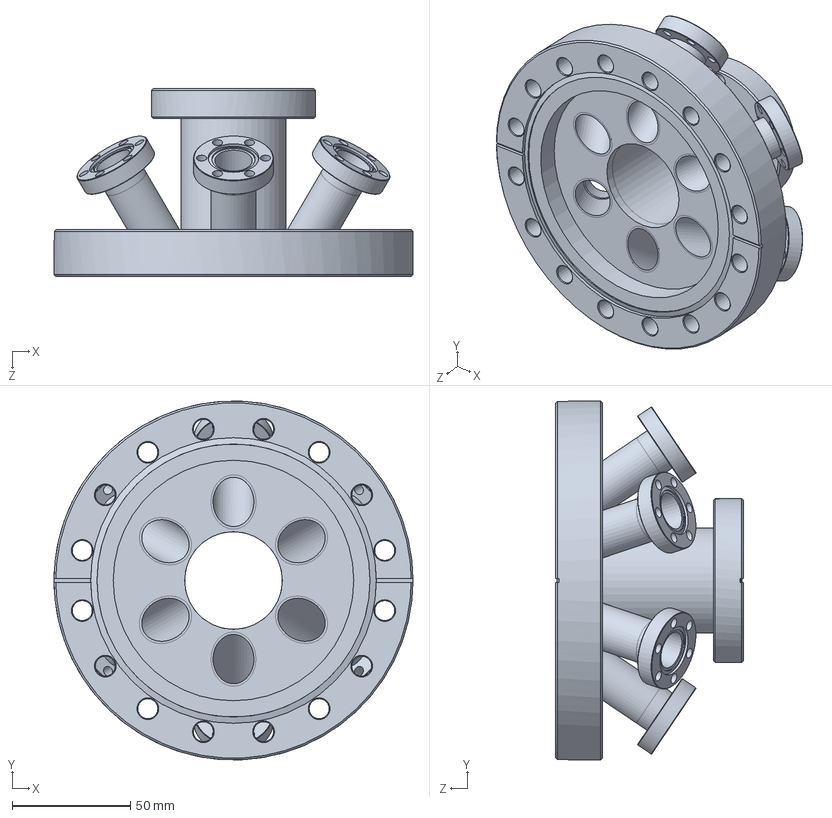
[picture p112: CAD file, 2011-03-22]
studies/2 inch window, close coils/mdc standard multiport window.SLDPRT
151.6 x 151.6 x 79.4 mm
