akeshet/New-Machine-Drawings/studies/before angled pump body/top coil alternate design 1.SLDPRT

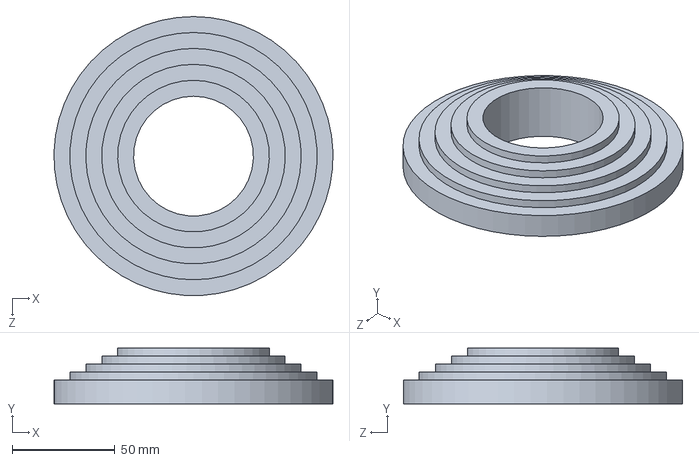
[picture p113: CAD file, 2011-03-22]
studies/before angled pump body/top coil alternate design 1.SLDPRT
136.0 x 27.2 x 135.9 mm
