akeshet/New-Machine-Drawings/swagelok/swagelok b-4tf-90 filter.SLDPRT

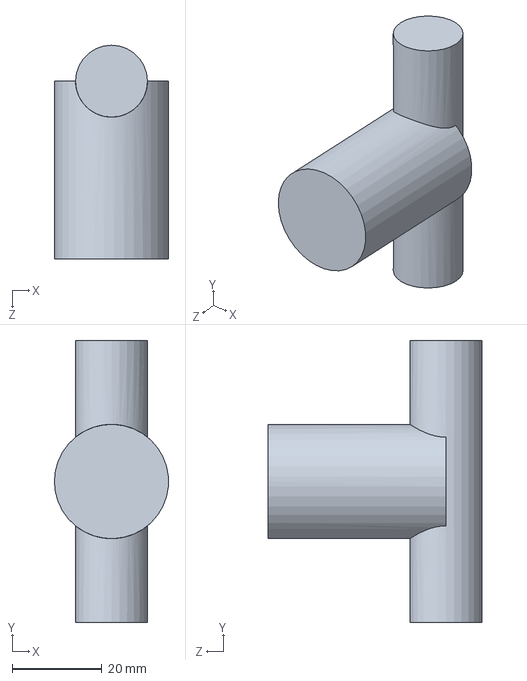
[picture p114: CAD file, 2012-07-12]
swagelok/swagelok b-4tf-90 filter.SLDPRT
25.4 x 62.7 x 47.5 mm
