akeshet/New-Machine-Drawings/Fermi1/2.75in_elbow_tube.SLDPRT

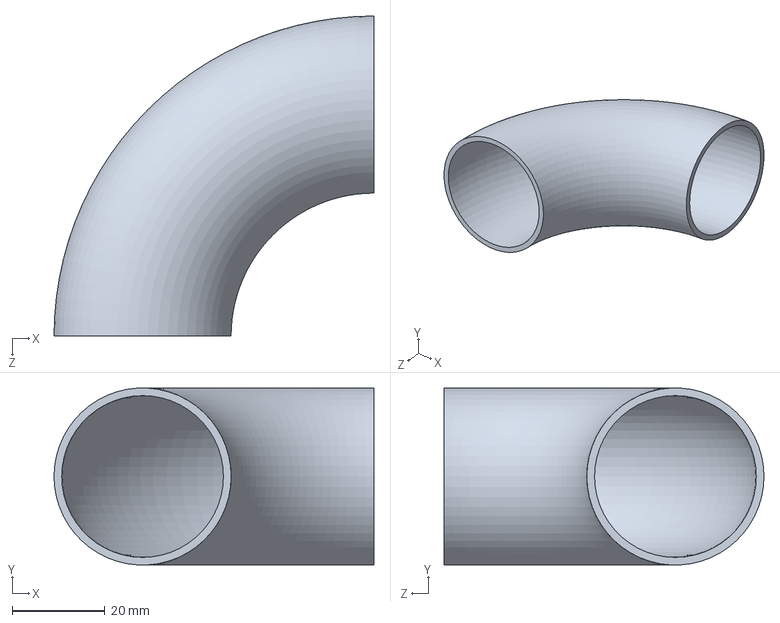
[picture p115: CAD file, 2011-03-22]
Fermi1/2.75in_elbow_tube.SLDPRT
68.8 x 38.0 x 68.8 mm
