akeshet/New-Machine-Drawings/Na table enclosure/Na corner post.SLDPRT

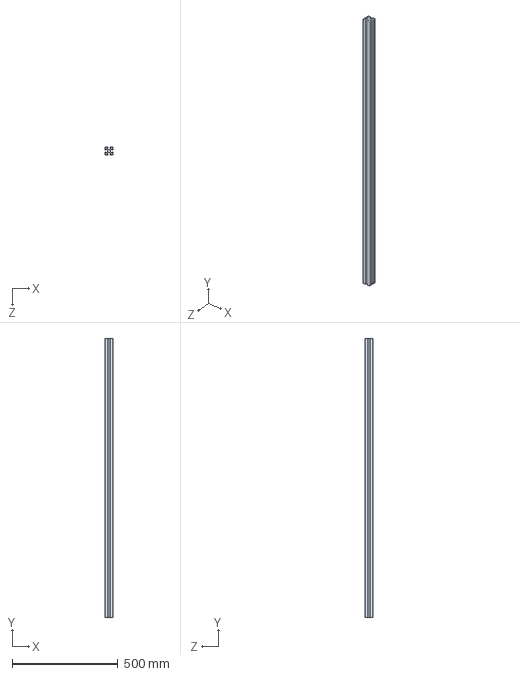
[picture p116: CAD file, 2011-12-12]
Na table enclosure/Na corner post.SLDPRT
38.1 x 1320.8 x 38.1 mm
