akeshet/New-Machine-Drawings/studies/2 inch window, close coils/Top Bucket.sldprt

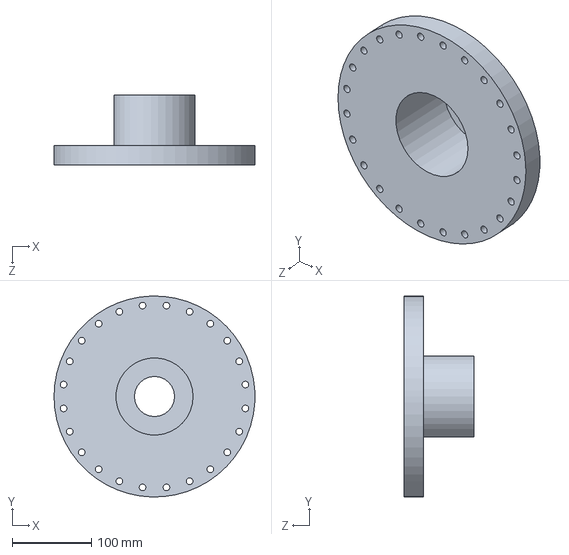
[picture p117: CAD file, 2011-03-22]
studies/2 inch window, close coils/Top Bucket.sldprt
254.0 x 253.9 x 88.0 mm
