akeshet/New-Machine-Drawings/Fermi1/6in_CF_flange.SLDPRT

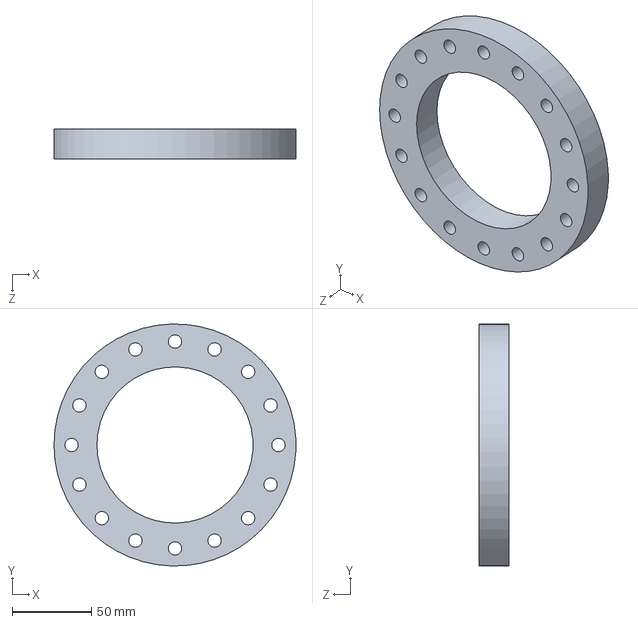
[picture p118: CAD file, 2011-03-22]
Fermi1/6in_CF_flange.SLDPRT
152.4 x 152.3 x 19.1 mm
