akeshet/New-Machine-Drawings/Fermi1/2.75-4.5in_zerolenth_reducer.SLDPRT

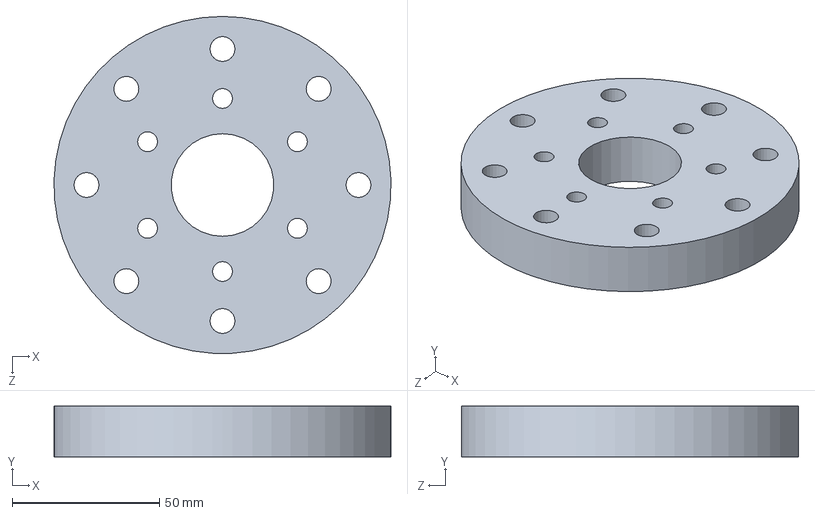
[picture p119: CAD file, 2011-03-22]
Fermi1/2.75-4.5in_zerolenth_reducer.SLDPRT
114.2 x 17.3 x 114.3 mm
