akeshet/New-Machine-Drawings/magnetic linear feedthrough.SLDPRT

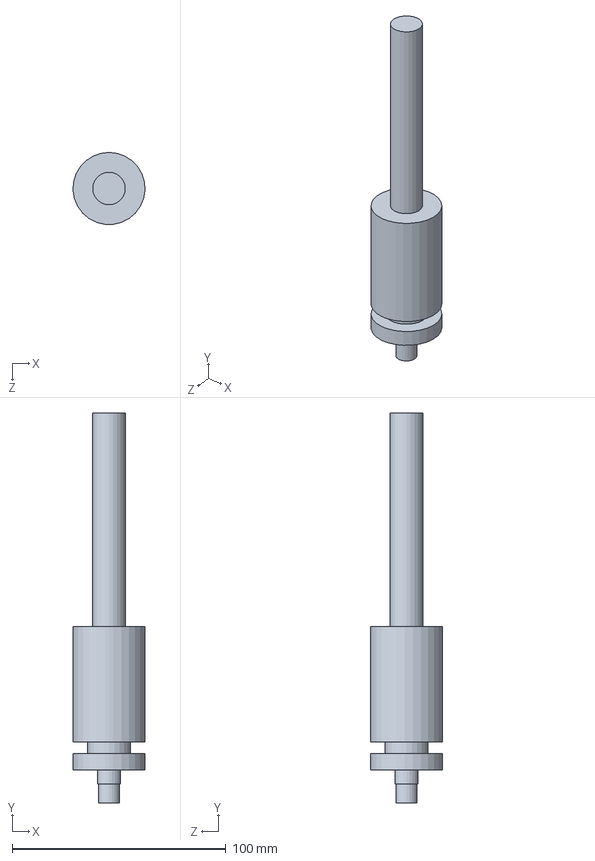
[picture p120: CAD file, 2012-07-12]
magnetic linear feedthrough.SLDPRT
33.7 x 182.6 x 33.8 mm
