akeshet/New-Machine-Drawings/Na table enclosure/Na wide door horiz.SLDPRT

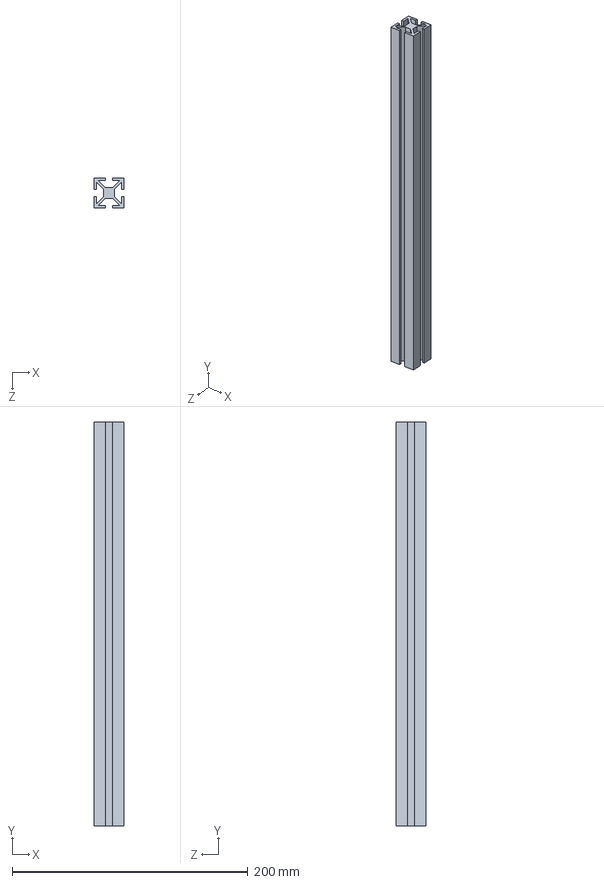
[picture p121: CAD file, 2011-12-12]
Na table enclosure/Na wide door horiz.SLDPRT
25.4 x 342.9 x 25.4 mm
