akeshet/New-Machine-Drawings/275 holder plate.SLDPRT

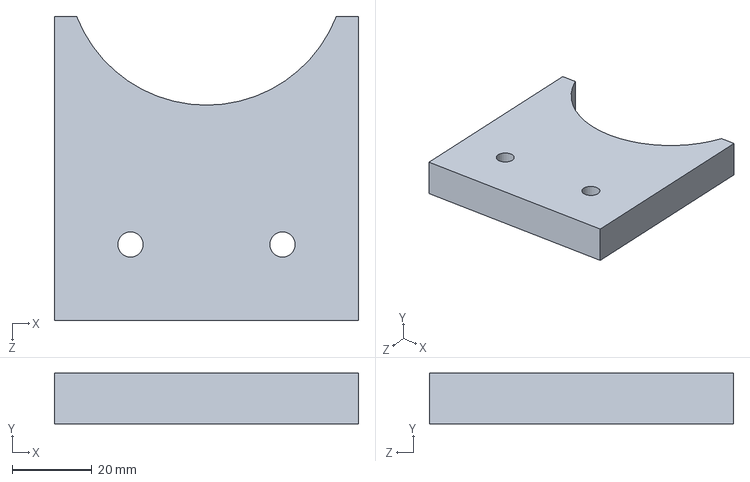
[picture p122: CAD file, 2012-07-12]
275 holder plate.SLDPRT
76.2 x 12.7 x 76.2 mm
