akeshet/New-Machine-Drawings/Fermi1/4.5-6in_zerolenth_reducer.SLDPRT

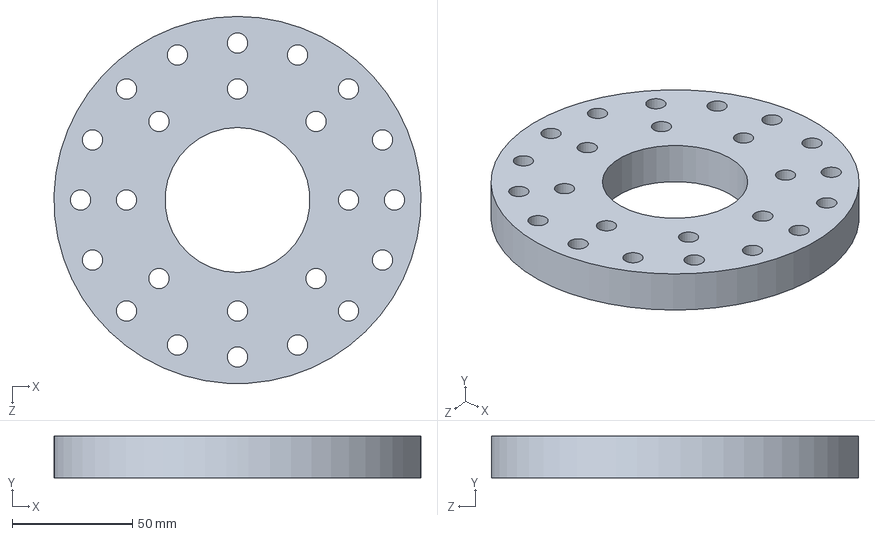
[picture p123: CAD file, 2011-03-22]
Fermi1/4.5-6in_zerolenth_reducer.SLDPRT
152.3 x 17.3 x 152.4 mm
