akeshet/New-Machine-Drawings/(list of files, cad)

Other CAD files:
studies/2 inch window, close coils/routeAssy1-central_vacuum_system.sldasm
studies/before angled pump body/routeAssy1-central_vacuum_system.sldasm
routeAssy2-central_vacuum_system.sldasm
routeAssy3-central_vacuum_system.sldasm
routeAssy4-central_vacuum_system.sldasm
Cable-routeAssy4-central_vacuum_system.sldprt
1x10 magtrap current manifold assem.SLDASM
Part12^full machine.sldprt
routeAssy1-central_vacuum_system.sldasm
slower B current manifold.SLDASM
8020 template parts/1515.SLDPRT
Na table enclosure/Na lower end.SLDPRT
oven and slower/slower compensation coil peyman design.SLDPRT
studies/2 inch window, close coils/oven and slower/increasing field slower coil peyman design.SLDPRT
approximate sketches/Part2.SLDPRT
studies/2 inch window, close coils/fermi1 bucket nofeedthrough.SLDPRT
studies/before angled pump body/fermi1 bucket nofeedthrough.SLDPRT
studies/before angled pump body/oven and slower/increasing field slower coil peyman design.SLDPRT
8020 enclosure rev2/guidebar.SLDPRT
studies/2 inch window, close coils/custom multiport window.SLDPRT
Na table enclosure/Na lower side.SLDPRT
8020 enclosure rev2/door wide.SLDPRT
8020 enclosure rev2/door vertical.SLDPRT
8020 enclosure rev2/door narrow.SLDPRT
1 inch atom cloud.SLDPRT
1x5 magtrap current manifold board.SLDPRT
2 inch lens tube.SLDPRT
2.75 conflat holder plate.SLDDRW
2.75 conflat holder top.SLDDRW
21620.SLDASM
275 gasket.SLDPRT
2x4.SLDPRT
4.5 double mini feedthrough.SLDPRT
45 holder legs.sldprt
45 holder plate.SLDPRT
6-8in_zerolenth_reducer.SLDPRT
8020 enclosure rev2/upper long.SLDPRT
8020 enclosure rev2/upper short.SLDPRT
8020 enclosure/1010 door vertical.SLDPRT
8020 enclosure/1010 fully open door.SLDASM
8020 enclosure/1010 guidebar.SLDPRT
8020 enclosure/1010 narrow door horiz.SLDPRT
8020 enclosure/1010 narrow door.SLDASM
8020 enclosure/1010 wide door horiz.SLDPRT
8020 enclosure/1010 wide door.SLDASM
8020 enclosure/Mirror1010 fully open door.SLDASM
8020 enclosure/Mirror1010 fully open door1.SLDASM
8020 enclosure/Mirror1010 fully open door2.SLDASM
8020 enclosure/Mirror1010 guidebar.SLDPRT
8020 enclosure/Mirror1010 guidebar1.SLDPRT
8020 enclosure/Mirror1010 narrow door.SLDASM
8020 enclosure/Mirror1010 narrow door1.SLDASM
8020 enclosure/Mirror1010 wide door.SLDASM
8020 enclosure/Mirror1010 wide door1.SLDASM
8020 enclosure/Mirror45 degree support beam.SLDPRT
8020 enclosure/MirrorMirror1010 fully open door.SLDASM
8020 enclosure/MirrorMirror1010 fully open door1.SLDASM
8020 enclosure/MirrorMirror1010 fully open door11.SLDASM
8020 enclosure/MirrorMirror1010 guidebar.SLDPRT
8020 enclosure/MirrorMirror1010 narrow door.SLDASM
8020 enclosure/MirrorMirror1010 wide door.SLDASM
8020 enclosure/MirrorMirrorMirror1010 fully open door.SLDASM
8020 enclosure/MirrorMirrornarrow door.SLDASM
8020 enclosure/MirrorMirrorwide door.SLDASM
8020 enclosure/Mirrornarrow door.SLDASM
8020 enclosure/Mirrornarrow door1.SLDASM
8020 enclosure/Mirrorwide door.SLDASM
8020 enclosure/Mirrorwide door1.SLDASM
8020 enclosure/appendix.SLDPRT
8020 enclosure/cornerpost.SLDPRT
8020 enclosure/door vertical.SLDPRT
8020 enclosure/enclosure.SLDASM
8020 enclosure/lower crossbeam 1.SLDPRT
8020 enclosure/lower crossbeam 2.SLDPRT
8020 enclosure/midpost.SLDPRT
8020 enclosure/narrow door horizontal.SLDPRT
8020 enclosure/narrow door.SLDASM
8020 enclosure/shorter 45 degree piece.SLDDRW
8020 enclosure/upper crossbeam 1.SLDDRW
8020 enclosure/upper crossbeam 1.SLDPRT
8020 enclosure/upper crossbeam 2.SLDPRT
8020 enclosure/wide door horizontal.SLDPRT
8020 enclosure/wide door.SLDASM
Collimation Plate.sldprt
Fermi1/2.75-4.5in_reducer_tube.SLDPRT
Fermi1/2.75in_CF_feedthrough.SLDPRT
Fermi1/2.75in_CF_flange.SLDPRT
Fermi1/2.75in_bellow_tube.SLDPRT
Fermi1/2.75in_halfnipple_tube.SLDPRT
Fermi1/2.75in_sixway_tube.SLDPRT
Fermi1/2.75in_tee_tube.SLDPRT
Fermi1/4.5-6in_reducer_tube.SLDPRT
Fermi1/4.5in_CF_flange_blank.SLDPRT
Fermi1/4.5in_tee_tube.SLDPRT
Fermi1/4.5in_turbopump.SLDPRT
Fermi1/6-8in_zerolenth_reducer.SLDPRT
Fermi1/Large Bucket.SLDPRT
Fermi1/Large Bucket_no feedthrough.SLDPRT
Fermi1/adjustable differential pumping tube.SLDPRT
Fermi1/bellow_tube.SLDPRT
Fermi1/bucketwindow.SLDPRT
Fermi1/coil.SLDPRT
Fermi1/coilmountplate.SLDPRT
Fermi1/cold cup face plate.SLDPRT
Fermi1/cold cup.SLDPRT
Fermi1/coldcupmount.SLDPRT
Fermi1/coldcupmountplate.SLDPRT
Fermi1/fixed differential pumping tube.SLDPRT
Fermi1/gatevalve_body.SLDPRT
Fermi1/honeycomb.SLDPRT
Fermi1/ion pump tube.SLDPRT
Fermi1/ion_gauge.SLDPRT
Fermi1/laser beam.SLDPRT
Fermi1/lug.SLDPRT
Fermi1/min-2.75in_zerolenth_reducer.SLDPRT
Fermi1/mini_flange.SLDPRT
Fermi1/minilength_nipple_tube.SLDPRT
Fermi1/mot.SLDPRT
Fermi1/nozzle copper tube.SLDPRT
Fermi1/nozzle face plate.SLDPRT
Fermi1/nozzle flange.SLDPRT
Fermi1/nozzle1.SLDPRT
Fermi1/oven_shutter.SLDPRT
Fermi1/small bucket.SLDPRT
Fermi1/small bucket_2.3.SLDPRT
Flag.sldprt
Mirrorcustom breadboard.SLDPRT
Mirrornewport breadboard.SLDPRT
Na table enclosure/Na upper short.SLDPRT
Oven holder legs.sldprt
Top Bucket.sldprt
alternate half flange design.SLDPRT
baseplate.SLDDRW
bellows.SLDPRT
bifold narrow door.SLDPRT
bifold wide door.SLDPRT
bnc feedthrough mdc 632006.SLDPRT
canopy design.SLDDRW
canopy.sldprt
clean air module.SLDPRT
coil cartoon.SLDDRW
coil mounting plate.SLDPRT
collimation rod.SLDPRT
current manifold holding bar.sldprt
custom breadboard.SLDPRT
custom multiport window.SLDPRT
custom six way.SLDPRT
drawings/dp tubes quote request.SLDDRW
drawings/machine coordinate overview.SLDDRW
drawings/neg drawing.SLDDRW
drawings/quote requests/main_chamber quote.SLDDRW
drawings/quote requests/side bucket quote.SLDDRW
drawings/quote requests/top bucket quote.SLDDRW
drawings/sharon vacuum draft drawing.SLDDRW
drawings/shutter assembly parts/Collimation Plate.SLDDRW
drawings/shutter assembly parts/Flag.SLDDRW
drawings/shutter assembly parts/shutter shaft.SLDDRW
drawings/side bucket question draw 1.SLDDRW
drawings/top breadboard alternate design noholes.SLDDRW
drawings/top bucket assem question draw 1.SLDDRW
drawings/top bucket nut locations.SLDDRW
electronics boxes/airmaster.DXF
electronics boxes/airmaster.SLDDRW
electronics boxes/relaymaster 499 front panel.DXF
electronics boxes/relaymaster 499 front panel.SLDDRW
fermi1 bucket nofeedthrough.SLDPRT
improved half miniflange ring.SLDDRW
improved half miniflange ring.SLDPRT
inficon rga larger.SLDPRT
jigs/coil potting jig.DXF
jigs/coil potting jig.SLDDRW
left U.SLDPRT
magnetic rotation feedthrough.SLDPRT
magtrap current manifold board.SLDPRT
mcmaster parts/cable tray.SLDPRT
mcmaster parts/lug 6920K22.SLDPRT
mcmaster parts/lug 6920K28.SLDPRT
mdc flag holder.SLDPRT
mdc rod clamp.SLDPRT
misc/window tube inquiry.SLDDRW
mititoyu objective M Plan NIR 5X.SLDPRT
mixing nozzle.SLDPRT
movable dp retainer.SLDPRT
movable dp tube holder.SLDPRT
movable dp tube.SLDPRT
newport breadboard.SLDDRW
newport breadboard.SLDPRT
original miniflange bolt ring.SLDPRT
right U.SLDPRT
room renovation drawing.SLDDRW
scary al bar.SLDPRT
second dp tube.SLDPRT
shutter flag plate.sldprt
shutter flag.SLDPRT
shutter shaft.SLDPRT
side bucket extra holes.SLDDRW
side bucket.sldprt
slower A current manifold board.SLDPRT
slower B current manifold board.SLDPRT
slower C current manifold.SLDPRT
slower breadboard.SLDPRT
slower long tube.SLDDRW
slower long tube.SLDPRT
studies/before angled pump body/custom multiport window.SLDPRT
studies/before angled pump body/drawings/side bucket question draw 1.SLDDRW
studies/before angled pump body/drawings/top bucket assem question draw 1.SLDDRW
studies/before angled pump body/top coil.SLDPRT
swagelok/swagelok 400-4 union cross.SLDPRT
swagelok/swagelok 42S4-a valve.SLDPRT
swagelok/swagelok 810-3-8-3 reducing union t.SLDPRT
table.SLDPRT
thorlabs ae0505d08f piezo.SLDPRT
thorlabs sm2a6 customized for top lens assy.SLDPRT
top breadboard alternate design noholes.SLDPRT
top breadboard alternate design.SLDPRT
top breadboard.SLDPRT
top coil alternate design 1.SLDPRT
top coil.SLDPRT
top wiring exlusion zone.SLDPRT
twowire feedthrough.SLDPRT
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
