akeshet/New-Machine-Drawings/table position.PDF

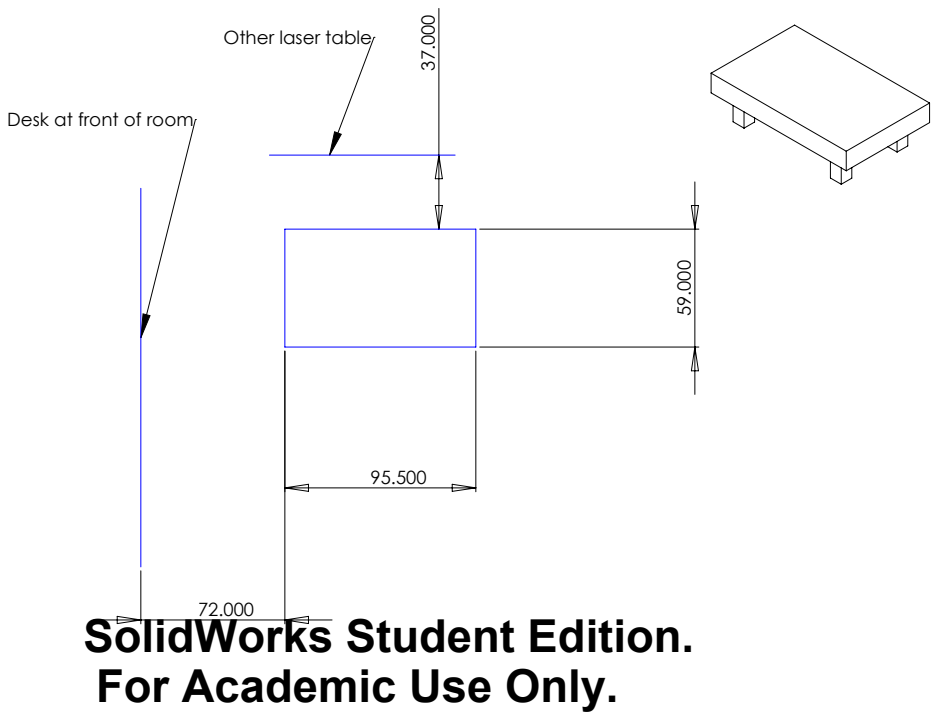
[picture p124: page 1]

Other laser table

Desk at front of room

SolidWorks Student Edition.
For Academic Use Only.
