akeshet/New-Machine-Drawings/breadboard.PDF

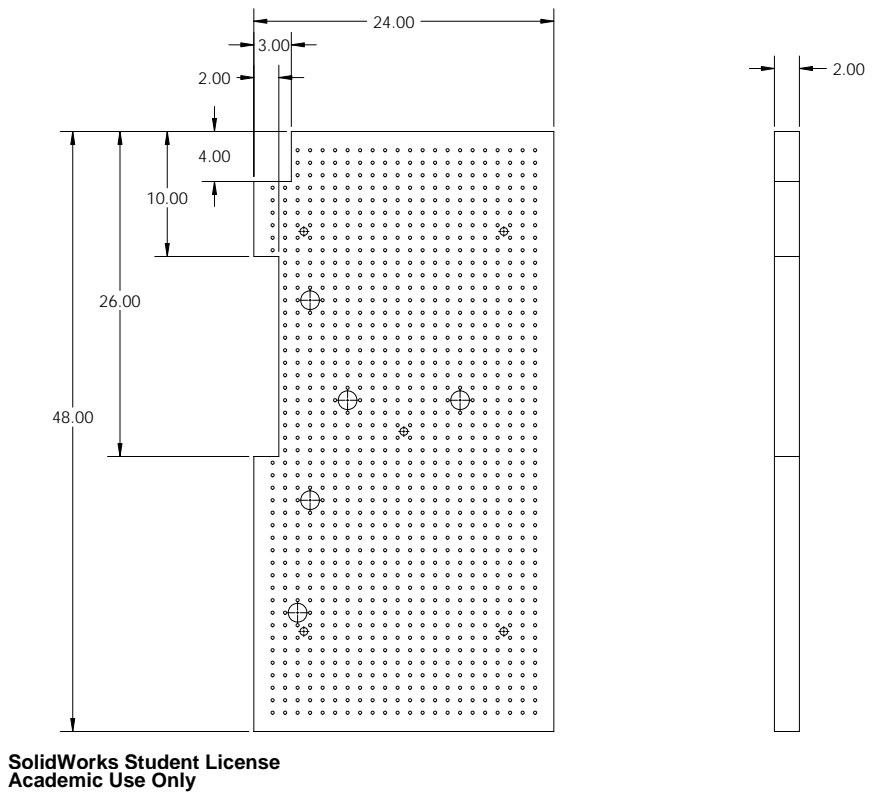
[picture p125: page 1]

SolidWorks Student License
Academic Use Only

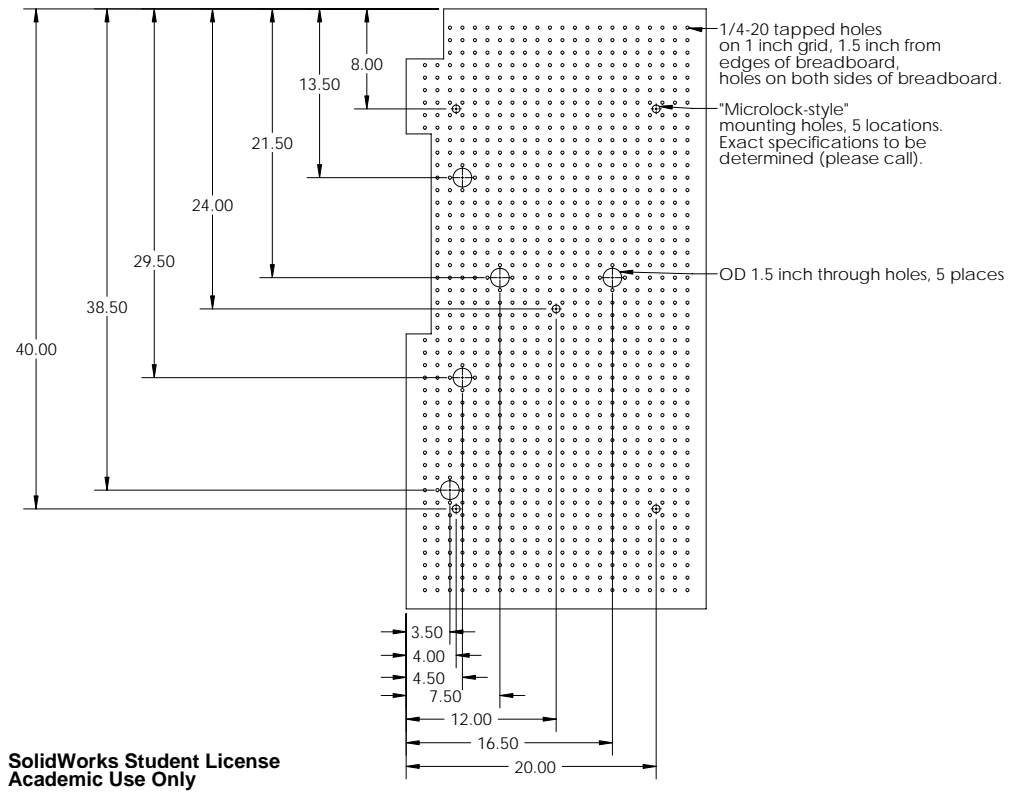
[picture p126: page 2]

1/4-20 tapped holes
on 1 inch grid, 1.5 inch from
edges of breadboard,
holes on both sides of breadboard.
"Microlock-style"
mounting holes, 5 locations.
Exact specifications to be determined (please call).

OD 1.5 inch through holes, 5 places

SolidWorks Student License
Academic Use Only
