akeshet/New-Machine-Drawings/custom breadboard second draft.PDF

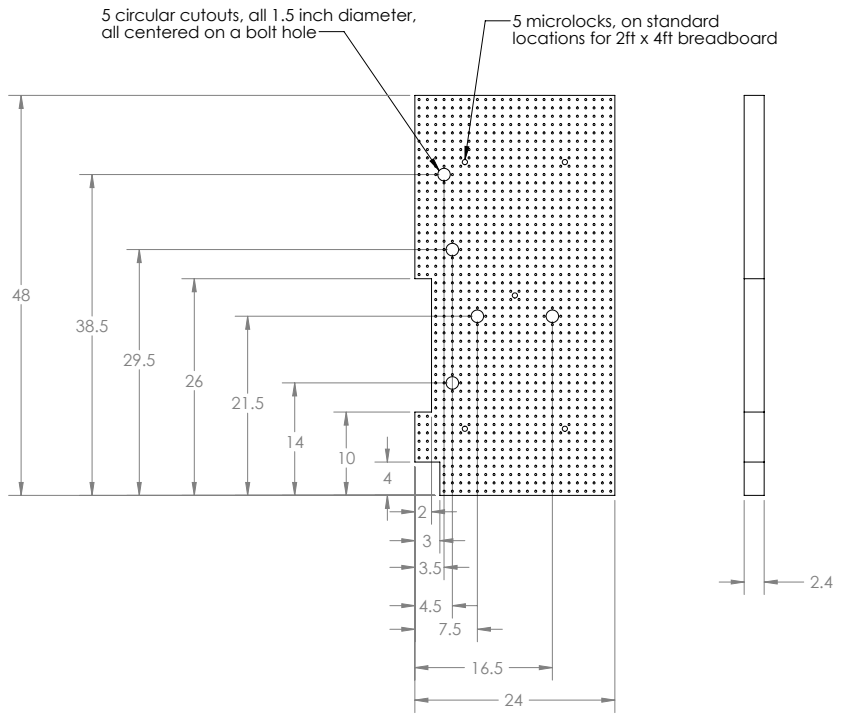
[picture p127: page 1]

5 circular cutouts, all 1.5 inch diameter,
all centered on a bolt hole

5 microlocks, on standard
locations for 2ft x 4ft breadboard
