akeshet/New-Machine-Drawings/improved half miniflange ring.PDF

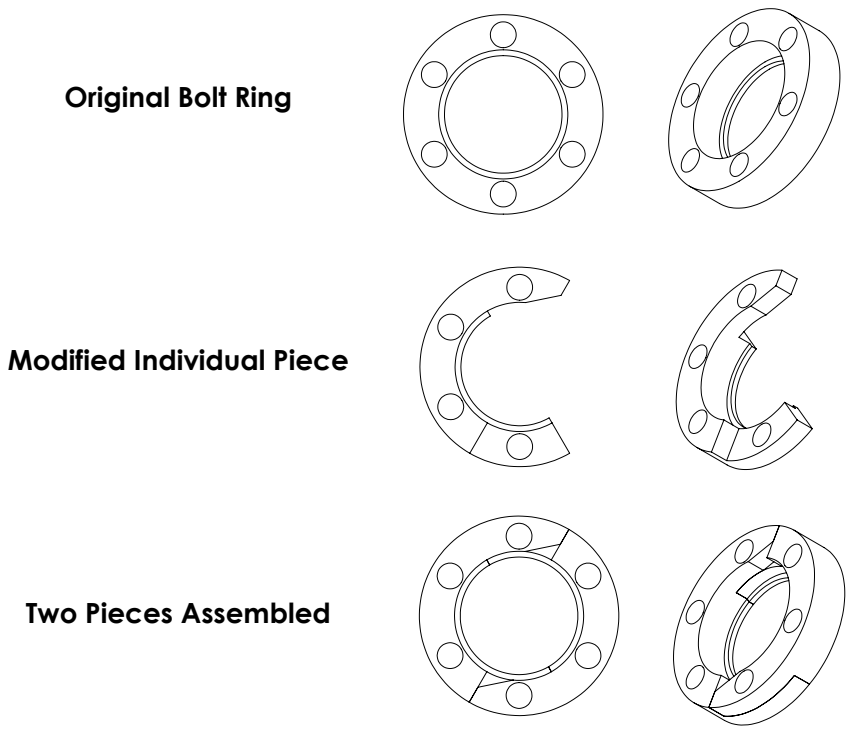
[picture p128: page 1]

Original Bolt Ring

Modified Individual Piece

Two Pieces Assembled

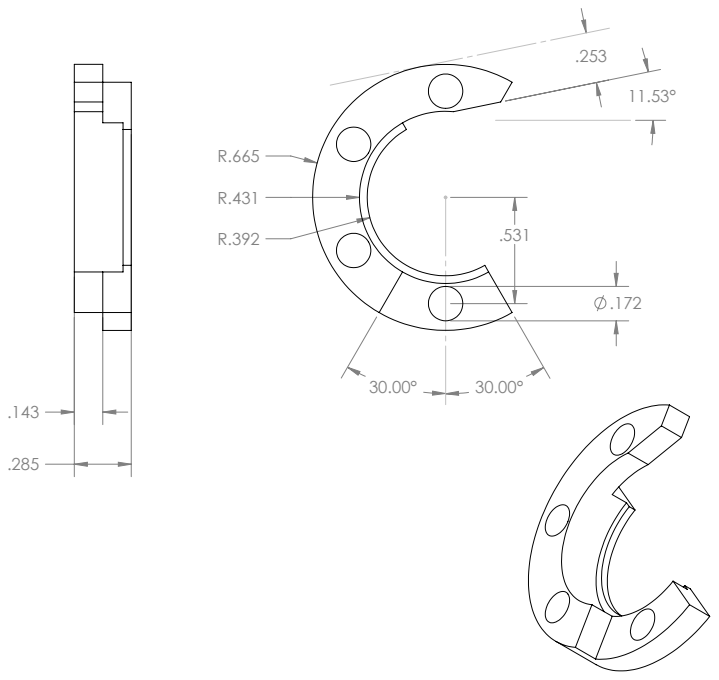
[picture p129: page 2]
