akeshet/New-Machine-Drawings/side bucket extra holes.PDF

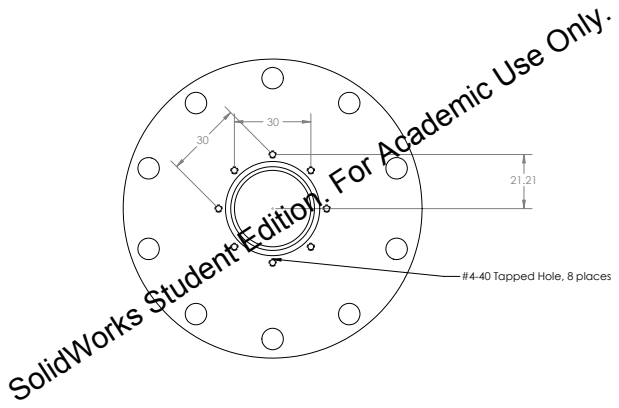
[picture p130: page 1]

#4-40 Tapped Hole, 8 places SolidWorks Student Edition. For Academic Use Only.
