akeshet/New-Machine-Drawings/slower long tube.pdf

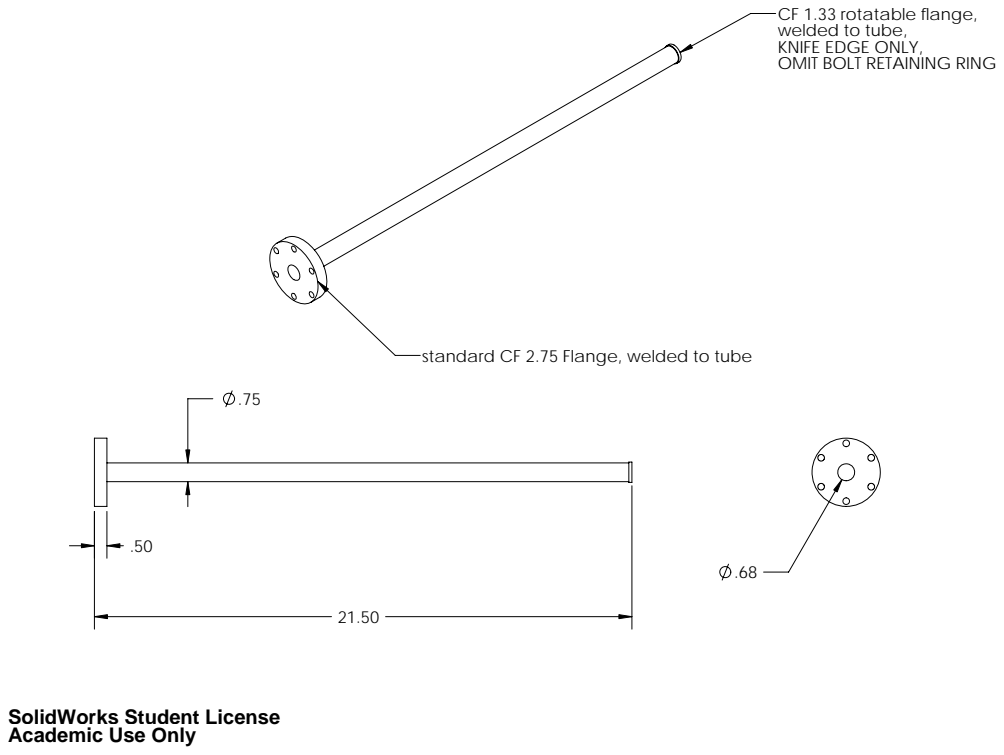
[picture p131: page 1]

CF 1.33 rotatable flange,
welded to tube,
KNIFE EDGE ONLY,
OMIT BOLT RETAINING RING

standard CF 2.75 Flange, welded to tube

SolidWorks Student License
Academic Use Only
