akeshet/New-Machine-Drawings/8020 enclosure rev2/drawing b.PDF

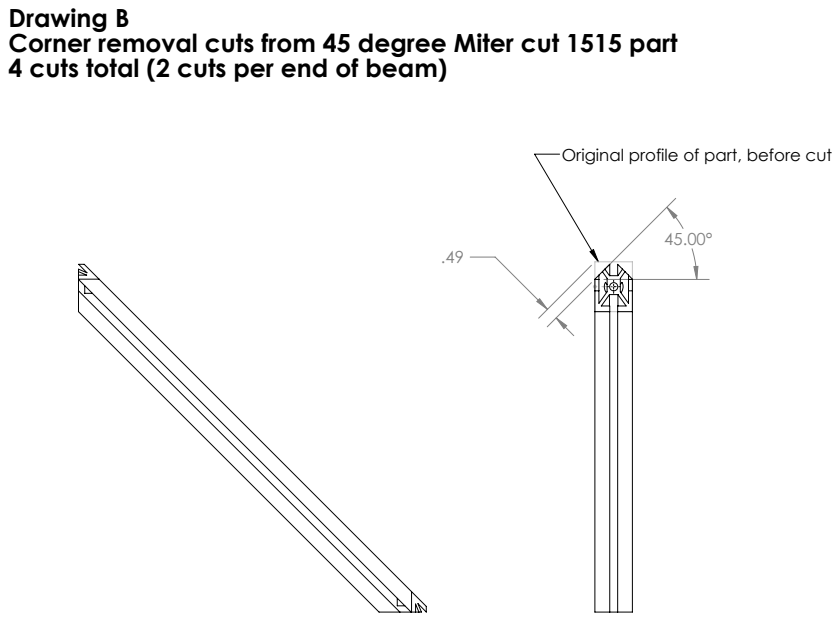
[picture p132: page 1]

Drawing B
Corner removal cuts from 45 degree Miter cut 1515 part
4 cuts total (2 cuts per end of beam)

Original profile of part, before cut
