akeshet/New-Machine-Drawings/drawings/dp tubes quote request.pdf

A A

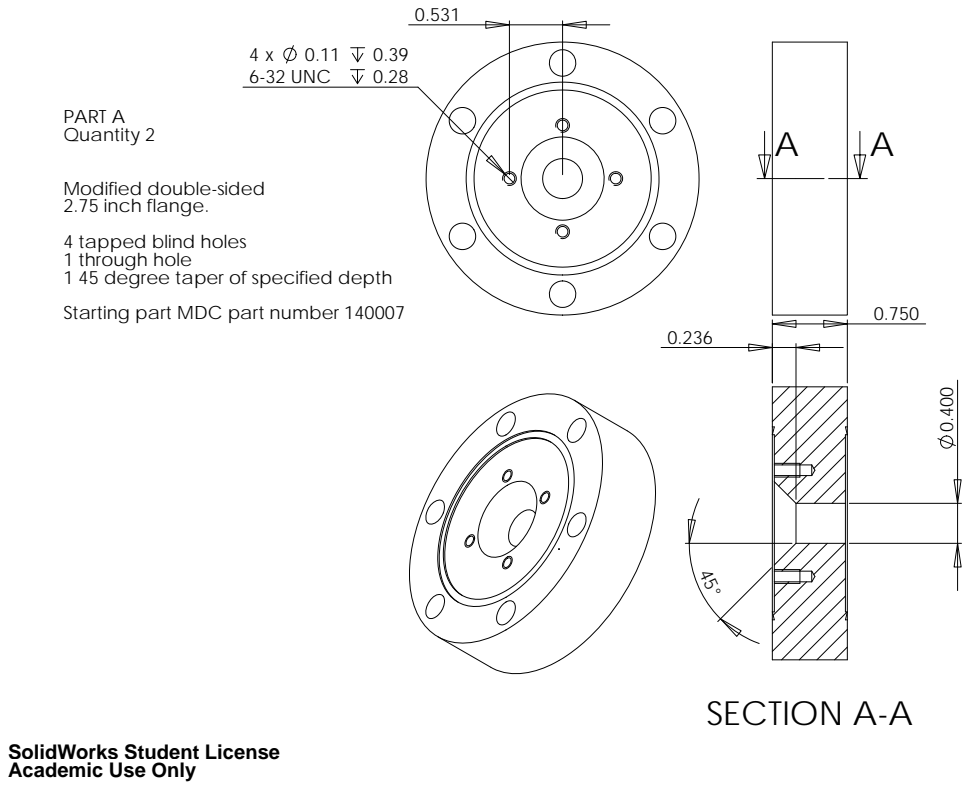
[picture p133: page 1]
6-32 UNC; PART A Quantity 2; SECTION A-A

Modified double-sided
2.75 inch flange.
4 tapped blind holes
1 through hole
1 45 degree taper of specified depth
Starting part MDC part number 140007

SolidWorks Student License
Academic Use Only

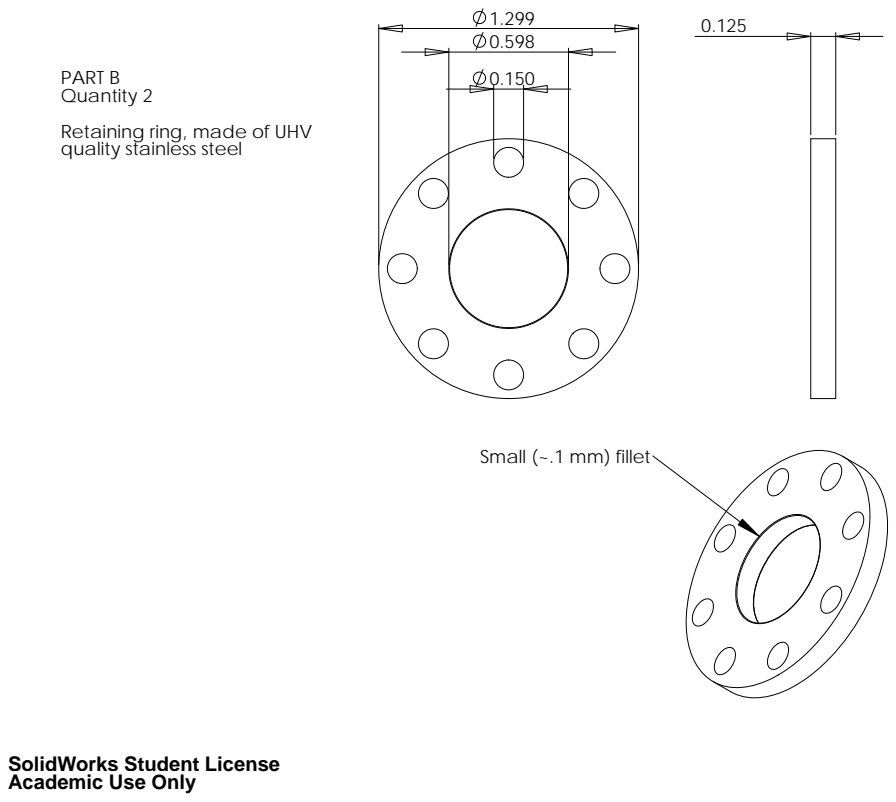
[picture p134: page 2]

PART B
Quantity 2
Retaining ring, made of UHV
quality stainless steel

Small (~.1 mm) fillet

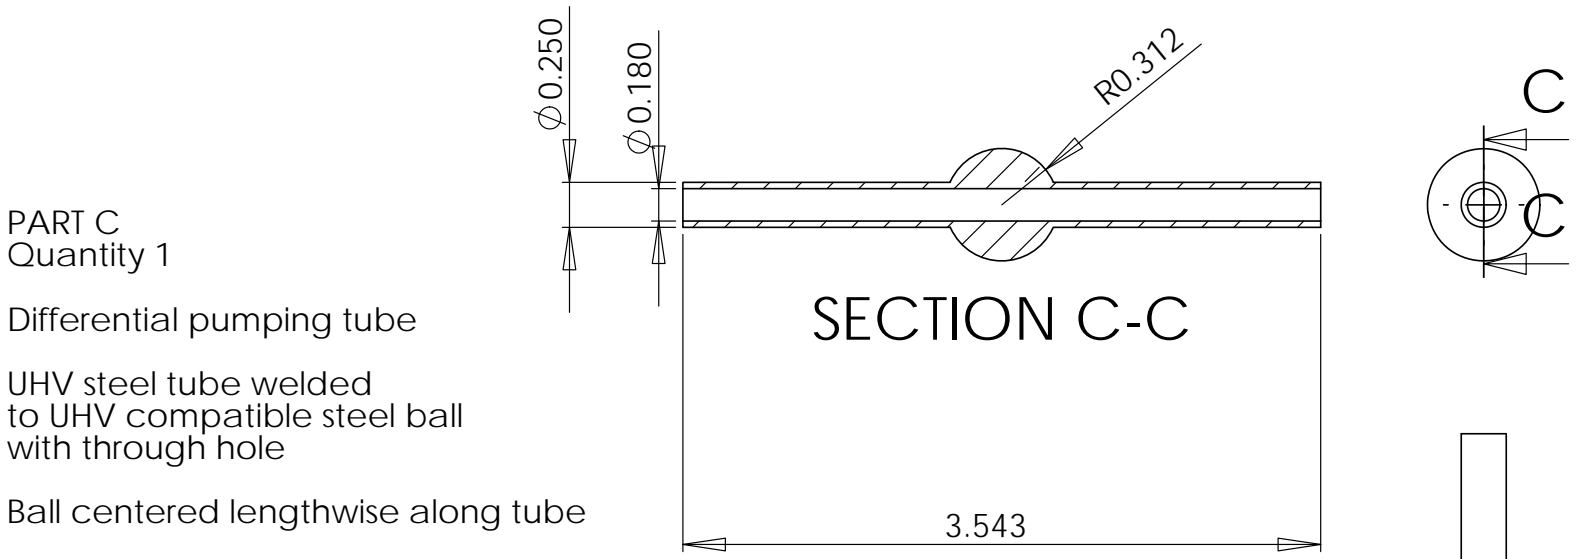
[picture p135: figure]
PART C; Quantity 1; Differential pumping tube; UHV steel tube welded to UHV compatible steel ball with through hole; Ball centered lengthwise along tube; SECTION C-C

Tube cross section is based on
MDC part number 480000 vacuum tubing

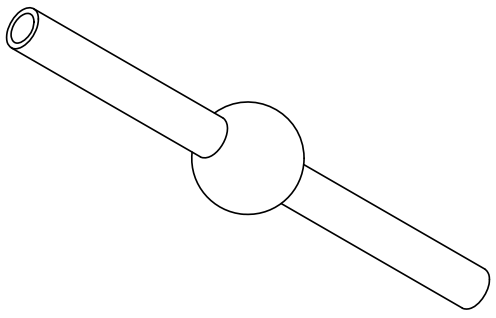
[picture p136: figure]

PART D
Quantity 1
Differential pumping tube 2
Same as PART C, but with a different tube length

D

D

# SECTION D-D

2.362

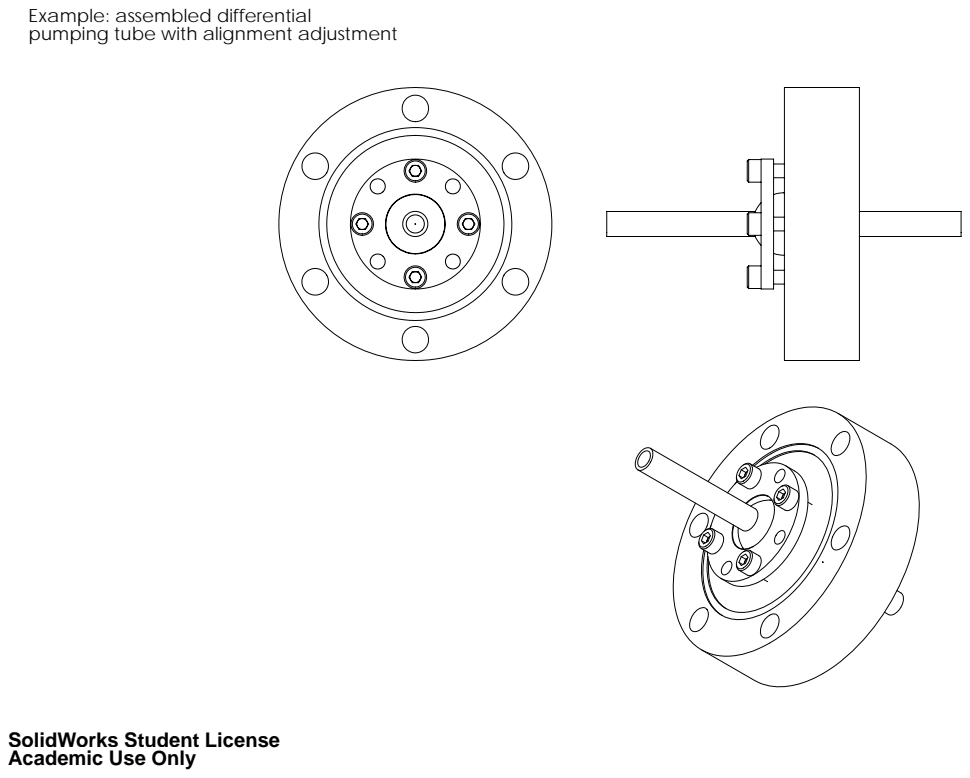
[picture p137: page 5]

Example: assembled differential
pumping tube with alignment adjustment
