akeshet/New-Machine-Drawings/drawings/neg drawing.PDF

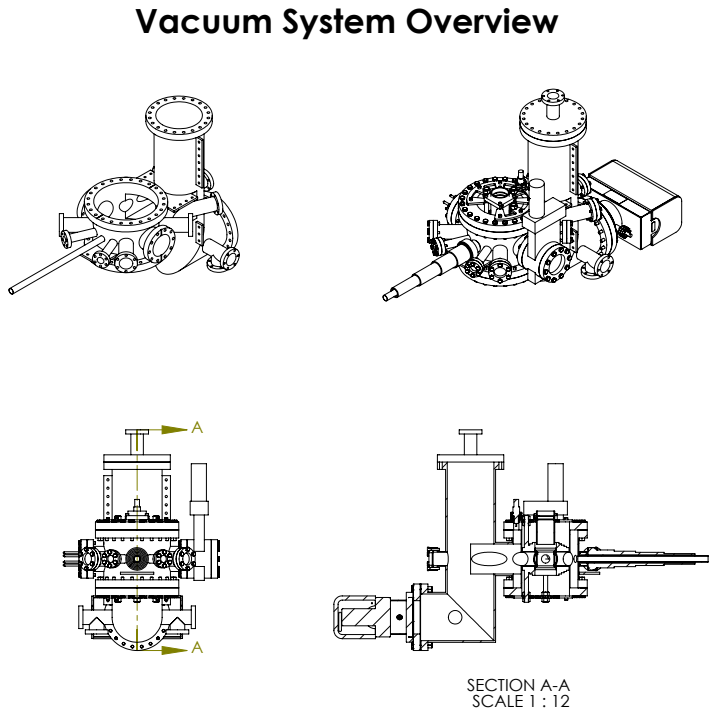
[picture p138: page 1]
SECTION A-A SCALE 1 : 12

Vacuum System Overview

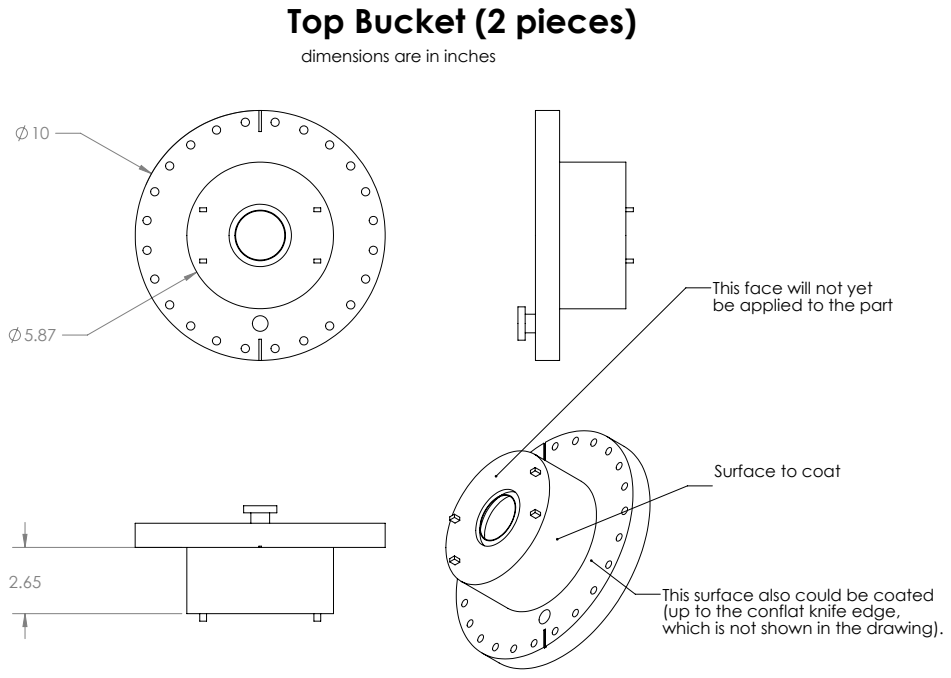
[picture p139: page 2]

Top Bucket (2 pieces)

dimensions are in inches

This face will not yet
be applied to the part

Surface to coat

This surface also could be coated
(up to the conflat knife edge,
which is not shown in the drawing).

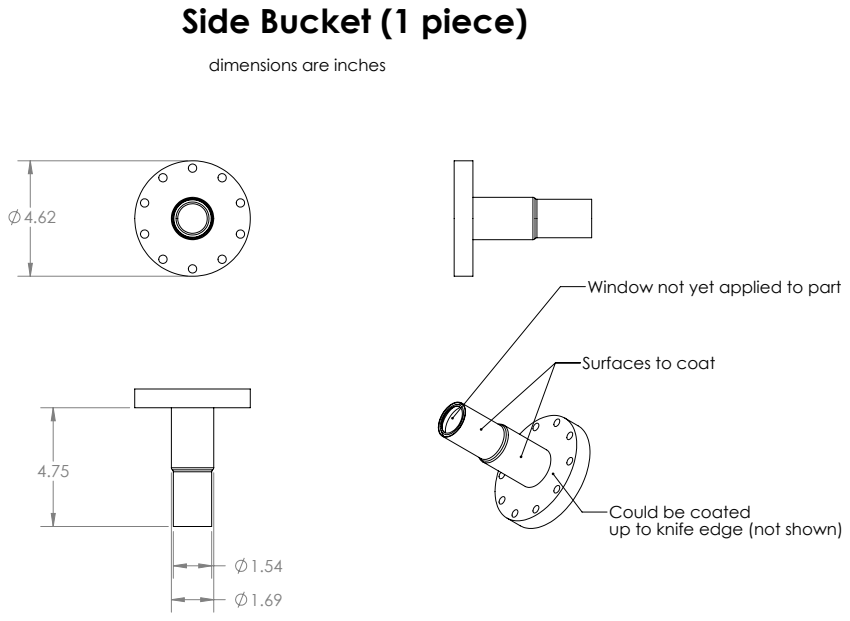
[picture p140: page 3]

Side Bucket (1 piece)

dimensions are inches

Window not yet applied to part

Surfaces to coat

Could be coated
up to knife edge (not shown)
