akeshet/New-Machine-Drawings/drawings/side bucket question draw 1.PDF

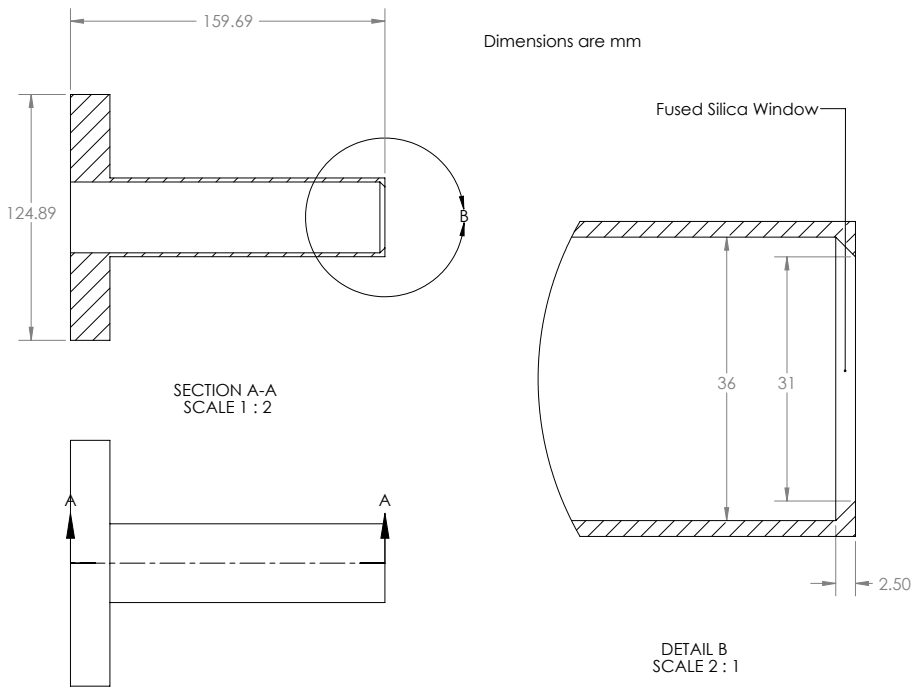
[picture p141: page 1]
SECTION A-A SCALE 1 : 2; DETAIL B SCALE 2 : 1

Dimensions are mm

Fused Silica Window
