akeshet/New-Machine-Drawings/drawings/top bucket assem question draw 1.PDF

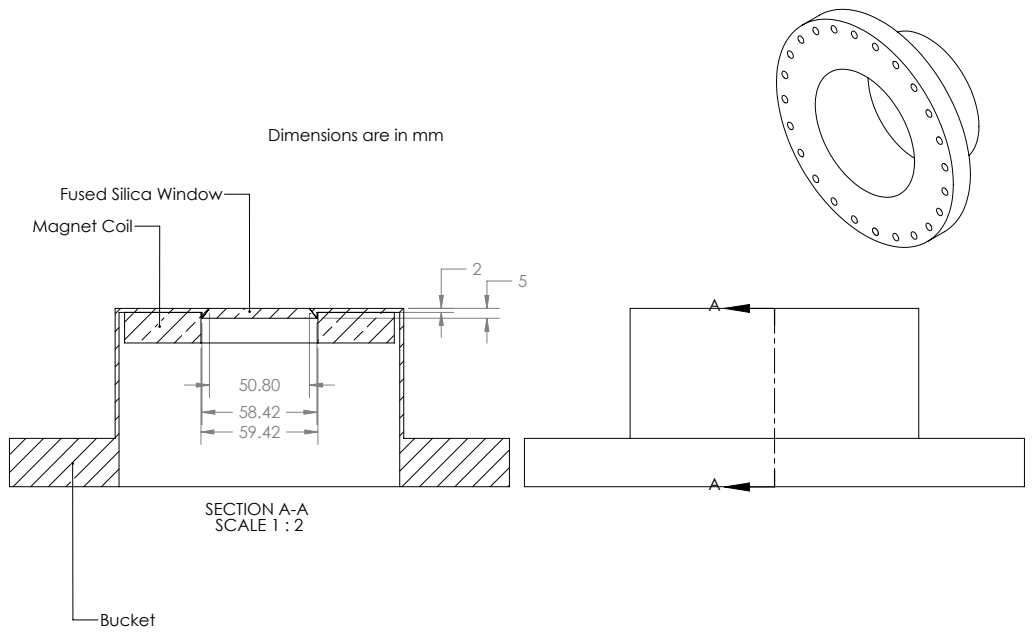
[picture p142: page 1]
SECTION A-A SCALE 1 : 2

Dimensions are in mm

Fused Silica Window
Magnet Coil
