akeshet/New-Machine-Drawings/drawings/quote requests/side bucket quote.PDF

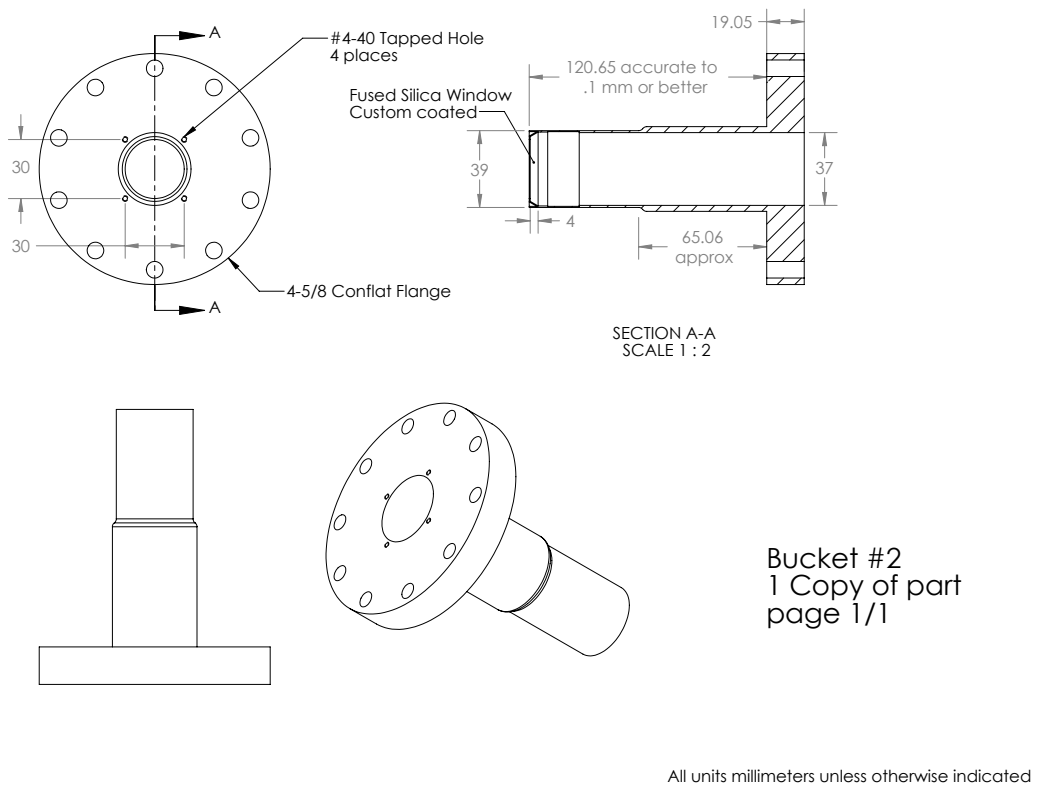
[picture p148: page 1]
4-5/8 Conflat Flange; SECTION A-A SCALE 1 : 2

#4-40 Tapped Hole
4 places
Fused Silica Window
Custom coated

120.65 accurate to
.1 mm or better

Bucket #2
1 Copy of part
page 1/1

All units millimeters unless otherwise indicated
