akeshet/New-Machine-Drawings/drawings/quote requests/top bucket quote.PDF

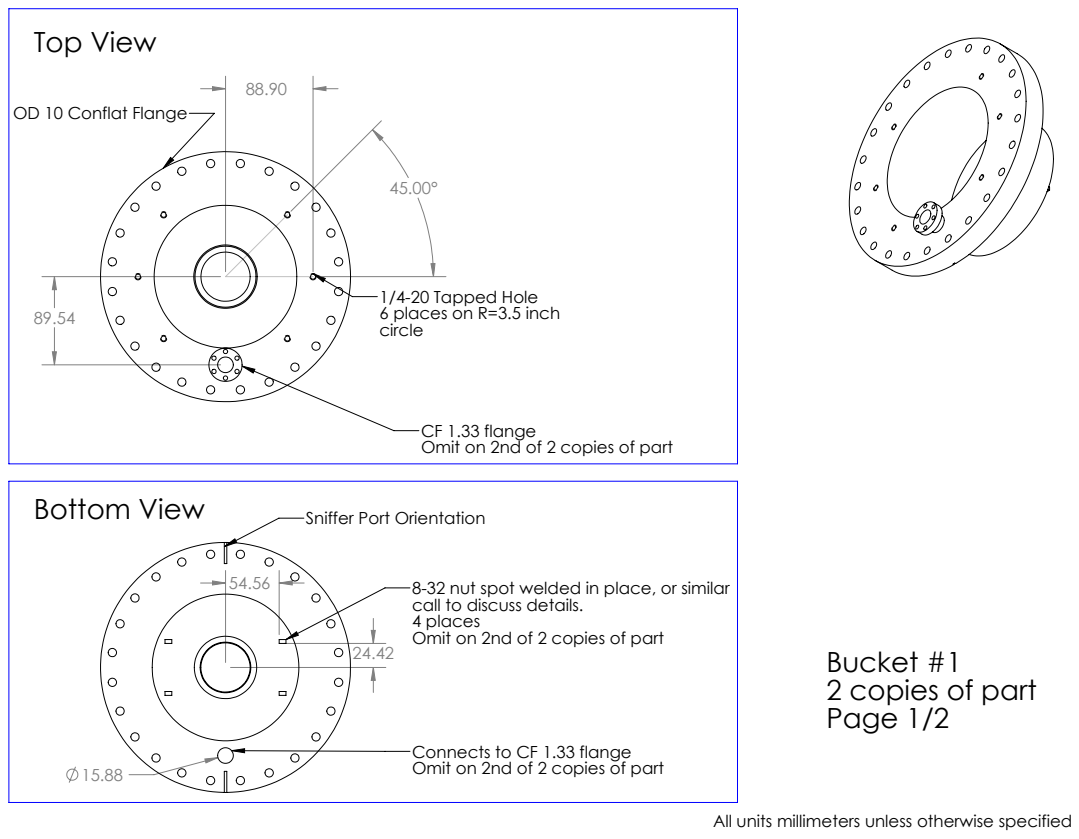
[picture p149: page 1]
Top View; Bottom View

OD 10 Conflat Flange

1/4-20 Tapped Hole
6 places on R=3.5 inch
circle

CF 1.33 flange
Omit on 2nd of 2 copies of part

Sniffer Port Orientation

8-32 nut spot welded in place, or similar
call to discuss details.
4 places

Bucket #1
2 copies of part
Page 1/2

Connects to CF 1.33 flange

All units millimeters unless otherwise specified

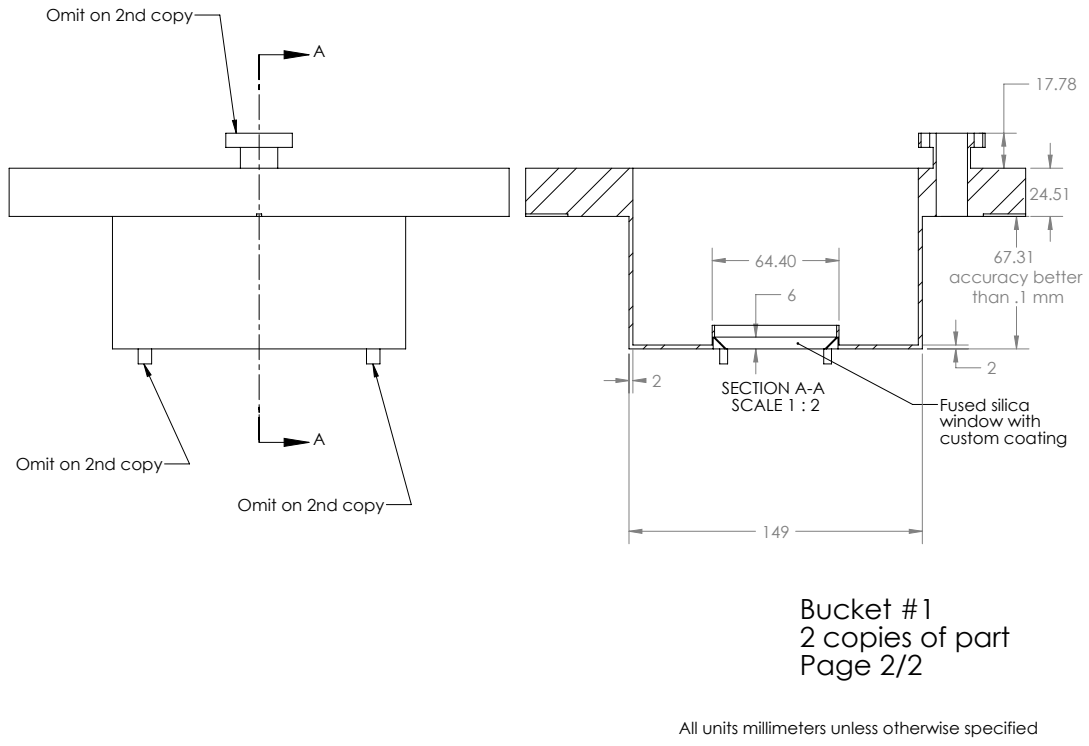
[picture p150: page 2]
accuracy better than .1 mm; SECTION A-A; SCALE 1 : 2; Fused silica; window with custom coating; Bucket #1 2 copies of part Page 2/2

Omit on 2nd copy

All units millimeters unless otherwise specified
