akeshet/New-Machine-Drawings/canopy design.PDF

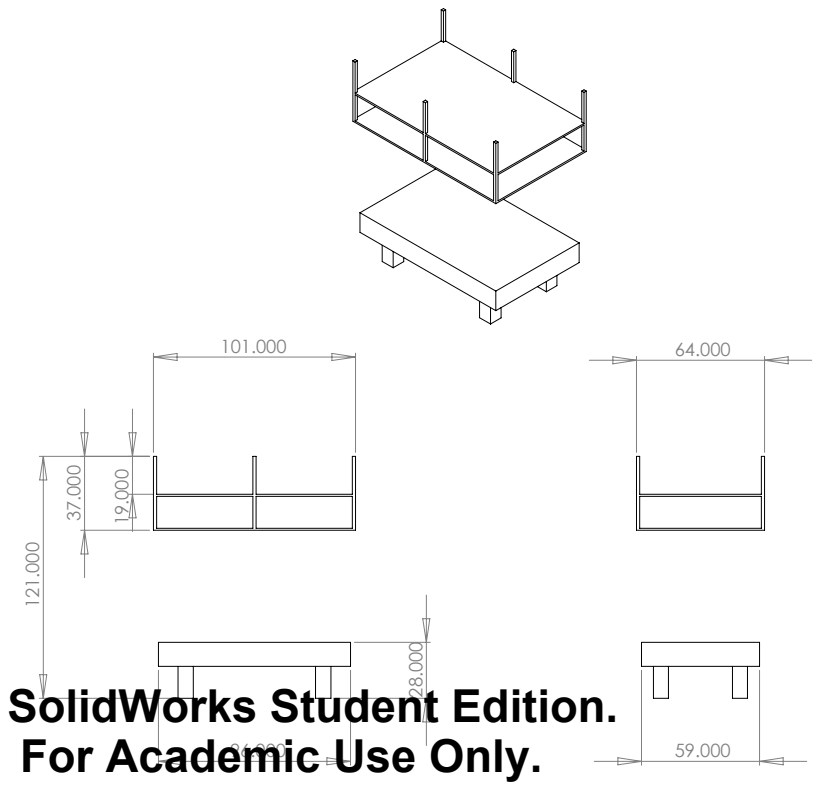
[picture p151: page 1]

SolidWorks Student Edition.
For Academic Use Only.
