akeshet/New-Machine-Drawings/custom breadboard preliminary.PDF

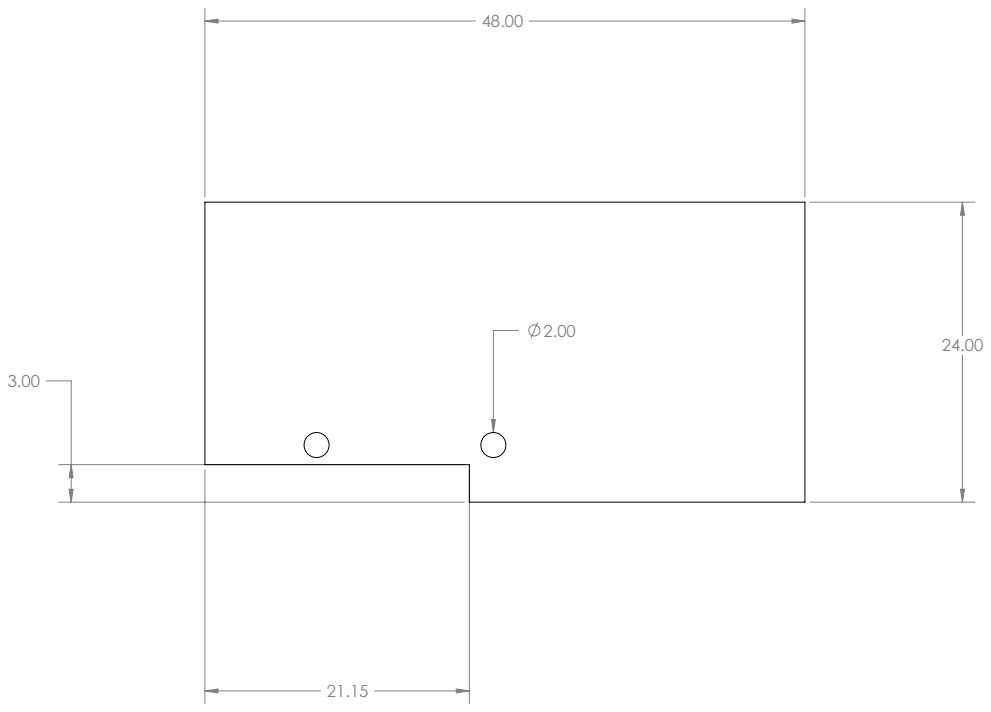
[picture p152: page 1]
