akeshet/New-Machine-Drawings/full machine.PDF

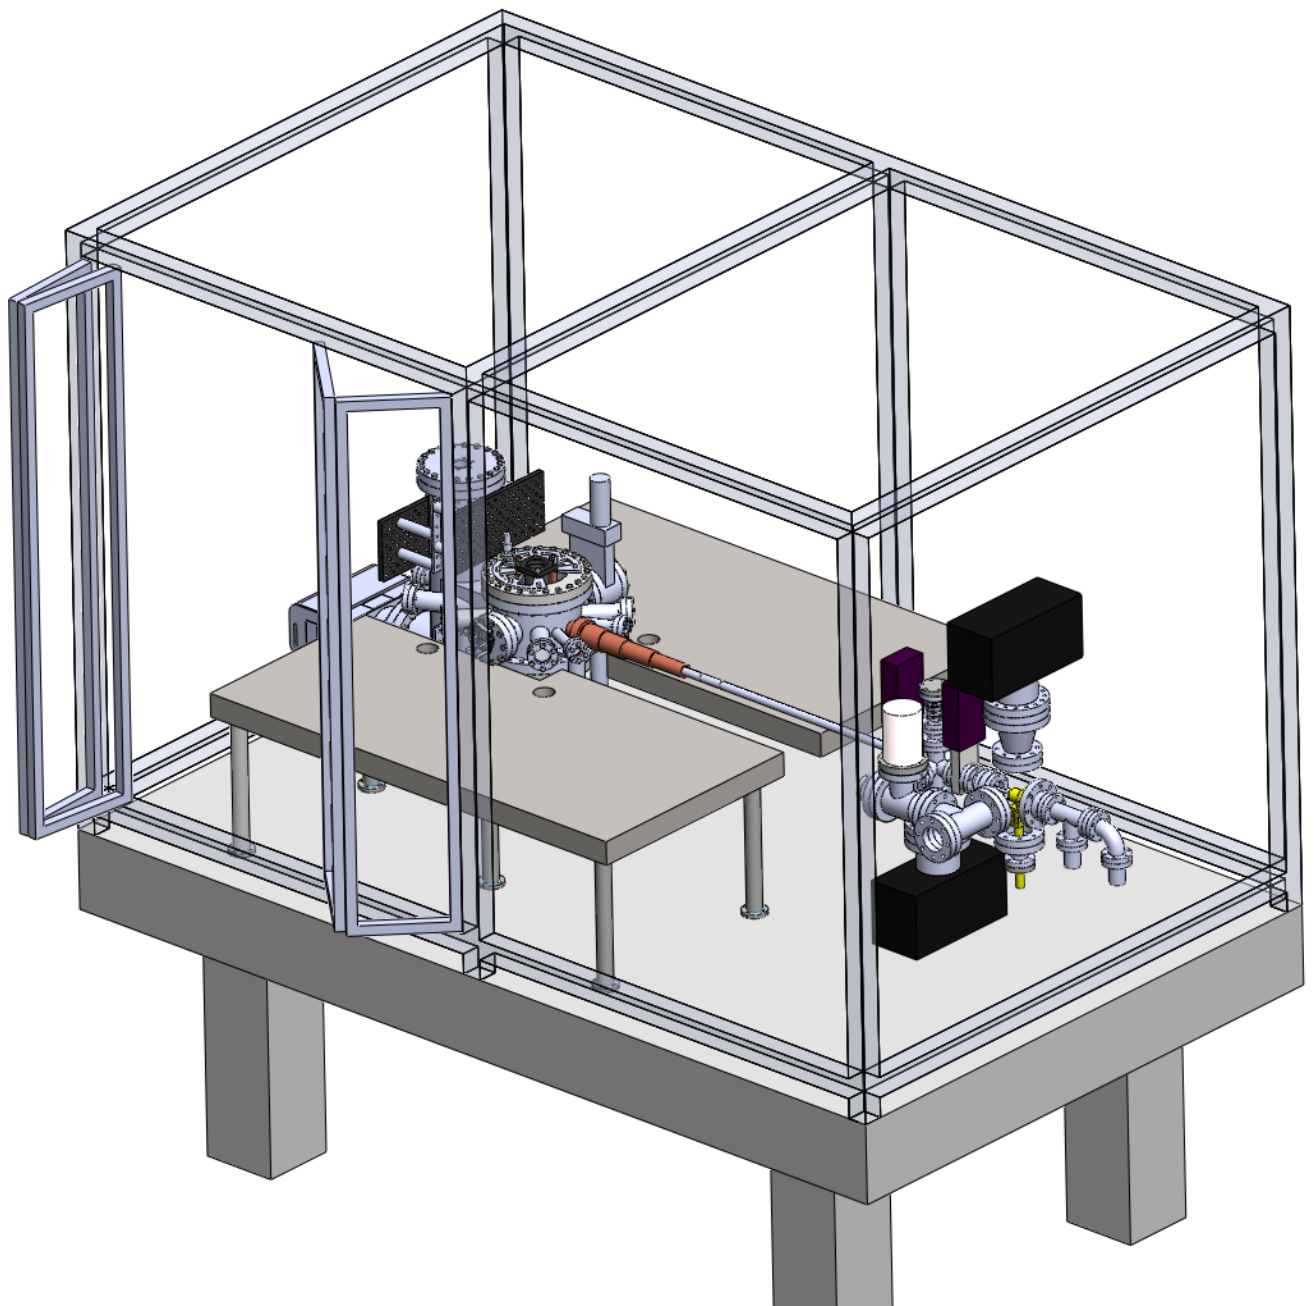
[picture p153: page 1]
