akeshet/New-Machine-Drawings/imaging systems.PDF

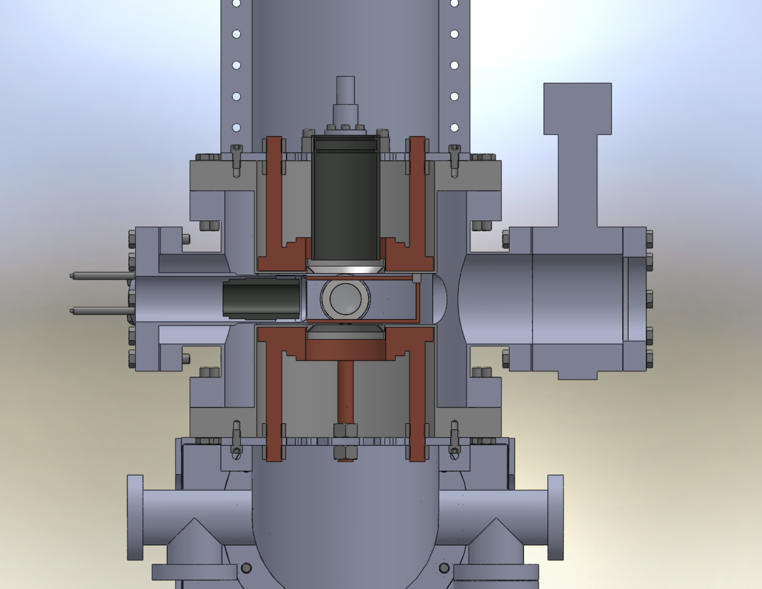
[picture p154: page 1]
