akeshet/New-Machine-Drawings/main_chamber extremal dimensions.PDF

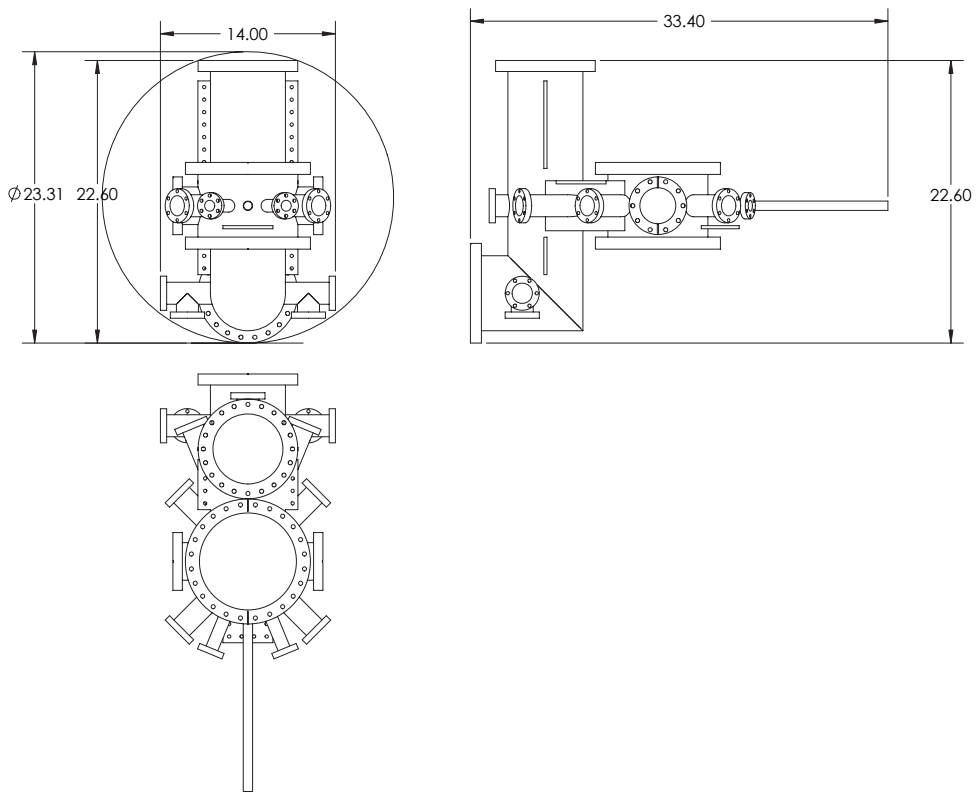
[picture p155: page 1]
