akeshet/New-Machine-Drawings/drawings/custom breadboard inquiry.PDF

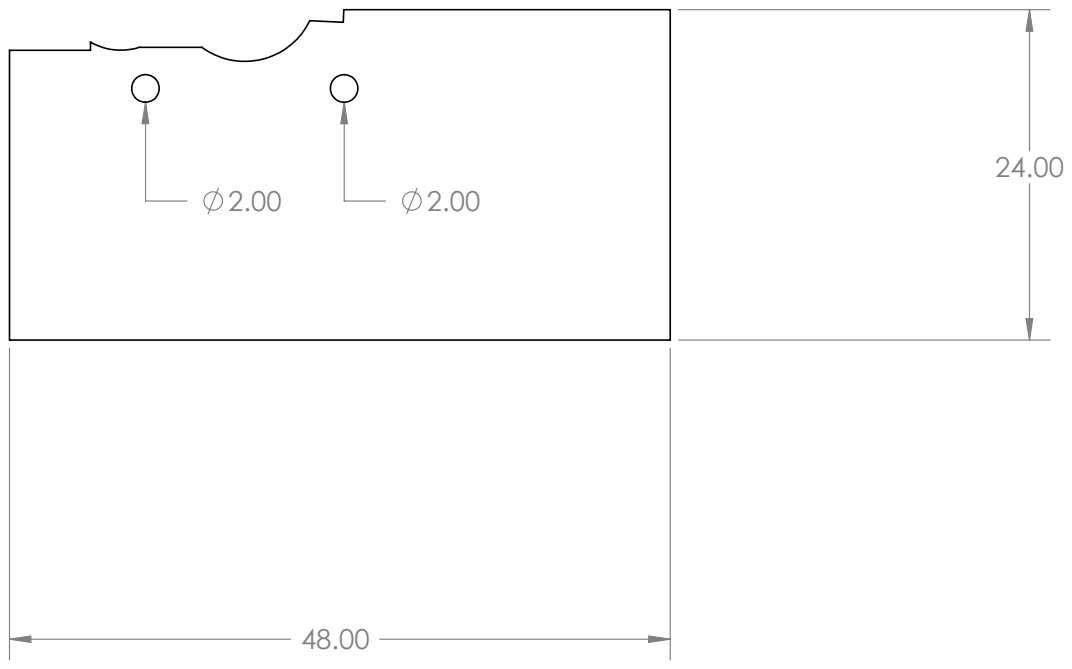
[picture p156: page 1]
