akeshet/New-Machine-Drawings/drawings/top bucket nut locations.PDF

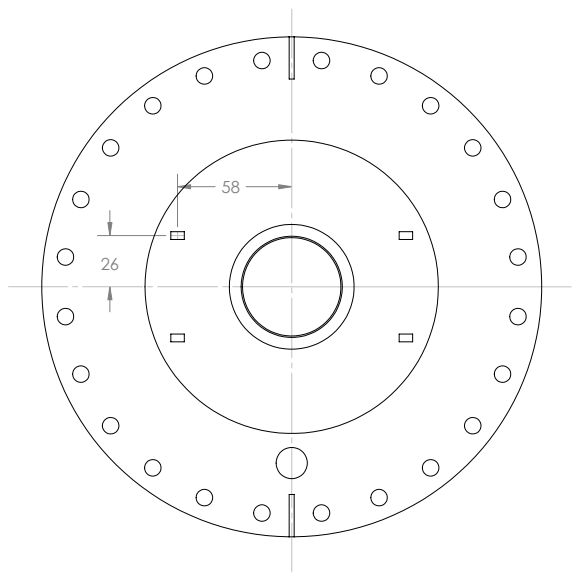
[picture p157: page 1]
