akeshet/New-Machine-Drawings/drawings/vacuum_chamber_inquiry.PDF

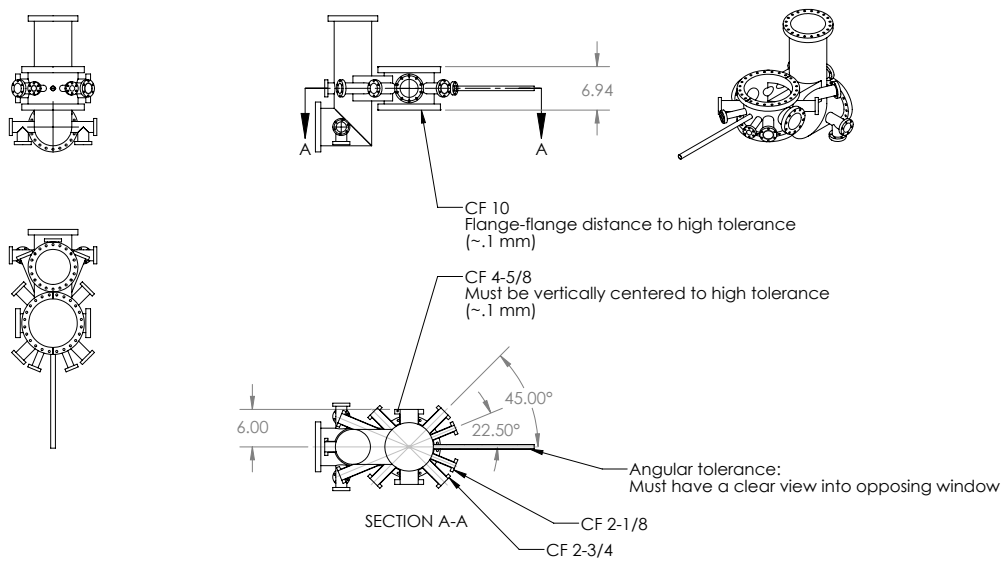
[picture p158: page 1]
SECTION A-A

Flange-flange distance to high tolerance
Must be vertically centered to high tolerance

Angular tolerance:
Must have a clear view into opposing window
