akeshet/New-Machine-Drawings/misc/window tube inquiry.PDF

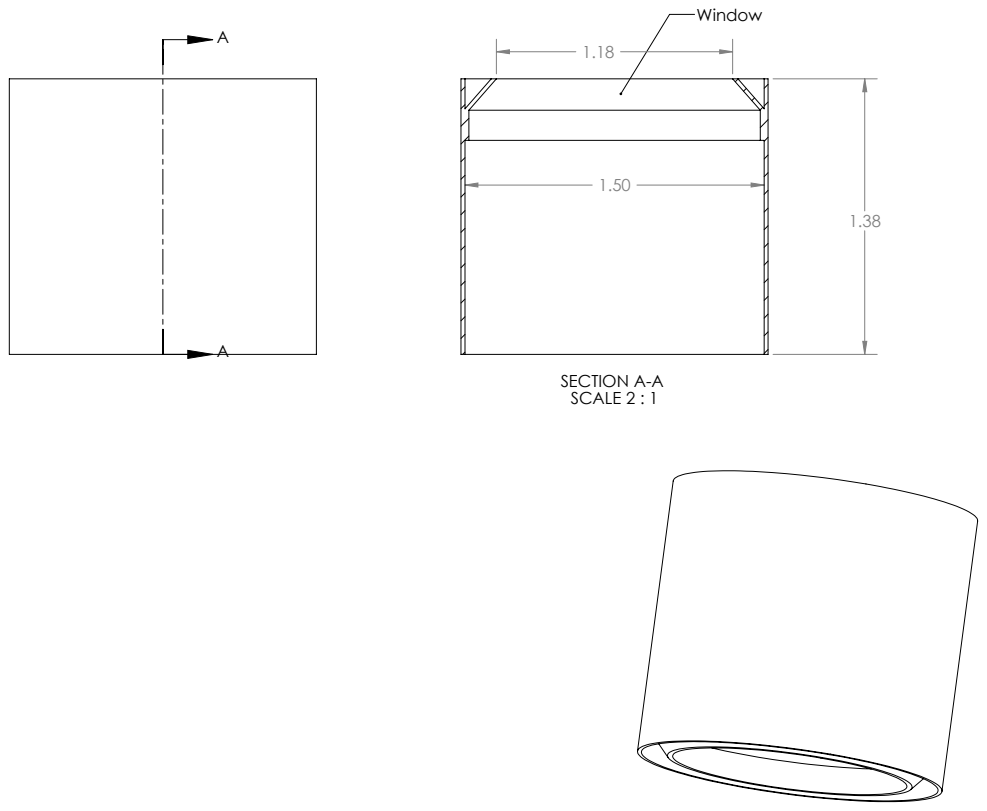
[picture p159: page 1]
SECTION A-A SCALE 2 : 1
