akeshet/New-Machine-Drawings/8020 enclosure/drawing a.PDF

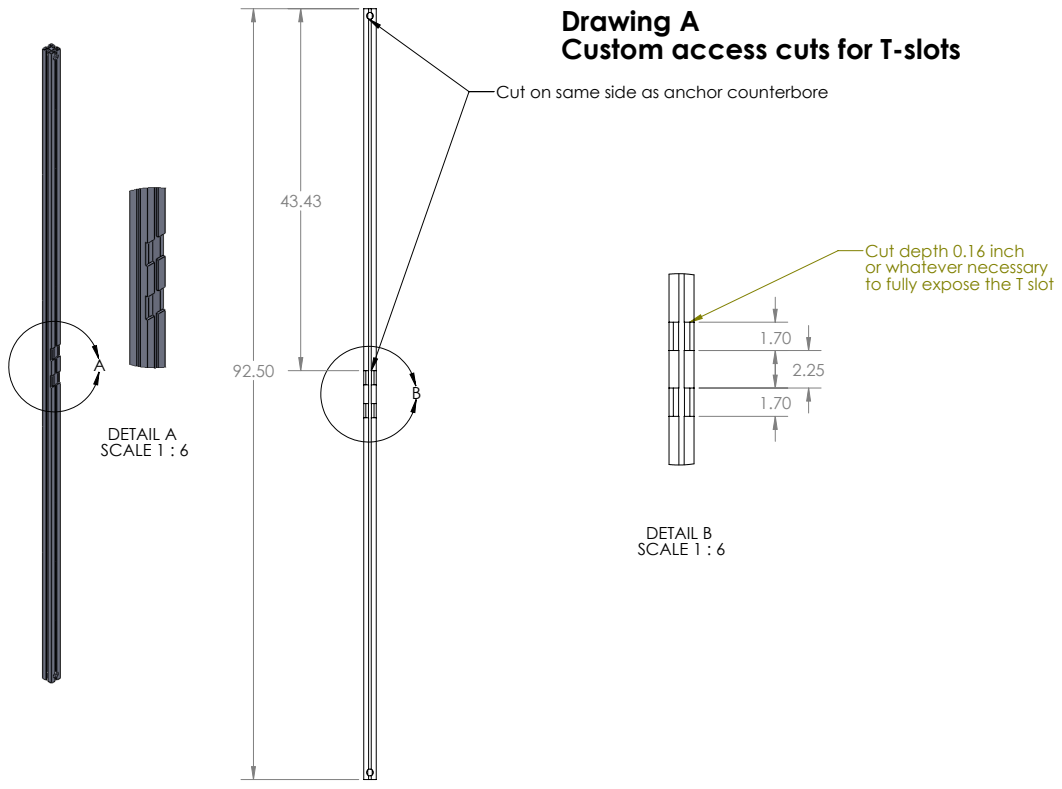
[picture p160: page 1]
DETAIL A SCALE 1 : 6; DETAIL B SCALE 1 : 6

Drawing A
Custom access cuts for T-slots

Cut on same side as anchor counterbore

Cut depth 0.16 inch
or whatever necessary
to fully expose the T slot
