akeshet/New-Machine-Drawings/8020 enclosure/enclosure.PDF

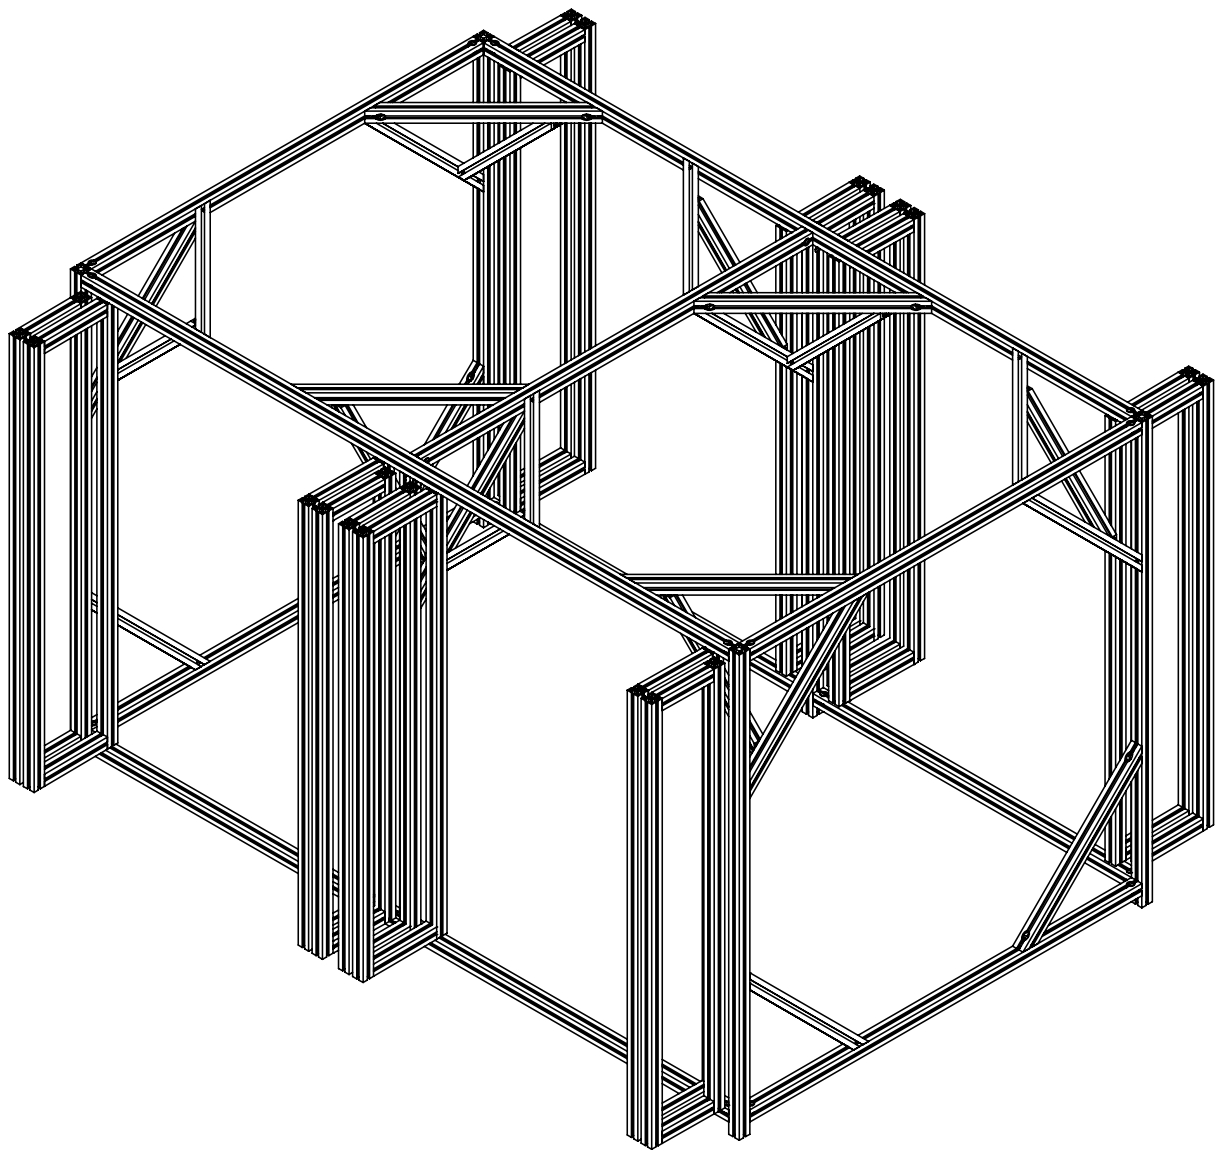
[picture p161: page 1]
