akeshet/New-Machine-Drawings/(commit log)

2011-03-22 First commit.
    [1 inch atom cloud.SLDPRT, 1010 door vertical.SLDPRT, 1010 fully open door.SLDASM, 1010 guidebar.SLDPRT, 1010 narrow door horiz.SLDPRT, 1010 narrow door.SLDASM, 1010 wide door horiz.SLDPRT, 1010 wide door.SLDASM]
2011-05-12 Added magnetic coil simulations.
2011-05-13 Added water supply manifold.
    [20 output union cross valved manifold.SLDASM, manifold dual valve breakout subunit.SLDASM, manifold single valve reducing t subunit.SLDASM, movable dp tube stage.SLDASM, room renovation drawing.SLDDRW, second dp tube stage.SLDASM, supply manifold.SLDASM, swagelok 400-4 union cross.SLDPRT]
2011-05-13 Lowered and thickened table.
    [table.SLDPRT]
2011-05-13 Reasonably compact water input/output manifold.
    [20io water manifold.SLDASM, 45 holder legs.sldprt, Oven holder legs.sldprt, current manifold holding bar.sldprt, manifold single valve reducing t subunit.SLDASM, proteus flow meter.SLDPRT, return manifold staggered.SLDASM, return manifold.SLDASM]
2011-05-16 Fixed handedness of waver flowmeter
    [20io water manifold.SLDASM, return manifold staggered.SLDASM, valved flow meter return subunit.SLDASM]
2011-05-24 Added coil drawing
    [coil diagram.sch]
2011-05-24 Changes to water manifolod.
    [20io water manifold.SLDASM, manifold single valve reducing t subunit.SLDASM, supply manifold.SLDASM, swagelok b-4tf-90 filter.SLDPRT]
2011-05-24 Random changes due to solidworks caching.
    [coil diagram.sch, movable dp tube stage.SLDASM, second dp tube stage.SLDASM]
2011-05-26 Added drawing of microwave antenna which we probably won't use.
2011-05-26 Modified water manifold to reflect cheaper swagelok parts.
    [20io water manifold.SLDASM, coil diagram.sch, manifold single valve reducing t subunit.SLDASM, return manifold staggered.SLDASM, supply manifold.SLDASM, valved flow meter return subunit.SLDASM]
2011-06-02 Relaymaster frontpanel drawing
    [relaymaster 499 front panel.DXF, relaymaster 499 front panel.SLDDRW, relaymaster 499 front panel.SLDPRT]
2011-06-06 air and relay box front panels for waterjet
    [airmaster.DXF, airmaster.SLDDRW, airmaster.SLDPRT, relaymaster 499 front panel.DXF, relaymaster 499 front panel.SLDDRW, relaymaster 499 front panel.SLDPRT]
2011-06-23 Progress on rev2 8020 enclosure.
    [corner post.SLDPRT, enclosure rev2.SLDASM, guidebar.SLDPRT, lower long.SLDPRT, lower short.SLDPRT, mid post.SLDPRT, upper long.SLDPRT, upper short.SLDPRT]
2011-06-23 Drawings of canopy and table position.
    [canopy design.SLDASM, canopy design.SLDDRW, canopy.sldprt, table.SLDPRT]
2011-06-23 Doors for rev2 enclosure -- not yet sized correctly.
    [door narrow.SLDPRT, door vertical.SLDPRT, door wide.SLDPRT, enclosure rev2.SLDASM, narrow door.SLDASM, wide door.SLDASM]
2011-06-23 Correct horizontal door sizing
    [door narrow.SLDPRT, door wide.SLDPRT, enclosure rev2.SLDASM, narrow door.SLDASM, wide door.SLDASM]
2011-06-24 Added cross supports.
    [45 degree support beam.SLDPRT, enclosure rev2.SLDASM, shorter 45 degree piece.SLDPRT]
2011-06-24 Added canopy and enclosure to full machine assembly.
    [45 holder legs.sldprt, Oven holder legs.sldprt, canopy.sldprt, current manifold holding bar.sldprt]
2011-07-06 Shutter design using mdc clamp to hold flag.
    [4.5 double mini feedthrough.SLDPRT, mdc flag holder.SLDPRT, movable dp tube stage.SLDASM, second dp tube stage.SLDASM, shutter assembly.SLDASM, shutter flag plate.sldprt, shutter shaft.SLDPRT]
2011-07-06 New folded sheet-metal based shutter flag design.
    [shutter assembly.SLDASM, shutter shaft.SLDPRT]
2011-07-26 Small dimension fixes to enclosure. Added counterbore holes for hanging. Added parts list file to get quote.
    [door narrow.SLDPRT, door wide.SLDPRT, enclosure rev2 parts list.xlsx, enclosure rev2.SLDASM, guidebar.SLDPRT, lower long.SLDPRT, lower short.SLDPRT, mid post.SLDPRT]
2011-07-26 Solidwork makes various meaningless file modifications.
    [enclosure rev2.SLDASM, movable dp tube stage.SLDASM, second dp tube stage.SLDASM, shutter assembly.SLDASM]
2011-08-22 Added VAT valve drawing.
    [vat valve footprint.SLDPRT]
2011-08-22 Added VAT valve to drawing. Millions of parts changed for no good reason.
    [1 inch atom cloud.SLDPRT, 1x5 magtrap current manifold board.SLDPRT, 2 inch lens tube.SLDPRT, 20io water manifold.SLDASM, 4.5 double mini feedthrough.SLDPRT, 45 holder legs.sldprt, 45 holder plate.SLDPRT, 45S-4V_KG_SW0001.SLDPRT]
2011-08-22 Fixed mates in vat valve
2011-08-22 Added addional minlength nipple between vat valve and cube.
    [45 holder legs.sldprt]
2011-08-29 Corrected error in panel sizing.
    [enclosure rev2 parts list.xlsx]
2011-09-06 Added drawings of shutter assembly parts.
    [Collimation Plate.SLDDRW, Flag.SLDDRW, shutter shaft.SLDDRW]
2011-09-06 Changes to shutter assembly.
    [shutter assembly.SLDASM]
2011-09-06 Commiting all changes associated with shutter assembly.
    [Collimation Plate.sldprt, movable dp tube stage.SLDASM, second dp tube stage.SLDASM]
2011-10-11 Coil mounting plate to own file. Other random changes.
    [Collimation Plate.SLDDRW, Flag.SLDDRW, coil mounting plate.SLDPRT, movable dp tube stage.SLDASM, second dp tube stage.SLDASM, shutter assembly.SLDASM, shutter shaft.SLDDRW]
2011-10-22 Added special optics lens.
    [special optics lens footprint.SLDPRT]
2011-10-22 Added flag.
    [Flag.sldprt]
2011-11-02 Top breadboard ideas
    [21620.SLDASM, top breadboard alternate design.SLDPRT, top breadboard.SLDPRT, top wiring exlusion zone.SLDPRT]
2011-11-02 Top breadboard design modifications
    [movable dp tube stage.SLDASM, second dp tube stage.SLDASM, shutter assembly.SLDASM, slower breadboard.SLDPRT, top breadboard alternate design.SLDPRT]
2011-11-02 Drawings for waterjet.
    [top breadboard alternate design noholes.DXF, top breadboard alternate design noholes.SLDDRW, top breadboard alternate design noholes.SLDPRT]
2011-12-12 Drawings of new enclosure for sodium laser table, adapted from the experiment enclosure design.
    [Na corner post.SLDPRT, Na door vert.SLDPRT, Na enclosure materials.xlsx, Na enclosure.SLDASM, Na lower end.SLDPRT, Na lower side.SLDPRT, Na midpost.SLDPRT, Na narrow door horiz.SLDPRT]
2012-07-12 A long overdue commit of many random changes.
    [275 holder plate.SLDPRT, 45 degree support beam.SLDPRT, 6 holder plate.SLDPRT, Na enclosure materials.xlsx, coil cartoon.SLDDRW, coil cartoon.SLDPRT, corner post.SLDPRT, door narrow.SLDPRT]
